elegooofficial/Mars3/README.md

# Mars3
ELEGOO Mars3 Ultra 4k Mono LCD 3D Printer
