elegooofficial/Mars3/MARS 3 BOM.xlsx

研发专用附表 |  |  |  |  |  |  |  | （ MARS 3） BOM
成品料号 |  | 14.0009.100 | 14.0009.101 | 14.0009.104 | 14.0009.102 | 14.0009.103 | 14.0009.106 | S/N | Name | Specification | Qty
取用列 | 不共用物料明细 |  |  |  |  |  |  | 1 | MARS 3 Z-axis connection block | Material; aluminum alloy, die-casting, oil-sprayed black Size; 105*46*55mm | 1
#REF! | 料号 | 04.0010.19 | 04.0010.06C | 04.0010.07B | 04.0010.08B | 04.0010.10B | 04.0010.18 | 2 | MARS 3 medium plate | Material; aluminum alloy, sandblasted and oxidized purplish red Size: 225*225*6mm | 1
#REF! | 名称 | A1 | 电源线 | 电源线 | 电源线 | 电源线 | 电源线 | 3 | MARS 3 - Heat sink | Copper tube + heat sink aluminum sheet Refer to the drawings for the details. | 1
#REF! | 规格 | 品子尾 三孔 3*0.75平方 长度1m/国标 | 品子尾 三孔 3*0.824平方 长度1.0m/美规 | 品子尾 三孔 3*0.75平方 长度1.0m/欧规 | 品子尾 三孔 3*0.75平方 长度1.0m/英规 | 品子尾 三孔 3*0.75平方 长度1.0m/澳规 | 品子尾 三孔 3*0.75平方 长度1.0m/巴西规 | 4 | MARS 3 - Build platform board | Material: Aluminum alloy, sandblasted construction surface, sandblasted and oxidized black for non-construction surface. Size: 150*95.6*10mm | 1
#REF! | 数量 | 1 | 1 | 1 | 1 | 1 | 1 | 5 | MARS 3 - Line rail fixing plate | Aluminum profile+oxidized black | 1
#REF! | 料号 | 11.0001.129 | 11.0001.118 | 11.0001.118 | 11.0001.118 | 11.0001.118 | 11.0001.118 | 6 | MARS 3 - Plate | Die-cast, oil-sprayed black | 1
#REF! | 名称 | MARS 3 国标铭牌标贴 | MARS 3 铭牌标贴 | MARS 3 铭牌标贴 | MARS 3 铭牌标贴 | MARS 3 铭牌标贴 | MARS 3 铭牌标贴 | 7 | 304 stainless steel stud | M8*30 double thread The length is 12mm | 1
#REF! | 规格 | 尺寸：79.8*54.8mm | 尺寸：79.8*54.8mm | 尺寸：79.8*54.8mm | 尺寸：79.8*54.8mm | 尺寸：79.8*54.8mm | 尺寸：79.8*54.8mm | 8 | LCD1260-A1 card | Refer to the drawings for the details. | 1
#REF! | 数量 | 1 | 1 | 1 | 1 | 1 | 1 | 9 | Spring 0.8*12*35 | Stainless steel wire diameter: 0.8 Outer diameter: 12 height: 35 | 1
#REF! | 料号 | 11.0001.128 | 11.0001.113 | 11.0001.114 | 11.0001.115 | 11.0001.116 | 11.0001.130 | 10 | MARS - Five-star handle | Handle injection screw M10*17 screw extension length 17mm screw nickel plating treatment | 1
#REF! | 名称 | MARS 3 国标标签 | MARS 3 美规标签 | MARS 3 欧规标签 | MARS 3 英规标签 | MARS 3 澳规标签 | MARS 3 巴西标签 | 11 | PTZ ball | 15*M8*15 | 1
#REF! | 规格 | 直径18mm 80g不干胶哑膜 | 直径18mm 80g不干胶哑膜 | 直径18mm 80g不干胶哑膜 | 直径18mm 80g不干胶哑膜 | 直径18mm 80g不干胶哑膜 | 直径18mm 80g不干胶哑膜 | 12 | MARS 3 - Lower pressure plate of resin tank | Material: SPCC, electrophoretic black Size: 186.5*135*2.5mm | 1
#REF! | 数量 | 1 | 1 | C3 | C4 | C5 | C6 | 13 | MARS 3 - Upper pressure plate of resin tank | Material: SPCC, electrophoretic black Size: 186.5*135*2.5mm | 1
#REF! | 料号 | D1 | D2 | D3 | D4 | D5 | D6 | 14 | MARS 3 - C2 mainboard bracket | Material: ABS, black Size: 135*16*11mm | 1
#REF! | 名称 | D1 | D2 | D3 | D4 | D5 | D6 | 15 | MARS 3 - Lens pressure plate | Material: SPCC, electrophoretic black Size: 89.2*79.2*1mm | 1
#REF! | 规格 | D1 | D2 | D3 | D4 | D5 | D6 | 16 | MARS 2 series - Limit Switch Baffle | spcc T=1.5mm | 1
#REF! | 数量 | D1 | D2 | D3 | D4 | D5 | D6 | 17 | MARS 3 - Base | Material: ABS, black Size; 227*227*19mm | 1
#REF! | 料号 | E1 | E2 | E3 | E4 | E5 | E6 | 18 | MARS 3 - Shell | Material: ABS, black Size: 227*227*135.5mm | 1
#REF! | 名称 | E1 | E2 | E3 | E4 | E5 | E6 | 19 | MARS 3 - Back cover | Material: ABS, black Size: 164.8*118*10mm | 1
#REF! | 规格 | E1 | E2 | E3 | E4 | E5 | E6 | 20 | MARS 3 - 3.5 inch screen bracket | Material: ABS, black Size: 93.6*76.5*3.9mm | 1
#REF! | 数量 | E1 | E2 | E3 | E4 | E5 | E6 | 21 | MARS 3 - Button cap | Material: ABS, black Size: φ15.8*6.5mm | 1
#REF! | 料号 | F1 | F2 | F3 | F4 | F5 | F6 | 22 | MARS 3 - Lens Hood | Material: ABS, black Size: 136*101*90mm | 1
#REF! | 名称 | F1 | F2 | F3 | F4 | F5 | F6 | 23 | MARS 3 - Resin tank | Material; aluminum alloy, die-casting, oil-sprayed black Size; 209*140*32.8mm | 1
#REF! | 规格 | F1 | F2 | F3 | F4 | F5 | F6 | 24 | MARS 3 - Lens holder | Material: ABS, black Size: 90*80*22mm | 1
#REF! | 数量 | F1 | F2 | F3 | F4 | F5 | F6 | 25 | MARS 2 series - Z-axis baffle | Plastic, black, surface sunburning treatment | 1
#REF! | 料号 | G1 | G2 | G3 | G4 | G5 | G6 | 26 | MARS 3 - Cover | Material: PC, red, unmodified Size: 227*227*284mm | 1
#REF! | 名称 | G1 | G2 | G3 | G4 | G5 | G6 | 27 | MARS 3 - Silicone Gasket | Black silicone 89.2*79.2*1mm | 1
#REF! | 规格 | G1 | G2 | G3 | G4 | G5 | G6 | 28 | MARS 3 - PVC surface sticker | Material: PVC, black highlight Size: 110.4*106.9*0.5mm | 1
#REF! | 数量 | G1 | G2 | G3 | G4 | G5 | G6 | 29 | MARS 3 - Linear rail + slider | BGW15CA full length 242mm | 1
 |  |  |  |  |  |  |  | 30 | MARS 3 - Screw motor | 42HD6039-02 Motor, length 265 | 1
 |  |  |  |  |  |  |  | 31 | MARS 3 - Motor cable | 4pin cable ph2.0 6p+ph2.54 4p cable 100mm | 1
 |  |  |  |  |  |  |  | 32 | MARS pro - Plastic clearance nut | POM material total length 25mm with spring | 1
 |  |  |  |  |  |  |  | 33 | Damping pad | 42 stepper motor damping pad | 1
 |  |  |  |  |  |  |  | 34 | MARS 2 series - Upper shell of photoelectric limit switch | Texture treatment of PC surface | 1
 |  |  |  |  |  |  |  | 35 | MARS 2 series - Lower shell of photoelectric limit switch | Texture treatment of PC surface | 1
 |  |  |  |  |  |  |  | 36 | MARS 3 series- Limit switch cable | 3pin line ph2.54+ph2.54 3pin line Length 120mm 1007 26 OD1.3 | 1
 |  |  |  |  |  |  |  | 37 | MARS 2 series - Photoelectric limit switch PCB | PCB module | 1
 |  |  |  |  |  |  |  | 38 | MARS 3 - Mainboard | C2 6.6 inch 4K driver board | 1
 |  |  |  |  |  |  |  | 39 | KF terminal: green | 2P pitch 5.08 | 2
 |  |  |  |  |  |  |  | 40 | MARS 3 - PCB-power |  | 1
 |  |  |  |  |  |  |  | 41 | MARS 3 - Touch screen | 3.5 inch screen | 1
 |  |  |  |  |  |  |  | 42 | MARS 3 - Parallel cable of touch screen | Same direction length 350mm 40pin | 1
 |  |  |  |  |  |  |  | 43 | MARS 3 -Constant-current module | Step-down constant current decompression from 24V to 18.5V | 1
 |  |  |  |  |  |  |  | 44 | MARS 3 - Light board | 6*6 36 core + copper plate | 1
 |  |  |  |  |  |  |  | 45 | DC socket | 5.5*2.5 | 1
 |  |  |  |  |  |  |  | 46 | MARS 3 -The connection wire from DC to front control board | Full length 300mm 0.75RV VH3.96 rubber shell | 1
 |  |  |  |  |  |  |  | 47 | MARS 3 - The connection wire from the front PCB to the mainboard control board | Full length 250mm 0.75RV VH3.96 rubber shell | 1
 |  |  |  |  |  |  |  | 48 | MARS 3 - The connecting wire from LED light board to constant-current module | Full length 250mm 0.75RV VH3.96 rubber shell (white and black wire; white is positive poles , black is negative poles) | 1
 |  |  |  |  |  |  |  | 49 | MARS 3 - The connecting wire from the constant-current module to the mainboard control board | Full length: 150mm 0.75RV VH3.96 rubber shell | 1
 |  |  |  |  |  |  |  | 50 | MARS 3 - Cooling fan | 4515 cable length 80mm, speed 6000r with 2pin XH2.54 terminal | 1
 |  |  |  |  |  |  |  | 51 | Left Angle - USB adapter cable | Full length 250mm | 1
 |  |  |  |  |  |  |  | 52 | MARS 3 - Adapter | Pinzi tail 24v 3A | 1
 |  |  |  |  |  |  |  | 53 | Power cable |  | 1
 |  |  |  |  |  |  |  | 58 | MARS 3 - Mono LCD screen | 6.6 inch | 1
 |  |  |  |  |  |  |  | 59 | MARS 3 - LCD screen cable | Full length: 80mm, impedance: 100 ohm | 1
 |  |  |  |  |  |  |  | 60 | MARS 3 - Lens | Size: 85.5*74.5*33mm | 1
 |  |  |  |  |  |  |  | 61 | MARS 3 - Glass | Ultra-white glass Size: 154.36*99.1*2mm (actual thickness: 1.9mm) | 1
 |  |  |  |  |  |  |  | 62 | MARS 3 - Screen protector | Size: 176*120*0.06mm with peelable sticker | 2
 |  |  |  |  |  |  |  | 63 | MARS 3 - Protective film of resin tank | Size: 164.7*108.6*0.06mm with peelable sticker | 1
 |  |  |  |  |  |  |  | 64 | MARS 3 - Screen fixing tape | Size: 164.4*110.1*0.08mm | 1
 |  |  |  |  |  |  |  | 65 | MARS 3 - Double-sided tape | Double-sided adhesive black 153*1.8*0.1mm | 4
 |  |  |  |  |  |  |  | 66 | MARS 3 - Double-sided tape | Double-sided adhesive black 93*1.8*0.1mm | 4
 |  |  |  |  |  |  |  | 67 | 6.6 inch FEP release film V2.0 outsourcing semi-finished products |  | 1
 |  |  |  |  |  |  |  | 68 | Thermal mud | 0.3ML | 1
 |  |  |  |  |  |  |  | 69 | PE bag | Size: (24+25)*48cm (inner sleeve) | 1
 |  |  |  |  |  |  |  | 70 | PE bag | (23+20)*75cm/material PE+ cable tie | 1
 |  |  |  |  |  |  |  | 71 | MARS 3 - packaging box | External dimension: 193*193*55mm Material K3K 140" | 1
 |  |  |  |  |  |  |  | 72 | Gloves | Large Latex gloves | 2双
 |  |  |  |  |  |  |  | 73 | Black plastic shovel |  | 1
 |  |  |  |  |  |  |  | 74 | Flying Leopard Angled Putty Knife 1.5 width | Please be sure to buy the oblique mouth, otherwise it cannot be used | 1
 |  |  |  |  |  |  |  | 75 | Hexagonal Ball End Wrench | M5 length 90 S2 alloy excluding shank diameter | 1
 |  |  |  |  |  |  |  | 76 | Allen wrench | M3 full length 91mm, length error ±5mm S2 alloy | 1
 |  |  |  |  |  |  |  | 77 | Allen wrench | M2.5 total length 101.5mm, length error ±5mm s2 alloy steel | 1
 |  |  |  |  |  |  |  | 78 | Allen wrench | M2 full length 83 S2 alloy steel nickel plated | 1
 |  |  |  |  |  |  |  | 79 | Paper funnel |  | 10
 |  |  |  |  |  |  |  | 80 | Facial Mask |  | 2
 |  |  |  |  |  |  |  | 81 | Cutting pliers | Length 130 width 76 | 1
 |  |  |  |  |  |  |  | 82 | U Disk | 4G | 1
 |  |  |  |  |  |  |  | 83 | ST straight grain handle | M4*40 | 2
 |  |  |  |  |  |  |  | 84 | Self-sealing pocket | 100*150mm | 2
 |  |  |  |  |  |  |  | 85 | MARS3 Slicing Software | chitubox | 1
 |  |  |  |  |  |  |  | 86 | Acetate tape | Width 10mm, use length 0.038m, black (adhesive tape length 30m/roll) | 0.038m
 |  |  |  |  |  |  |  | 87 | Hexagon socket head tapping screw | M3*8 carbon steel hardened, black zinc-plated salt spray 24H | 10
 |  |  |  |  |  |  |  | 88 | Cup Head Hexagon Screw | M3*6 carbon steel hardened, black zinc plated, salt spray test 24h | 22
 |  |  |  |  |  |  |  | 89 | Double pass copper pillar | M3*10 salt spray 24H | 2
 |  |  |  |  |  |  |  | 90 | Flat head hexagon socket screw | M3*5 stainless steel 304 silver salt spray 24H | 19
 |  |  |  |  |  |  |  | 91 | Round head hexagon socket self-tapping screws | M3*12 carbon steel hardened, black zinc-plated salt spray 24H | 6
 |  |  |  |  |  |  |  | 92 | MARS-pro Phillips round head self-tapping screws | M3*12 carbon steel hardened black zinc-plated salt spray 24H | 18
 |  |  |  |  |  |  |  | 93 | Socket head cap screw | M4*14 carbon steel hardened, black zinc-plated salt spray 24H | 12
 |  |  |  |  |  |  |  | 94 | Socket head cap screw | M3*12 carbon steel hardened, black zinc-plated salt spray 24H | 2
 |  |  |  |  |  |  |  | 95 | Socket head cap screw | M6*10 stainless steel 304 silver salt spray 24H | 4
 |  |  |  |  |  |  |  | 96 | Set screw | M3*8 stainless steel 304 silver Kana glue, salt spray 24H | 1
 |  |  |  |  |  |  |  | 97 | Flat head hexagon socket screw | M4*12 stainless steel 304 silver salt spray 24H | 10
 |  |  |  |  |  |  |  | 98 | Socket head cap screw | M4*10 carbon steel hardened, black zinc-plated salt spray 24H | 6
 |  |  |  |  |  |  |  | 99 | Phillips round head self-tapping screws | M3*22 carbon steel hardened, black zinc-plated salt spray 24H | 2
 |  |  |  |  |  |  |  | 100 | Flat head Hexagon socket screw | M3*8 carbon steel hardened, black zinc-plated salt spray 24H | 6
 |  |  |  |  |  |  |  | 101 | M3 lock nut | M3 carbon steel hardened, black zinc-plated salt spray test 24h | 4
 |  |  |  |  |  |  |  | 102 | Socket head cap screw | M3*5 carbon steel hardened, black zinc-plated salt spray test 24h | 2
 |  |  |  |  |  |  |  | 103 | Socket head cap screw | M3*8 carbon steel hardened, black zinc-plated salt spray 24H | 2
 |  |  |  |  |  |  |  | 104 | 3D Printer Fragile Warning Label |  | 1
 |  |  |  |  |  |  |  | 105 | MARS 3 - Carton | External size: 56.5*27*28.5cm Material S=S EB pit | 1
 |  |  |  |  |  |  |  | 106 | MARS 3 -Transit cases | Outer size: 58*55.5*31cm material A=A 100 reinforced | 0.5
 |  |  |  |  |  |  |  | 107 | MARS 3 - Pearl cotton | Size: 55.5*26.5*2.3cm | 2
 |  |  |  |  |  |  |  | 108 | MARS 3 - Pearl cotton side panels | Size: 55.5*23*2.3cm | 2
 |  |  |  |  |  |  |  | 109 | MARS 3 - Pearl cotton front | Size: 22.7*22.7*2.3cm | 2
 |  |  |  |  |  |  |  | 110 | MARS 3 -Pearl cotton 1 | Size: 22.8*11*2.4cm | 1
 |  |  |  |  |  |  |  | 111 | MARS 3 - Pearl cotton 2 | Size: 22.7*5.8*2.4cm | 1
 |  |  |  |  |  |  |  | 112 | MARS 3 - Pearl Cotton Profile-up | Size: 16*15.8*17.3cm | 1
 |  |  |  |  |  |  |  | 113 | MARS 3 - Pearl Cotton Profile-down | Size: 21*20.5*11.2cm | 1
 |  |  |  |  |  |  |  | 114 | MARS 3 - Manual | Size: 150*150mm | 1
 |  |  |  |  |  |  |  | 117 | Heat-shrink tubing | Inner diameter φ4*20mm | 2
 |  |  |  |  |  |  |  | 118 | Chitubox pro - key card | Card size: 85.6*53.98mm+key comparison code | 1
 |  |  |  |  |  |  |  | 119 | Mars 3 NamePlate Sticker | size：79.8*54.8mm | 1
 |  |  |  |  |  |  |  | 120 | Mars 3 American Standard Sticker | Diameter：18mm 80g Sticker labels with Matte lamination | 1
