elegooofficial/Mars3/MARS 3  PCB/MARS 3 series- Limit switch cable/BOM/Limit switch-BOM20201212.xls

UV driver board(Output Adjustable)-BOM
No. | Type | Package | Specification | Designator | Qty
1 | IC | SOT-89 | AP331AWRG---SOT23-5 | U1 | 1
2 | IC |  | LA218; groove width 5mm | U2 | 1
3 | Resistance | R-0805 | 820R ±1% | R1.R2,R3,R4,R5,R6 | 6
4 | Resistance | R-0603 | 10K ±1% | R7,R9,R10 | 3
5 | Resistance | R-0603 | 4.7K ±1% | R8 | 1
6 | Capacitor | C-0603 | 0.1UF/50V±10% | C1 | 1
7 | LED | LED-0603 | Red 0603 | LED1 | 1
8 | Angled connection terminal | XH2.54A-3P | XH2.54A-3P white | J1 | 1
9 | PCB Board |  | Black oil |  | 1
