elegooofficial/Mars3/(list of files, cad)

Other CAD files:
MARS 3 Wiring/MARS 3 - The connecting wire from the constant-current module to the mainboard control board .dwg
MARS 3 Wiring/MARS 3 - The connection wire from the front PCB to the mainboard control board.dwg
MARS 3 Mechanical/CAD/MARS 3 - C2 mainboard bracket.dwg
MARS 3 Mechanical/CAD/MARS 3 - Protective film of resin tank.dwg
MARS 3 Wiring/MARS 3 - The connecting wire from LED light board to constant-current module .dwg
MARS 3 Mechanical/CAD/MARS 3 - Lens Hood.dwg
MARS 3 Wiring/MARS 3 - The connecting wire from LED light MARS 3 series- Limit switch cable.dwg
MARS 3 Mechanical/CAD/MARS 3 - Glass.dwg
MARS 3 Wiring/MARS 3 -The connection wire from DC to front control board.dwg
MARS 3 Mechanical/CAD/Spring 0.8x12x35.dwg
MARS 3 Wiring/MARS 3 - Motor cable.dwg
MARS 3 Mechanical/CAD/MARS 3 medium plate .dwg
MARS 3 Mechanical/CAD/MARS 3 -Button cap.dwg
MARS 3 Wiring/MARS 3 series- Limit switch cable.dwg
MARS 3 Mechanical/CAD/MARS 3 - Screen fixing tape.dwg
MARS 3 Wiring/MARS 3 - LCD screen cable.dwg
MARS 3 Mechanical/CAD/MARS 3 - Lower pressure plate of resin tank.dwg
MARS 3 Wiring/Left Angle - USB adapter cable.dwg
MARS 3 Mechanical/CAD/Damping pad.dwg
MARS 3 Mechanical/CAD/MARS 2 series - Upper shell of photoelectric limit switch.dwg
MARS 3 Mechanical/CAD/MARS 3 Z-axis connection block.dwg
MARS 3 Mechanical/CAD/MARS 2 series - Lower shell of photoelectric limit switch.dwg
MARS 3 Mechanical/CAD/MARS - Five-star handle.dwg
MARS 3 Mechanical/CAD/LCD1260-A1 card.dwg
MARS 3 Mechanical/CAD/MARS 3 - Lens holder.dwg
MARS 3 Mechanical/CAD/MARS 3 - Base.dwg
MARS 3 Mechanical/CAD/MARS 3 - Shell.dwg
MARS 3 Mechanical/CAD/MARS 3 - Heat sink.dwg
MARS 3 Mechanical/CAD/MARS 3 - 3.5 inch screen bracket.dwg
MARS 3 Mechanical/CAD/MARS 3 - Linear rail + slider.dwg
MARS 3 Mechanical/CAD/MARS 3 - Cover.dwg
MARS 3 Mechanical/CAD/MARS 3 - Build platform board.dwg
MARS 3 Mechanical/CAD/MARS 3 - Silicone Gasket.dwg
MARS 3 Mechanical/CAD/MARS 3 - Back cover.dwg
MARS 3 Mechanical/CAD/MARS 3 - Line rail fixing plate.dwg
MARS 3 Mechanical/CAD/PTZ ball.dwg
MARS 3 Mechanical/CAD/MARS 3 - Lens pressure plate.dwg
MARS 3 Mechanical/CAD/MARS 3 -Plate.dwg
MARS 3 Mechanical/CAD/MARS 3 - Motor cable.dwg
MARS 3 Mechanical/CAD/MARS 3 - Lens.dwg
MARS 3 Mechanical/CAD/MARS 3 - PVC surface sticker.dwg
MARS 3 Mechanical/CAD/MARS 3 - Upper pressure plate of resin tank.dwg
MARS 3 Mechanical/CAD/304 stainless steel stud.dwg
MARS 3 Mechanical/CAD/MARS 3 - Resin tank.dwg
MARS 3 Mechanical/CAD/MARS pro - Plastic clearance nut.dwg
