elegooofficial/Mars3/MARS 3  Wiring/Left Angle - USB adapter cable.pdf

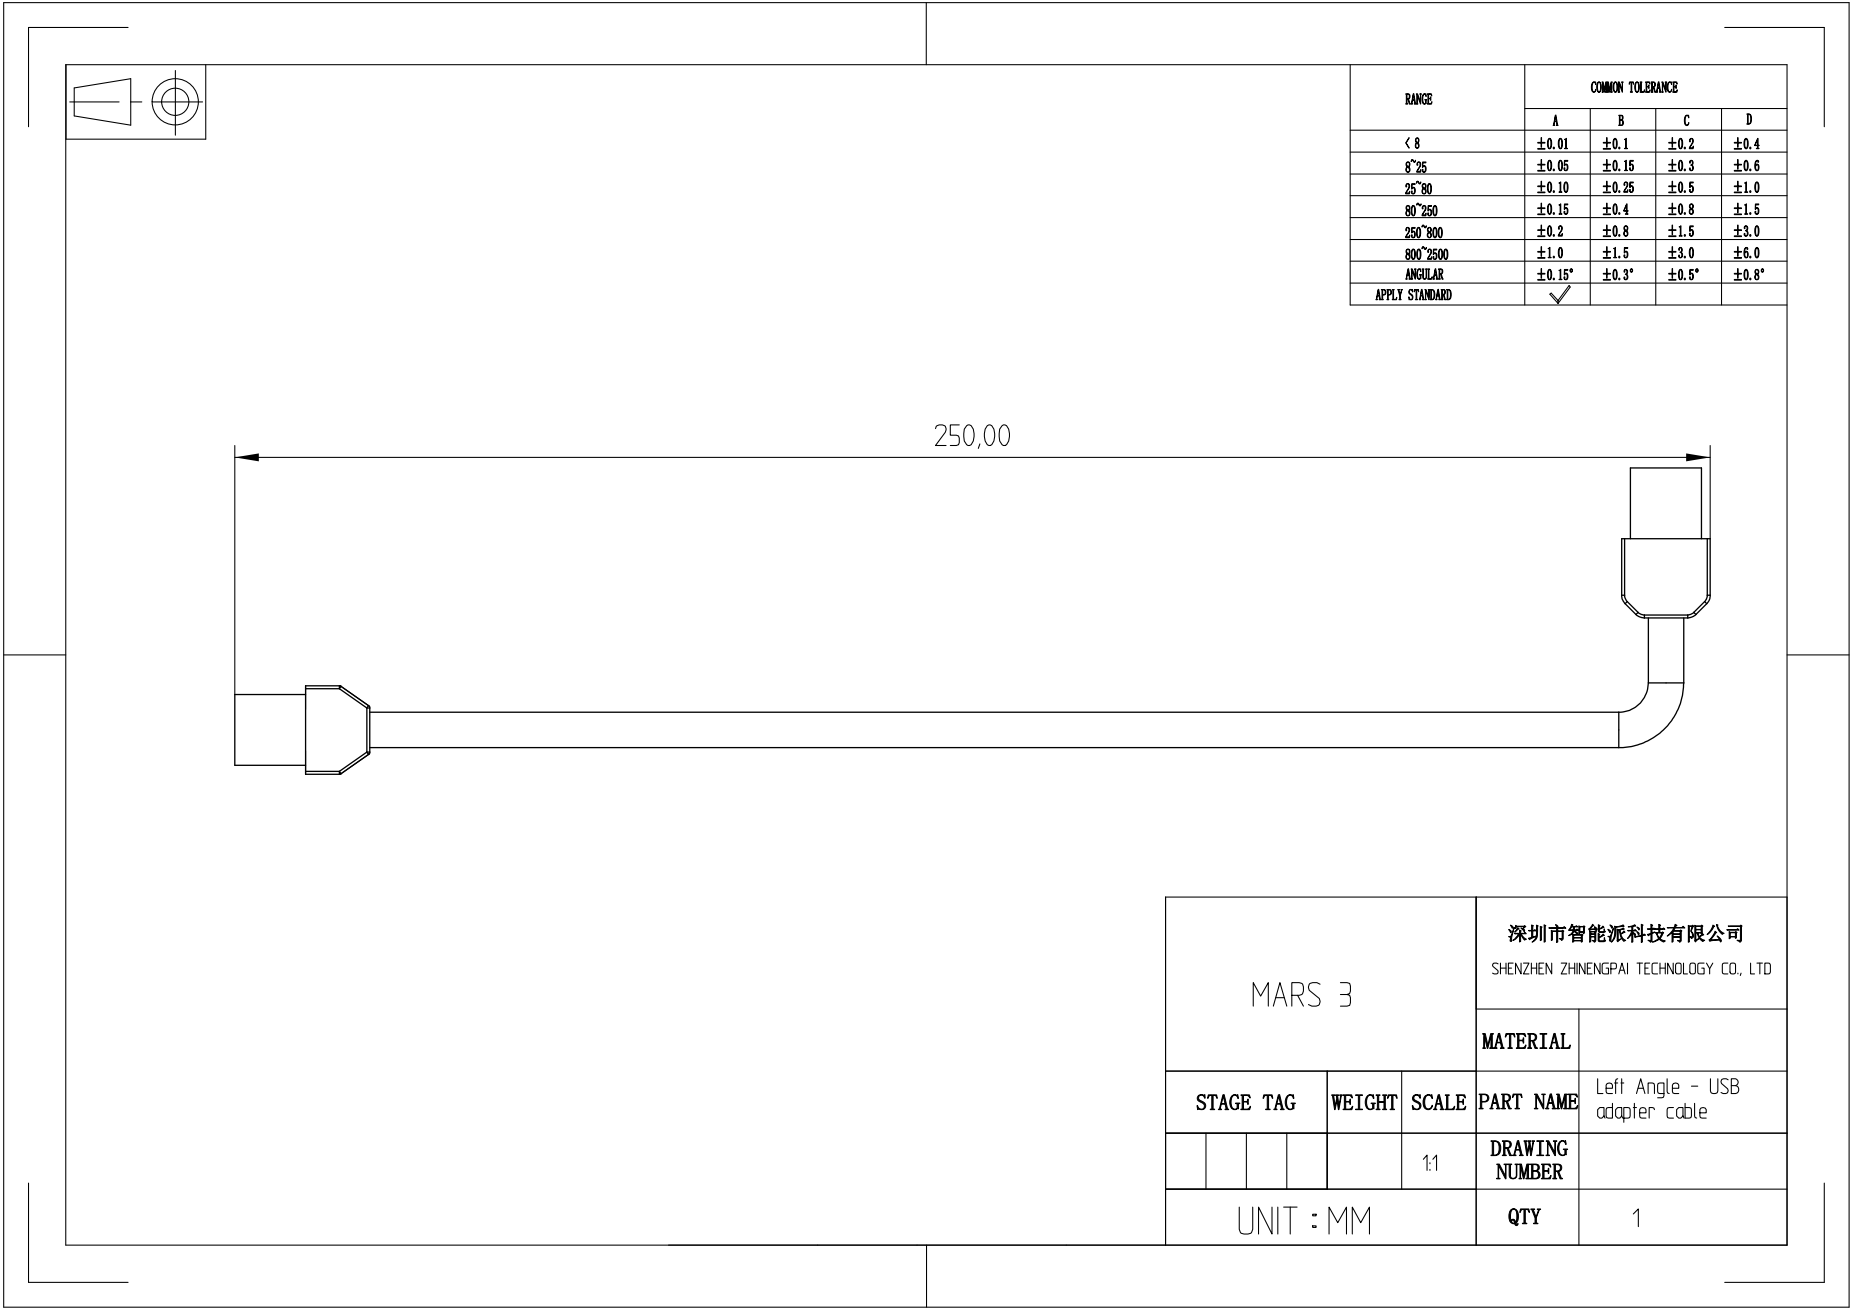
[picture p1: page 1]
