elegooofficial/Mars3/MARS 3  Wiring/MARS 3 -  The connecting wire from LED light board to constant-current module .pdf

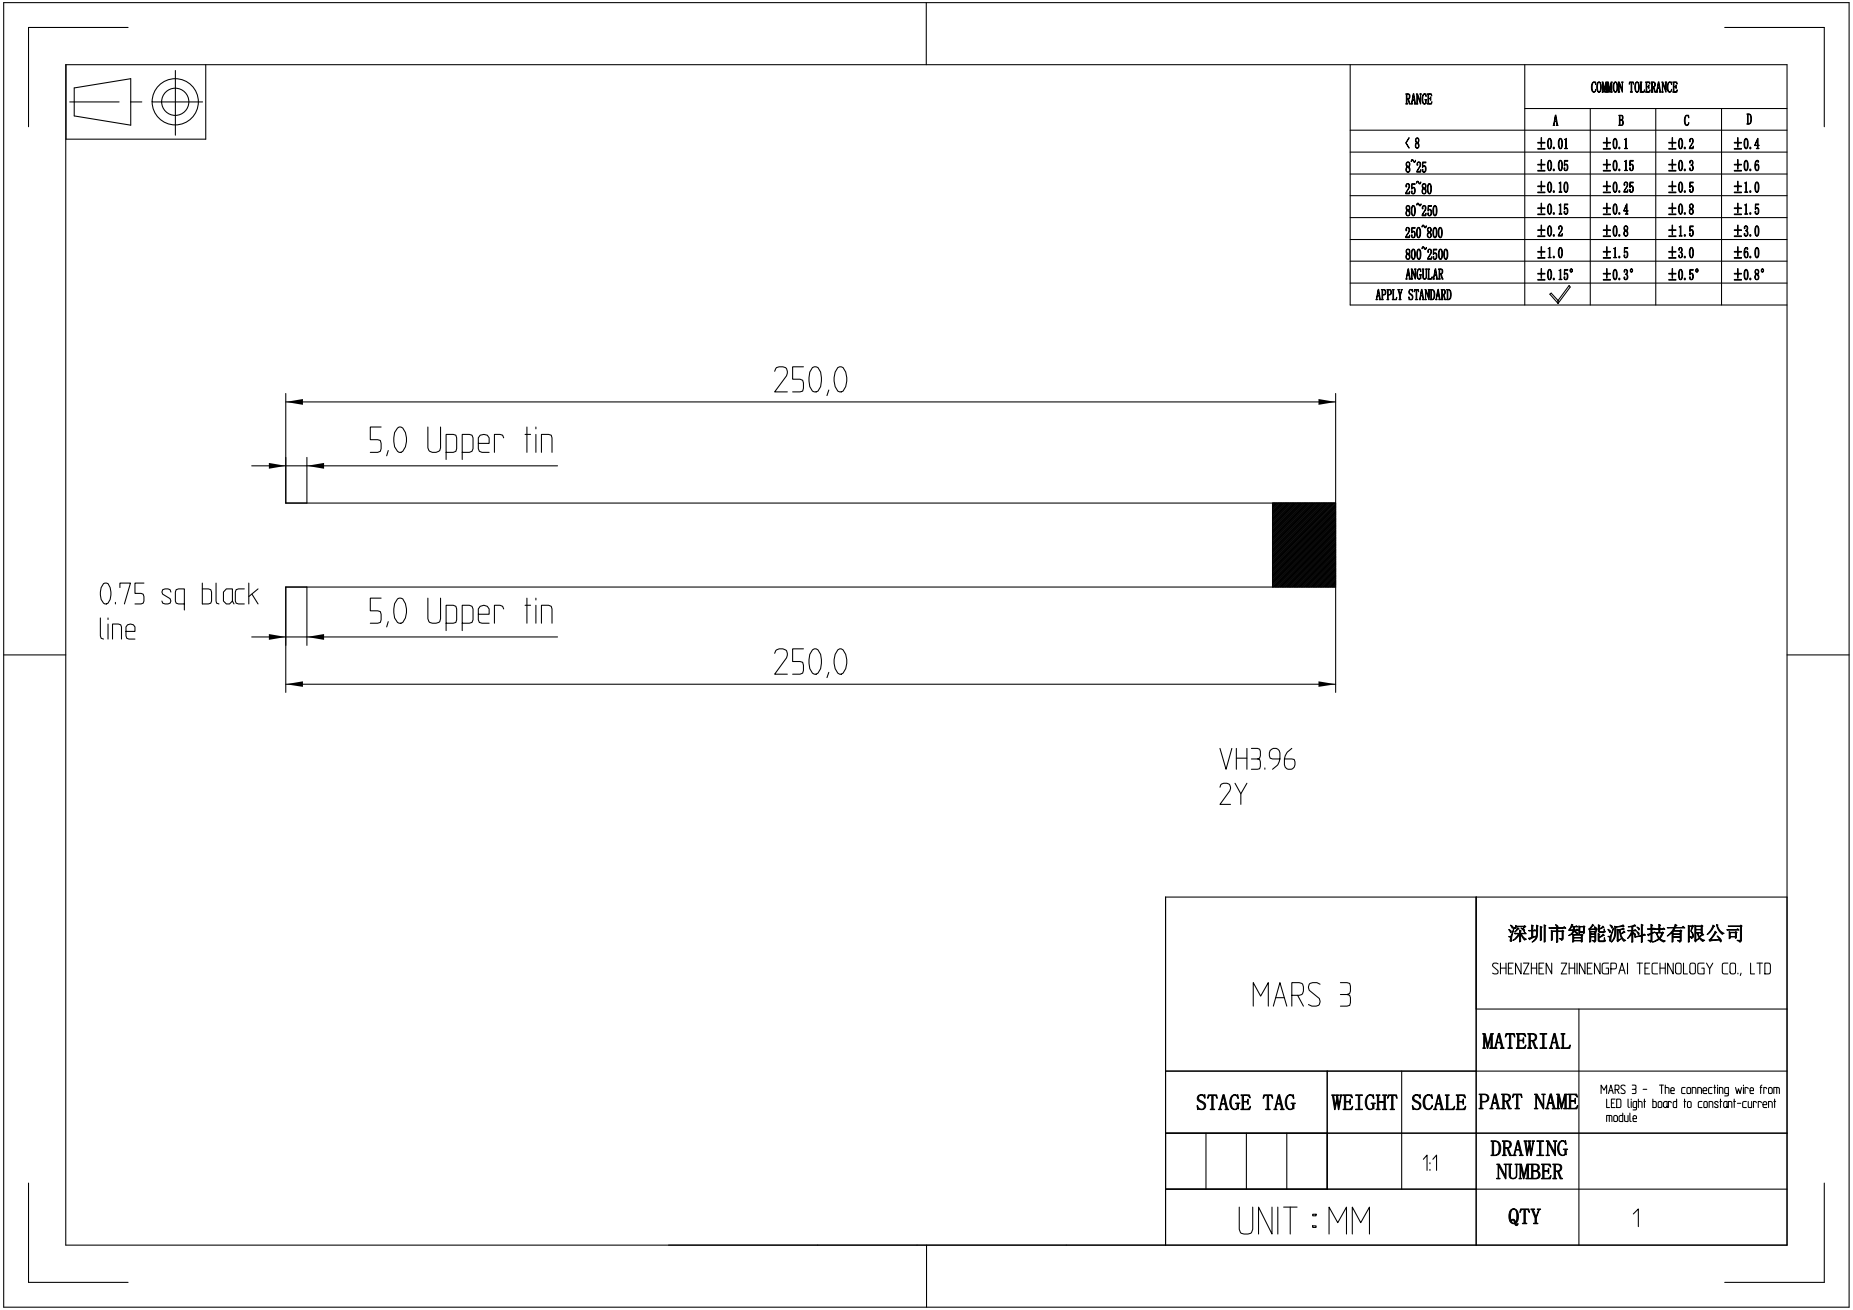
[picture p2: page 1]
