elegooofficial/Mars3/MARS 3  Wiring/MARS 3 - LCD screen cable.pdf

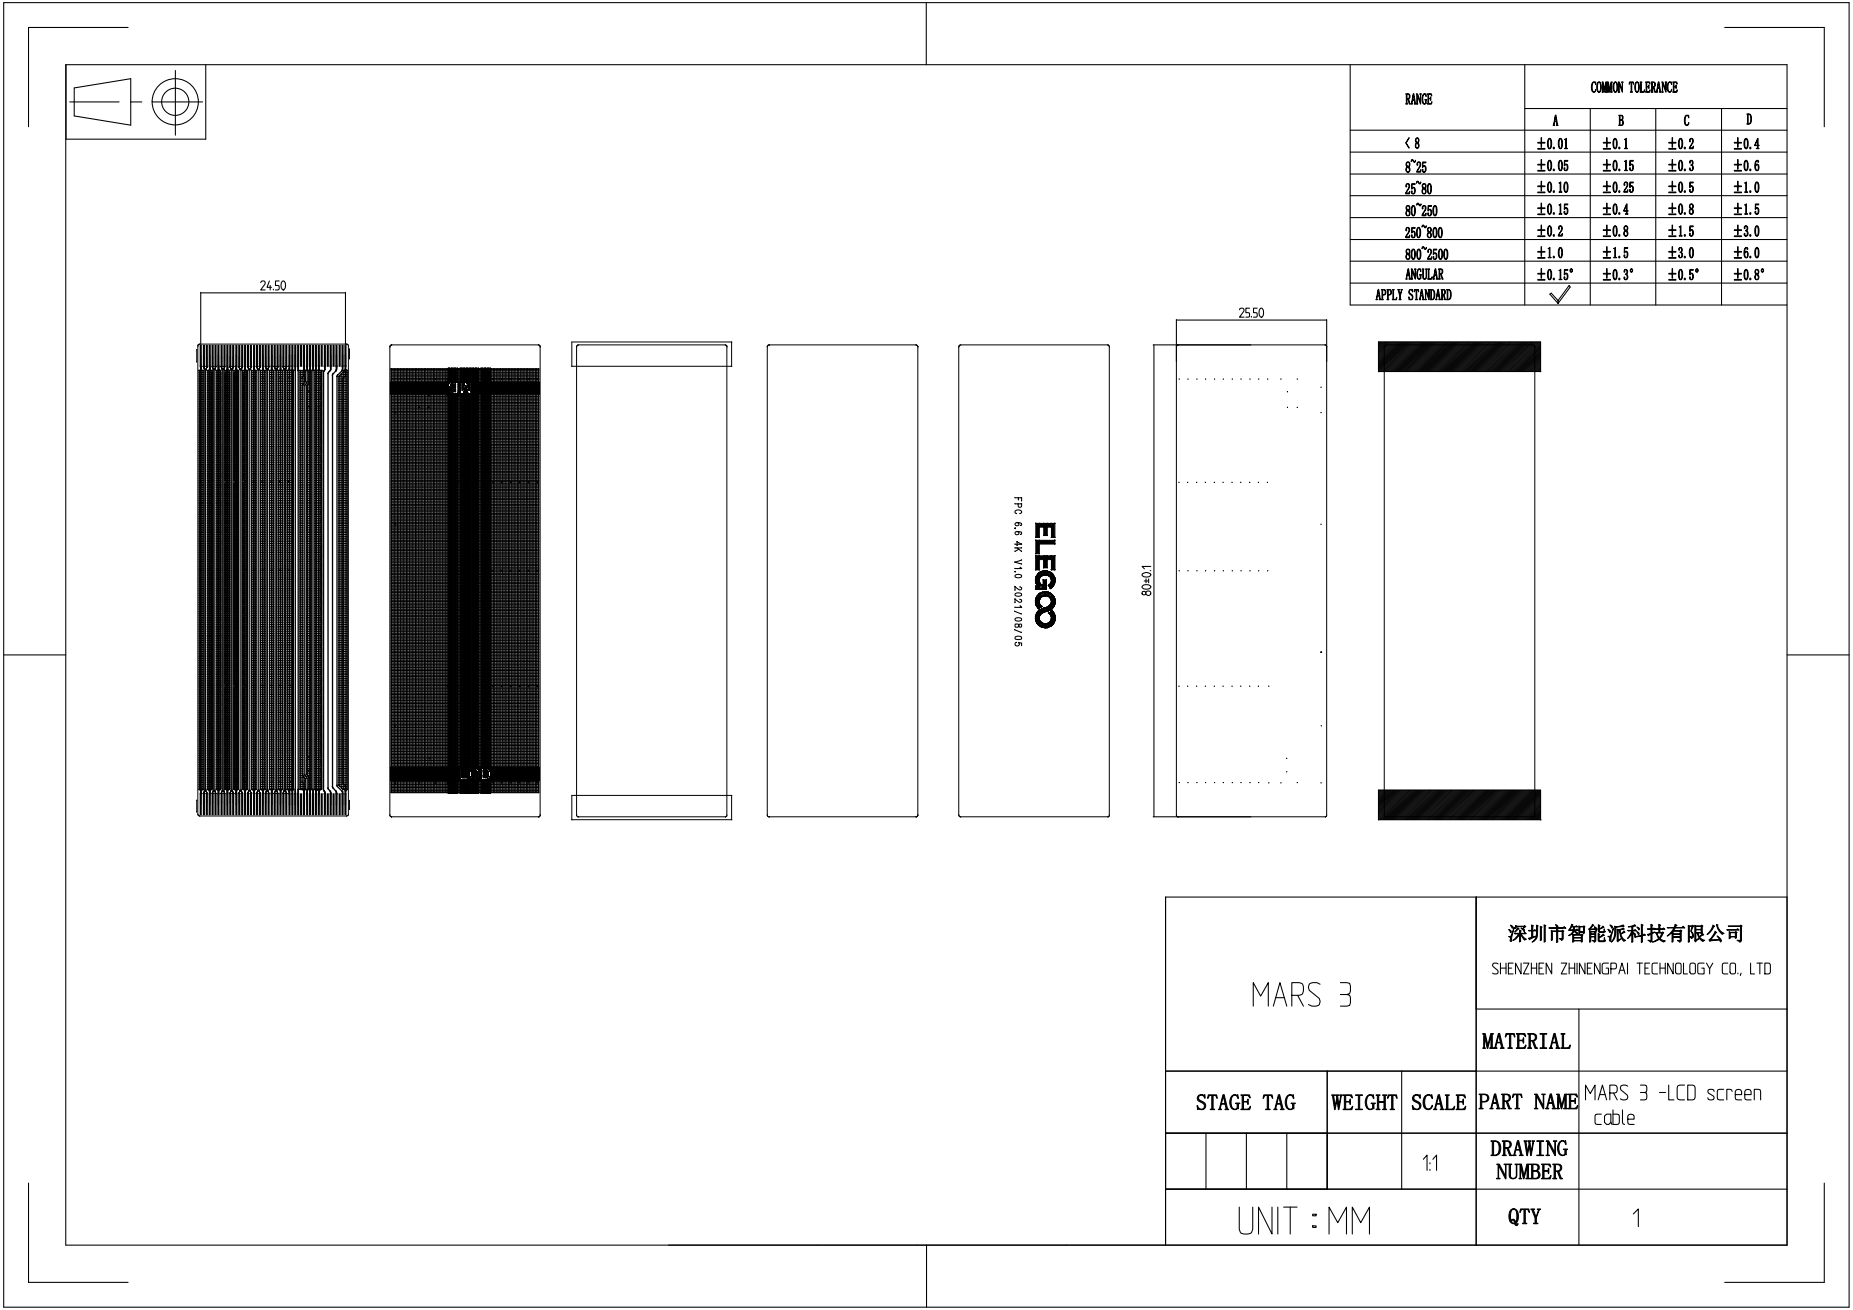
[picture p3: page 1]
