elegooofficial/Mars3/MARS 3  Wiring/MARS 3 - Motor cable.pdf

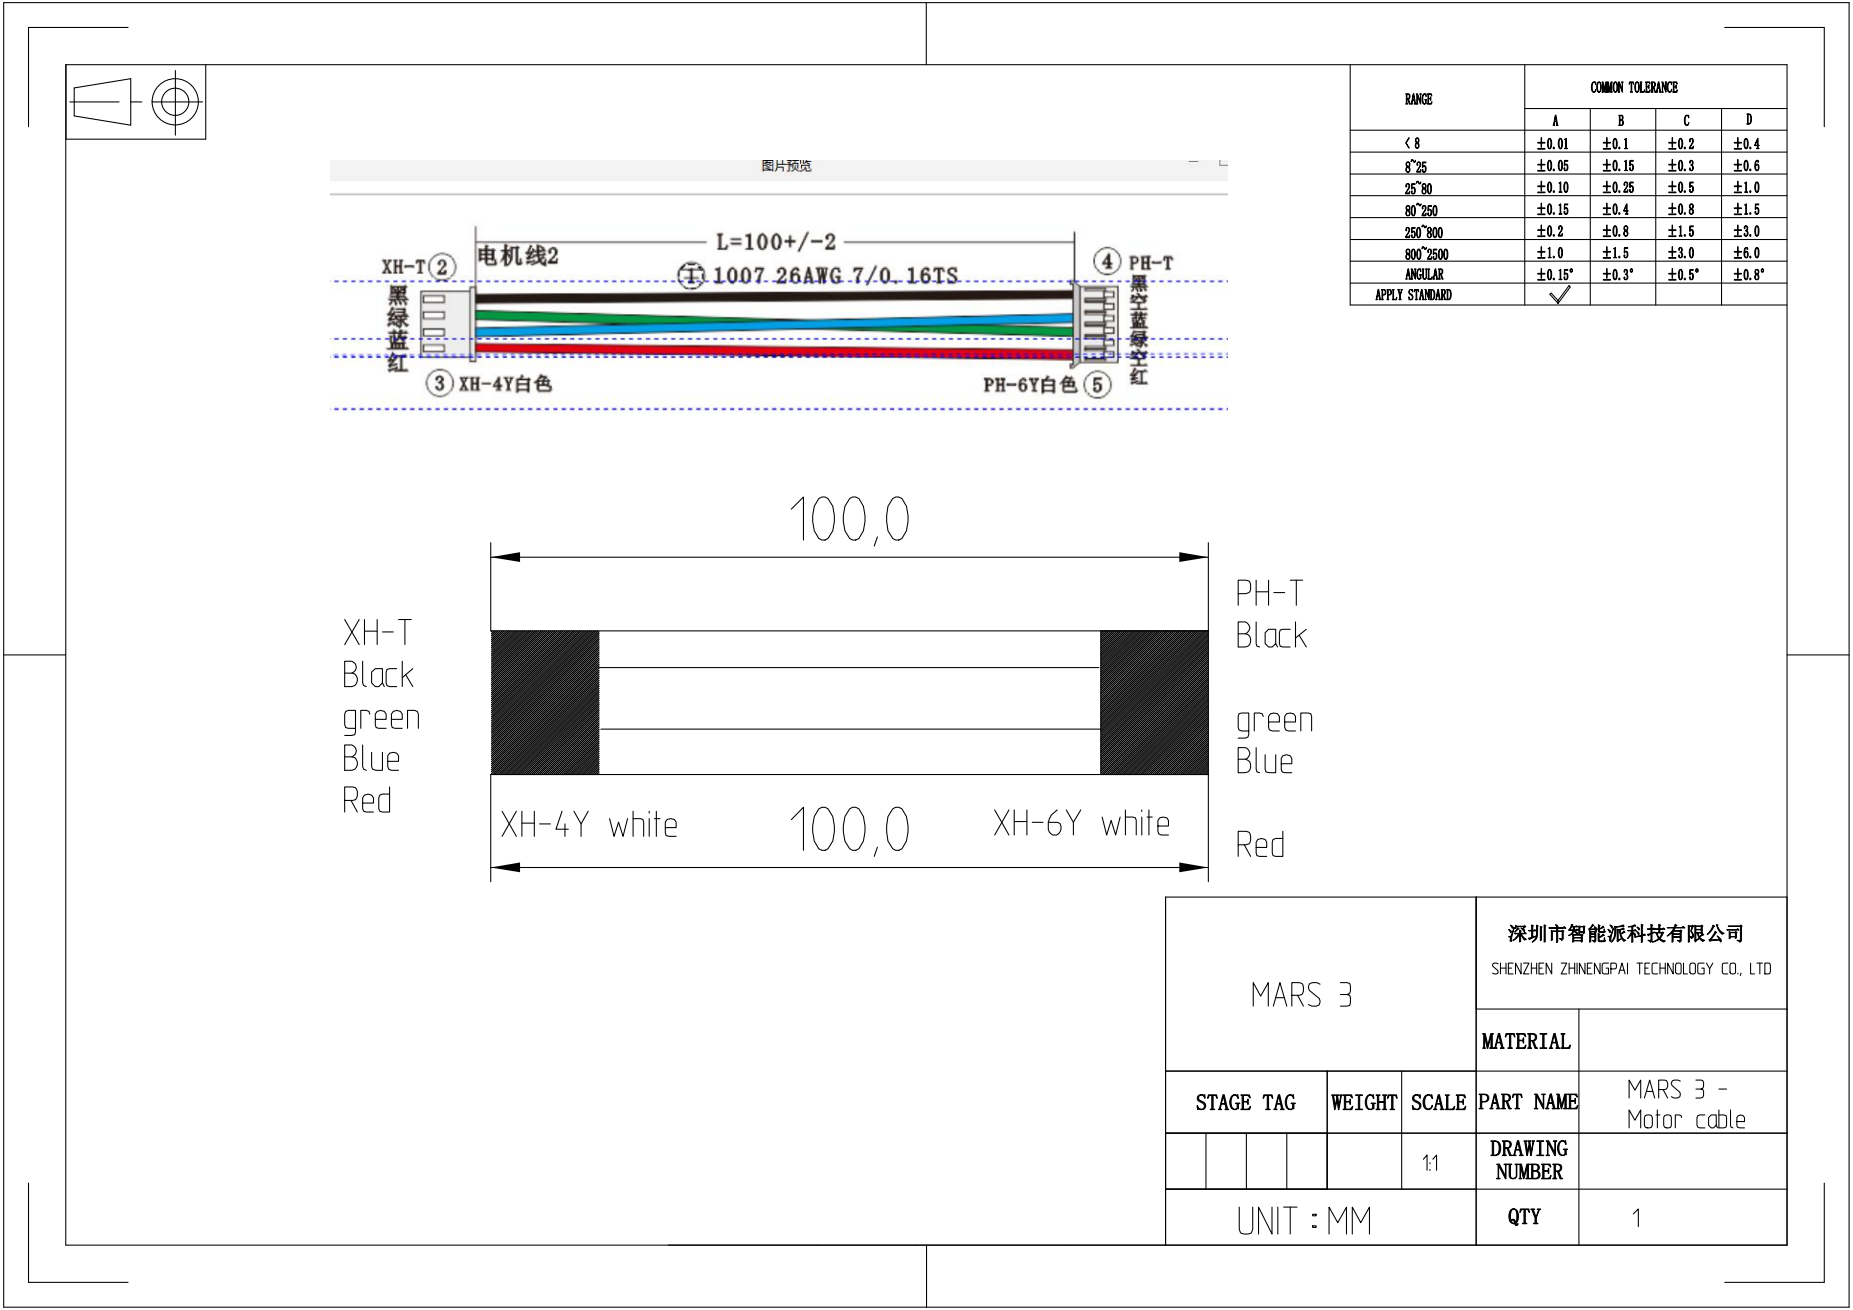
[picture p4: page 1]
