elegooofficial/Mars3/MARS 3  Wiring/MARS 3 - The connecting wire from the constant-current module to the mainboard control board.pdf

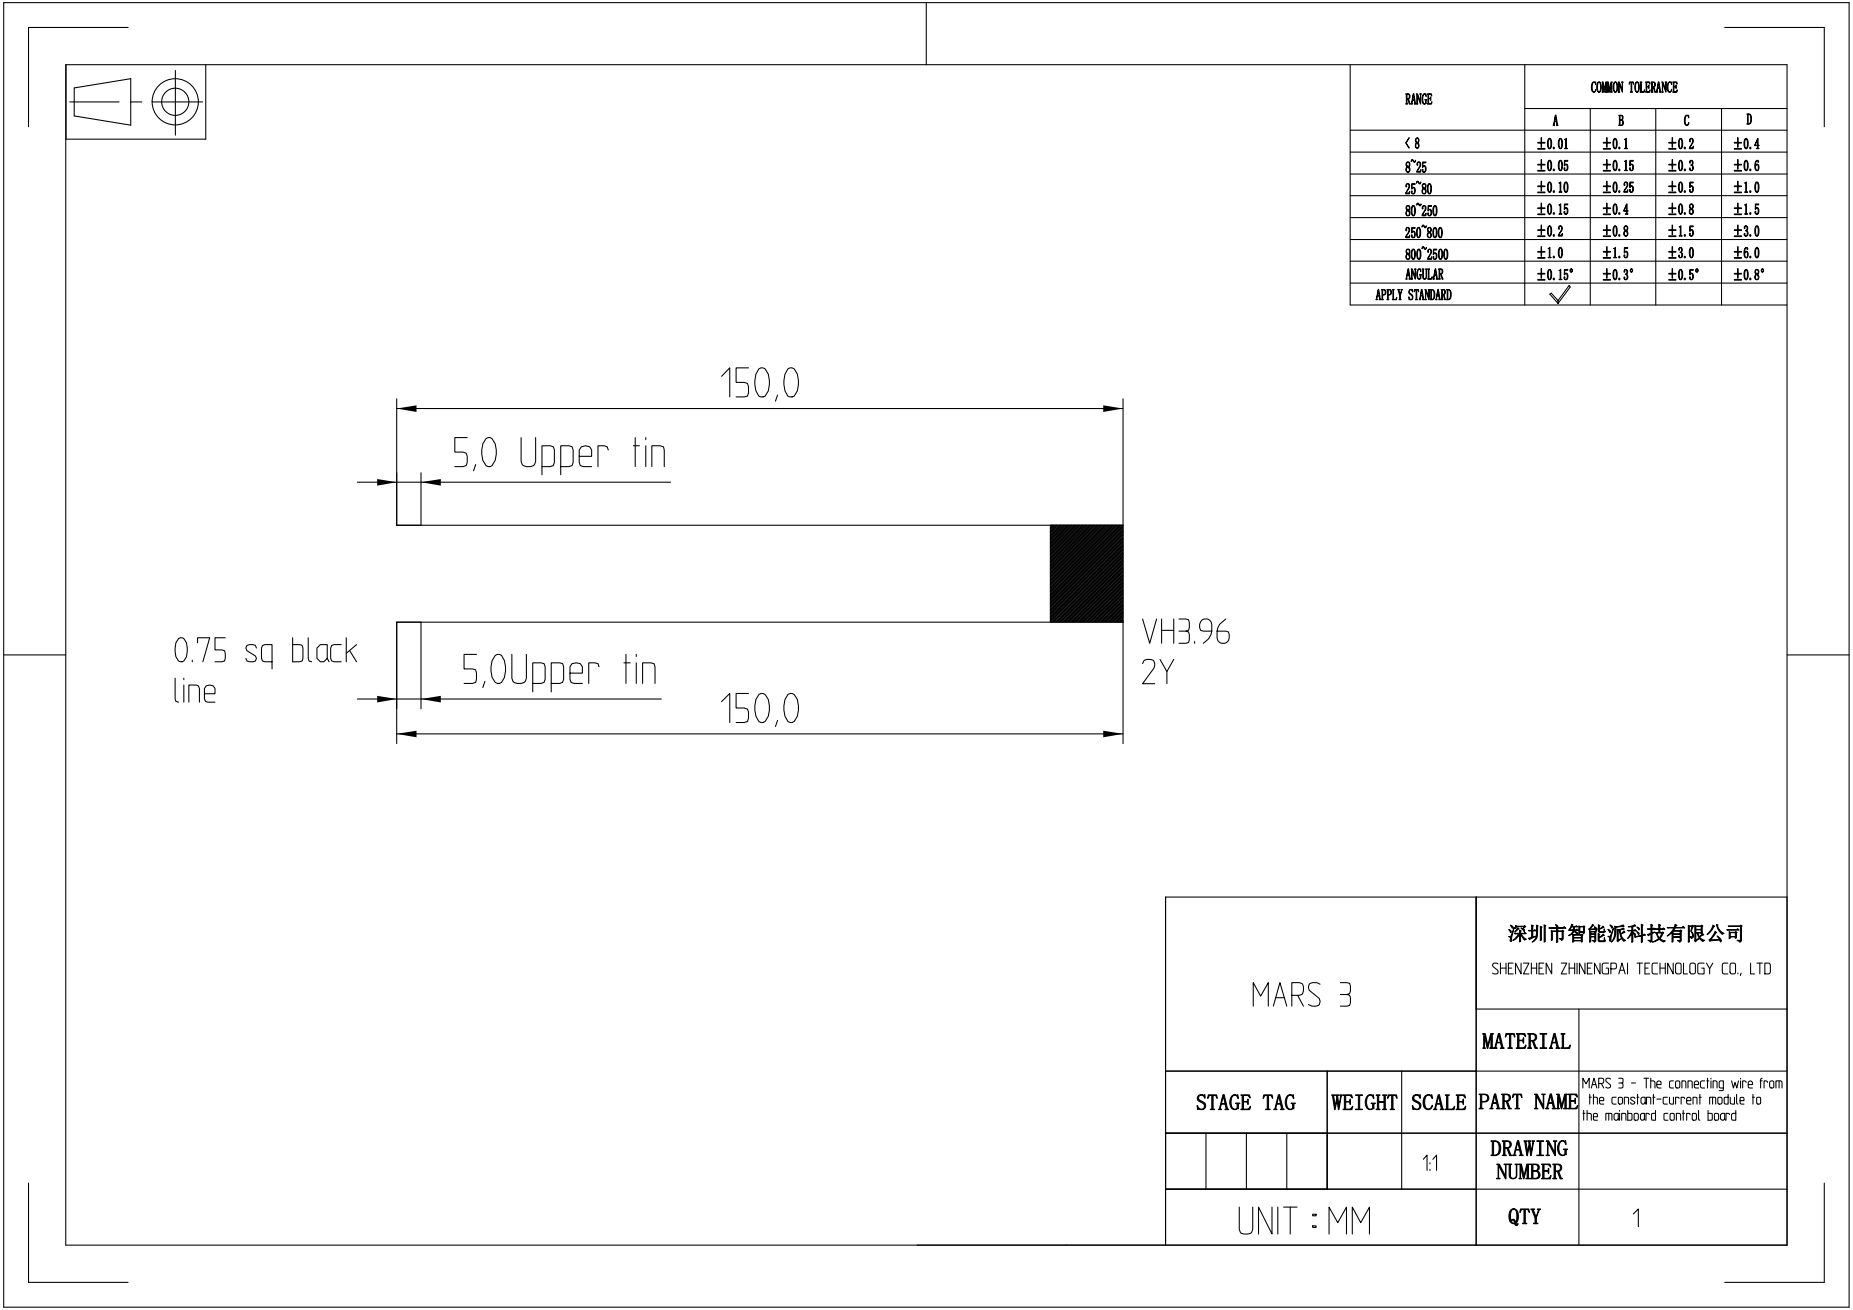
[picture p5: page 1]
