elegooofficial/Mars3/MARS 3  Wiring/MARS 3 - The connection  wire from the front PCB to the mainboard control board.pdf

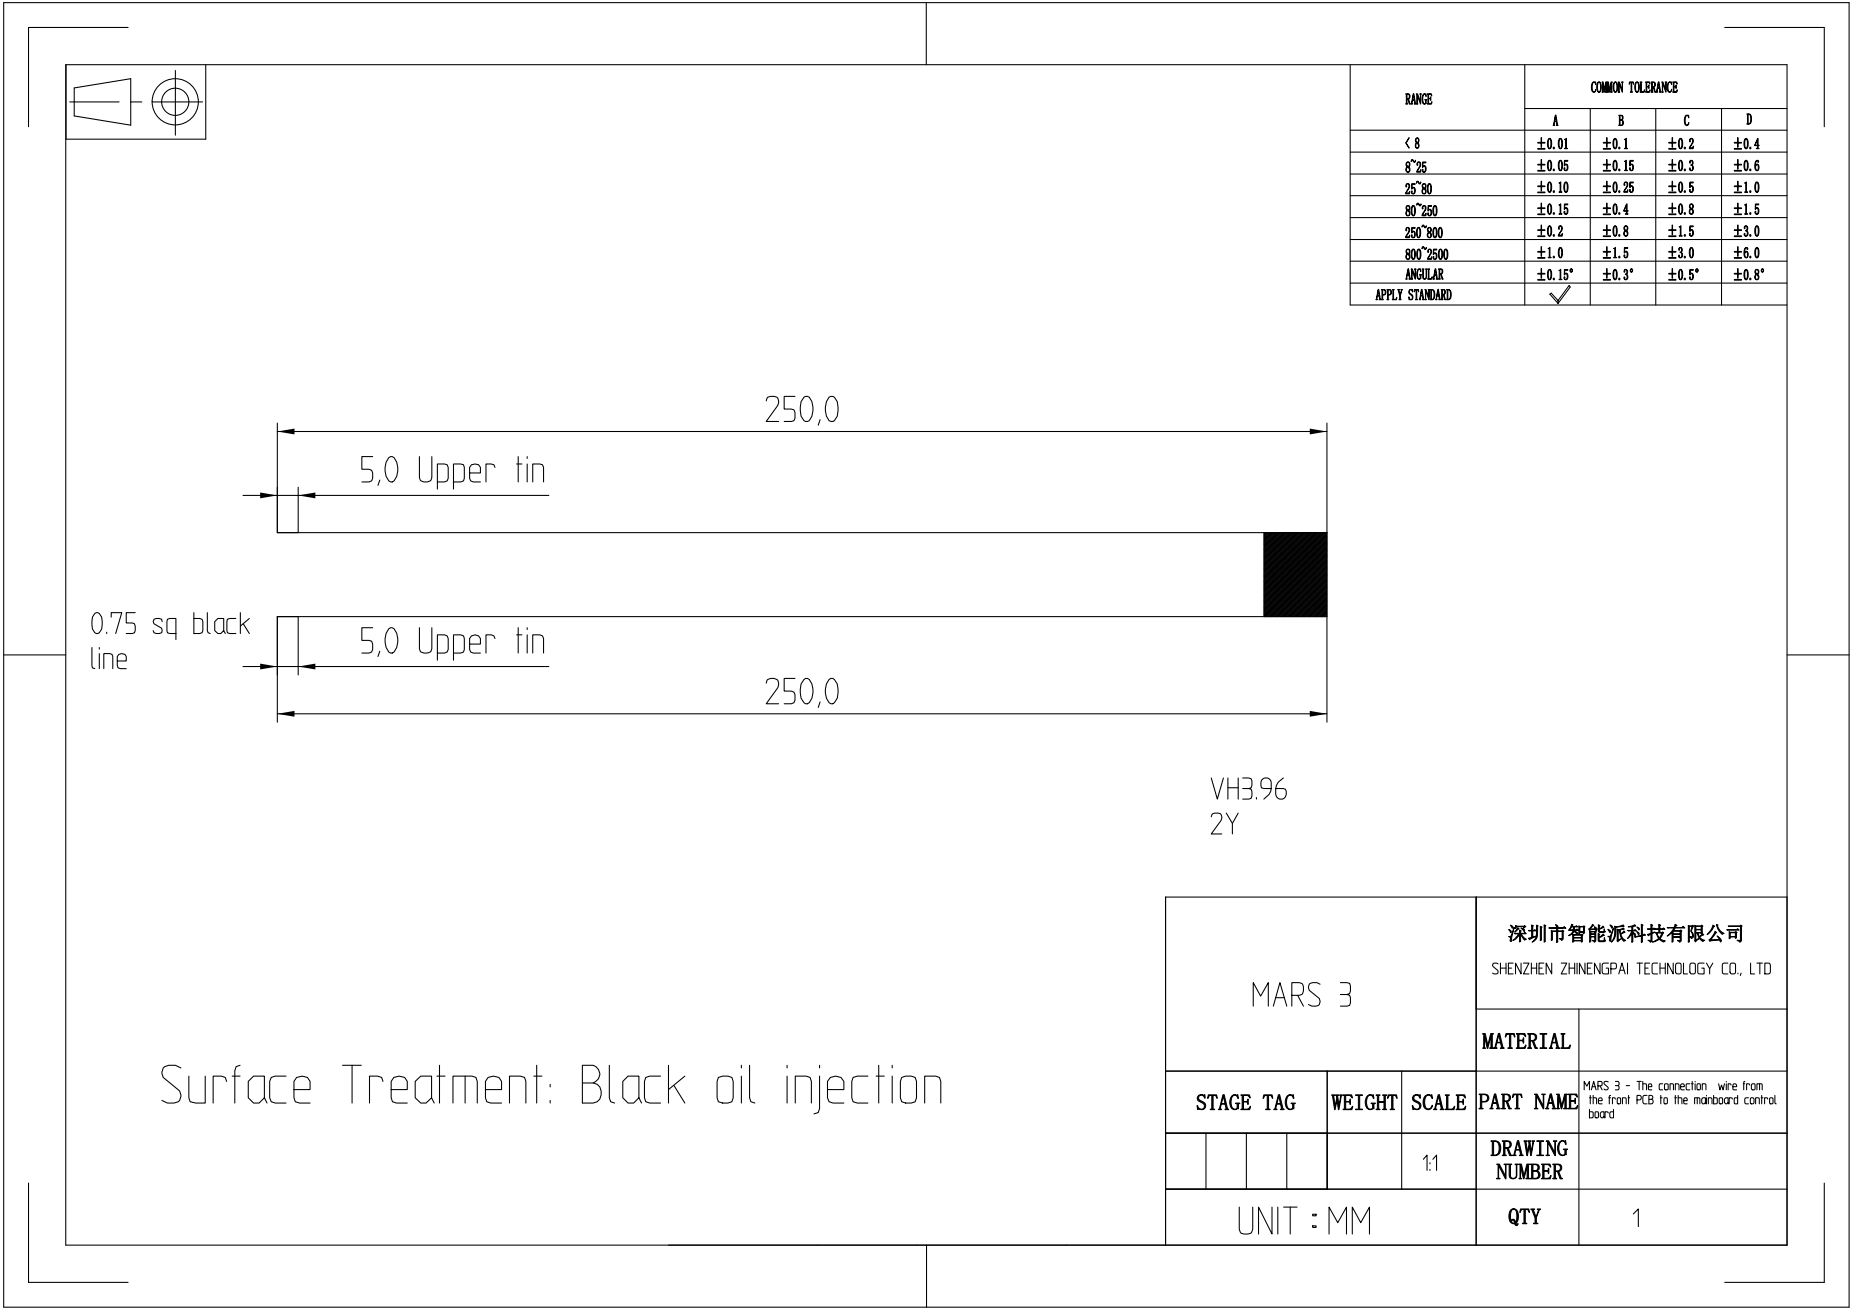
[picture p6: page 1]
