elegooofficial/Mars3/MARS 3  Wiring/MARS 3 -The connection wire from DC to front control board.pdf

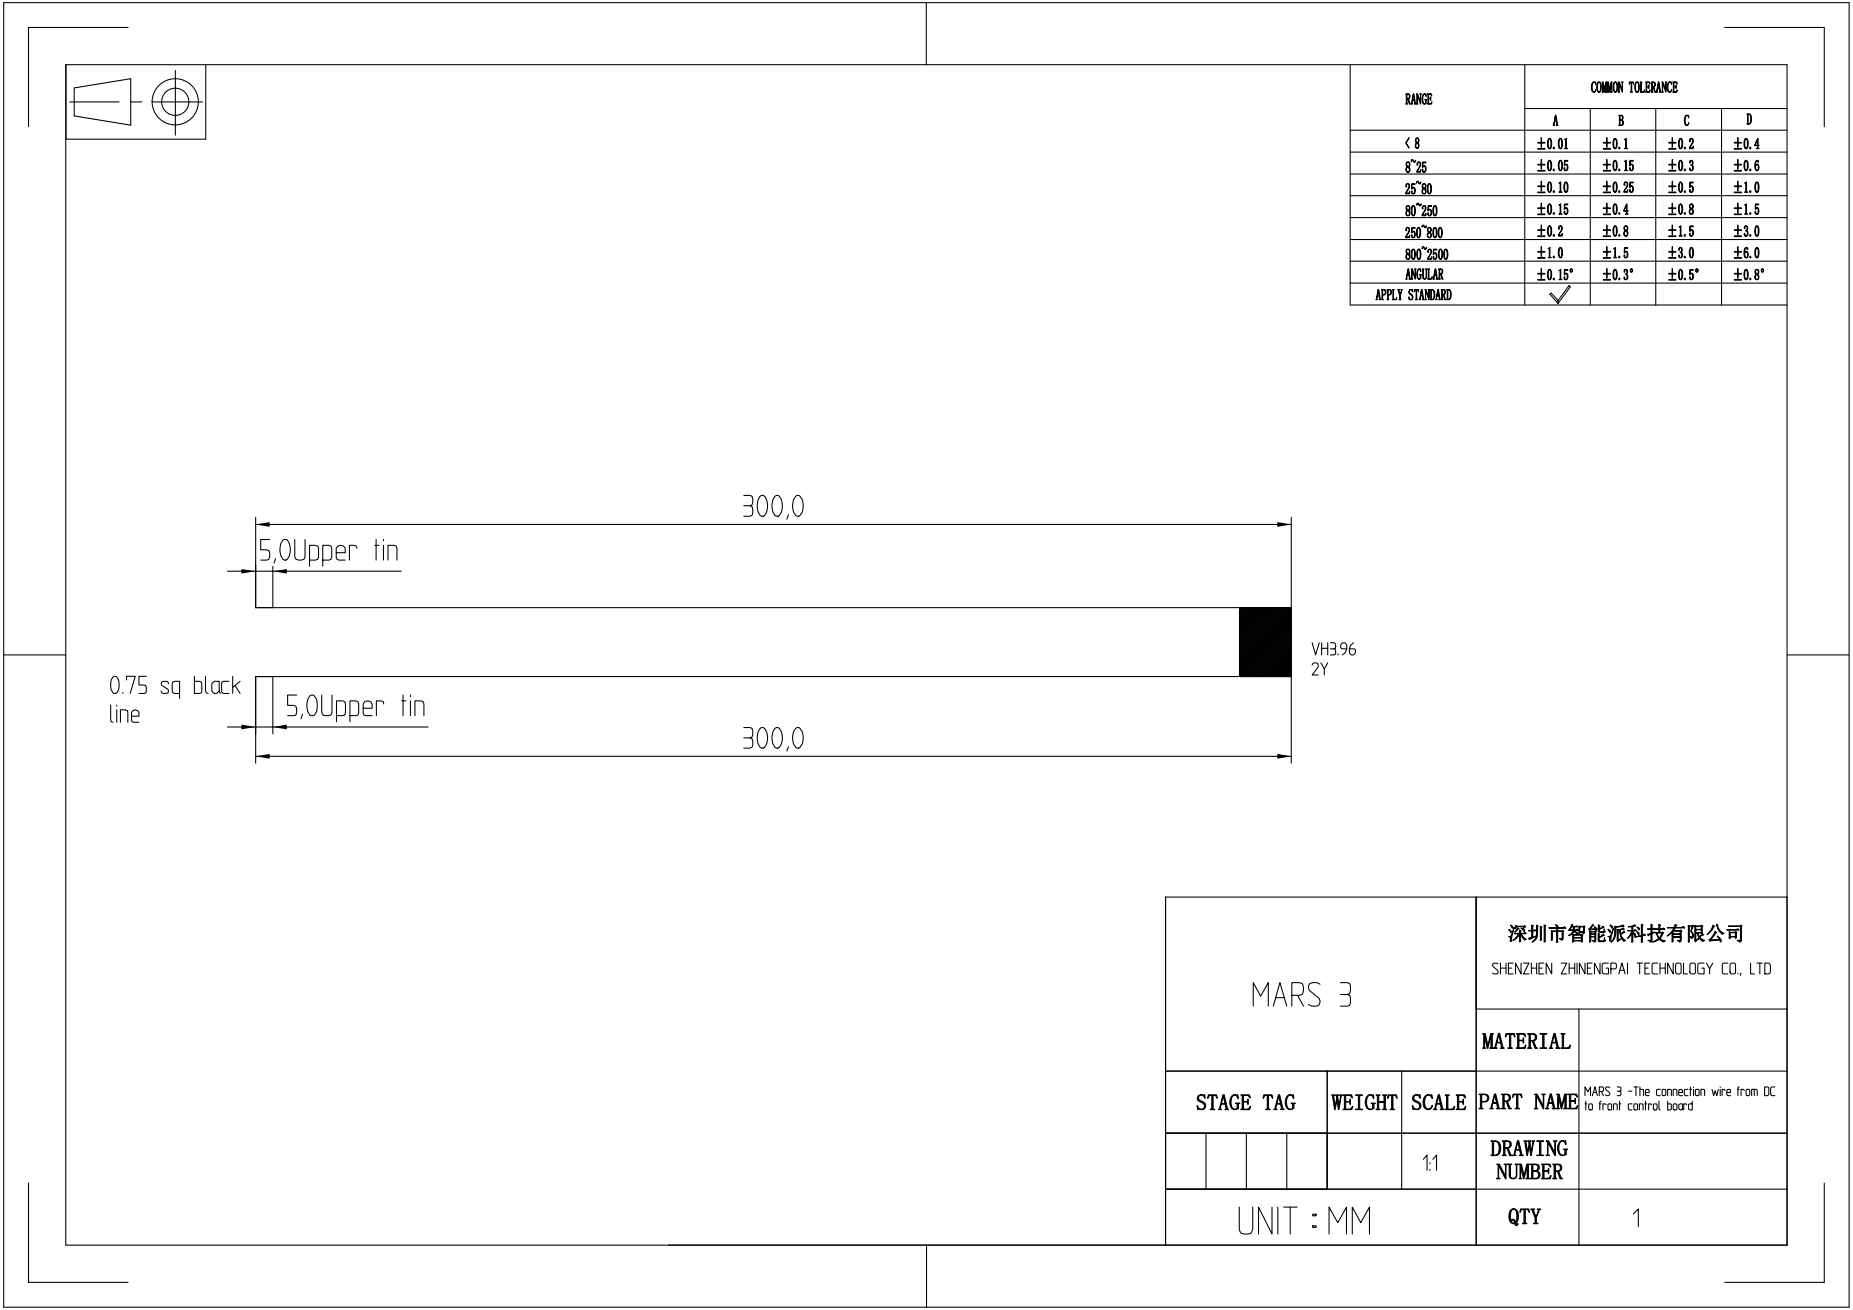
[picture p7: page 1]
