elegooofficial/Mars3/MARS 3  Wiring/MARS 3 series- Limit switch cable.pdf

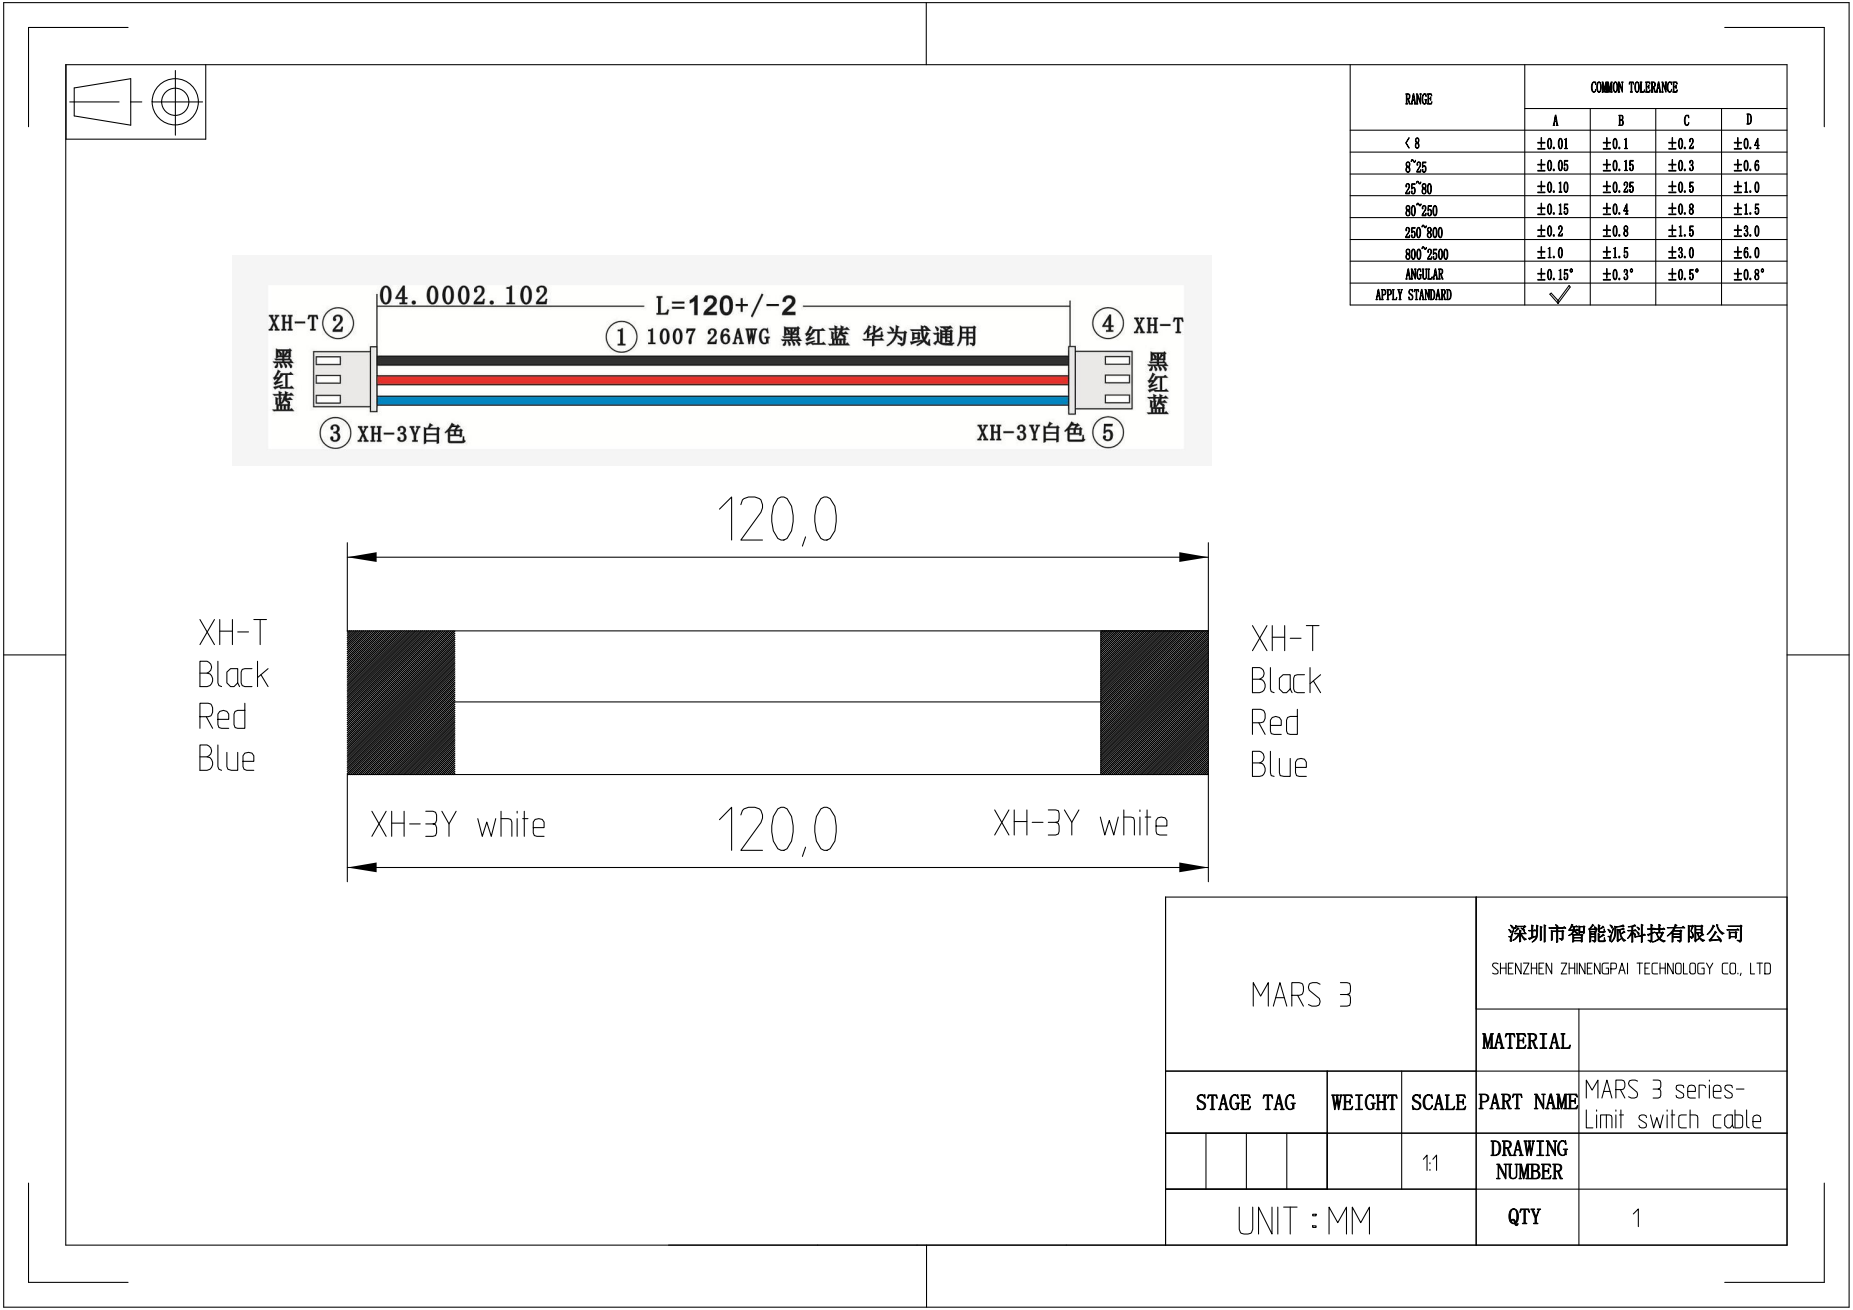
[picture p8: page 1]
