elegooofficial/Mars3/MARS 3  Mechanical/PDF/304 stainless steel stud-Model.pdf

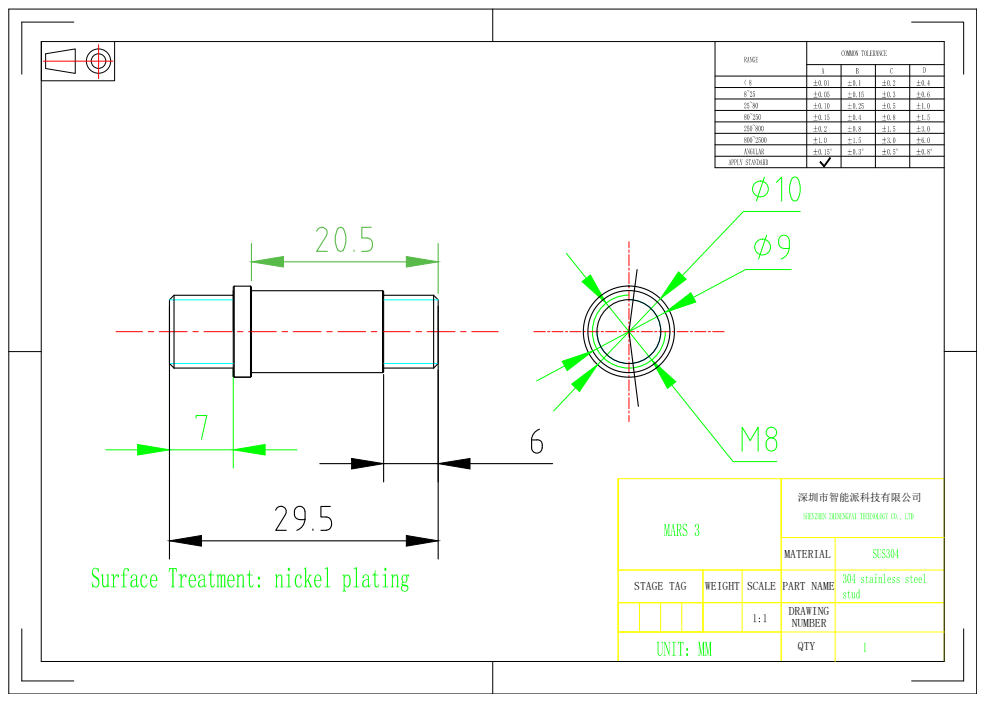
[picture p9: page 1]
