elegooofficial/Mars3/MARS 3  Mechanical/PDF/Damping pad-Model.pdf

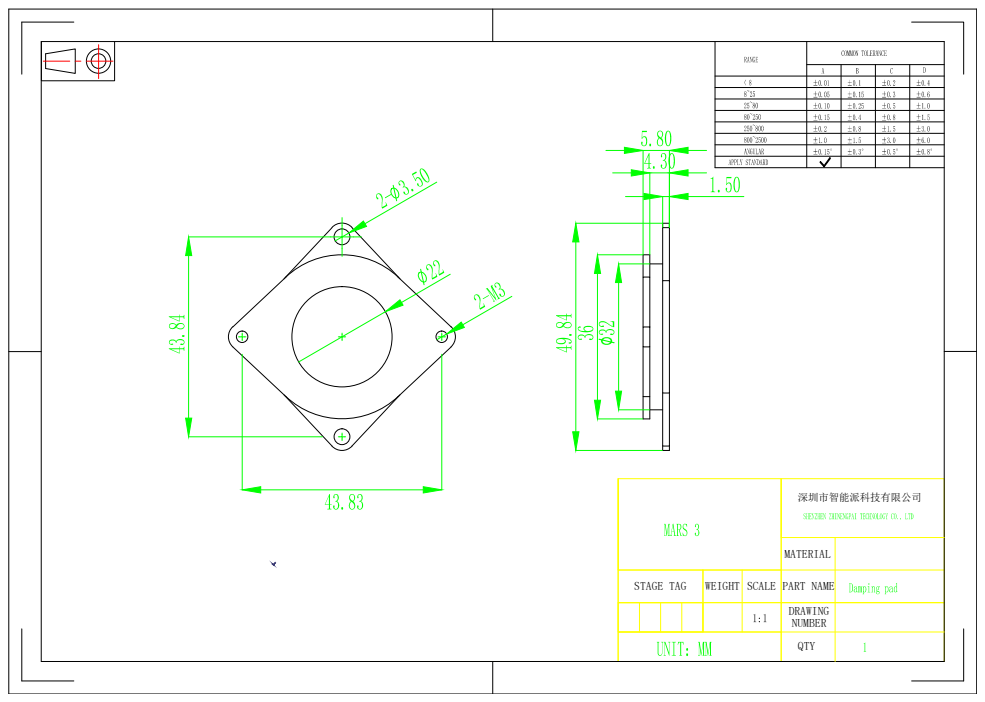
[picture p10: page 1]
