elegooofficial/Mars3/MARS 3  Mechanical/PDF/LCD1260-A1 card-Model.pdf

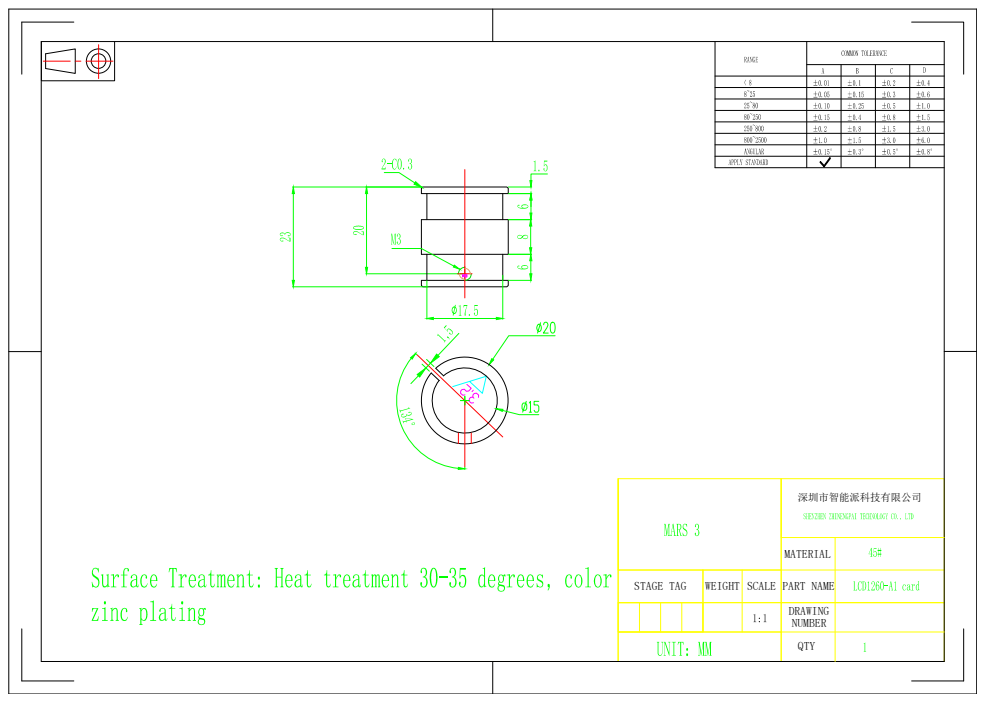
[picture p11: page 1]
