elegooofficial/Mars3/MARS 3  Mechanical/PDF/MARS - Five-star handle-Model.pdf

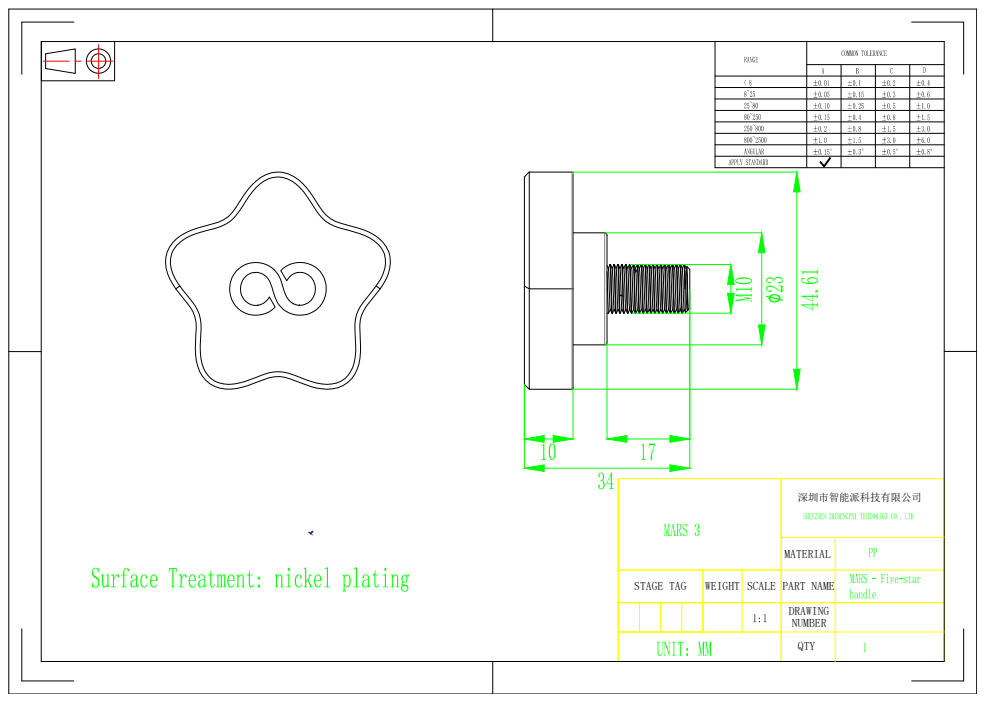
[picture p12: page 1]
