elegooofficial/Mars3/MARS 3  Mechanical/PDF/MARS 2 series - Lower shell of photoelectric limit switch-Model.pdf

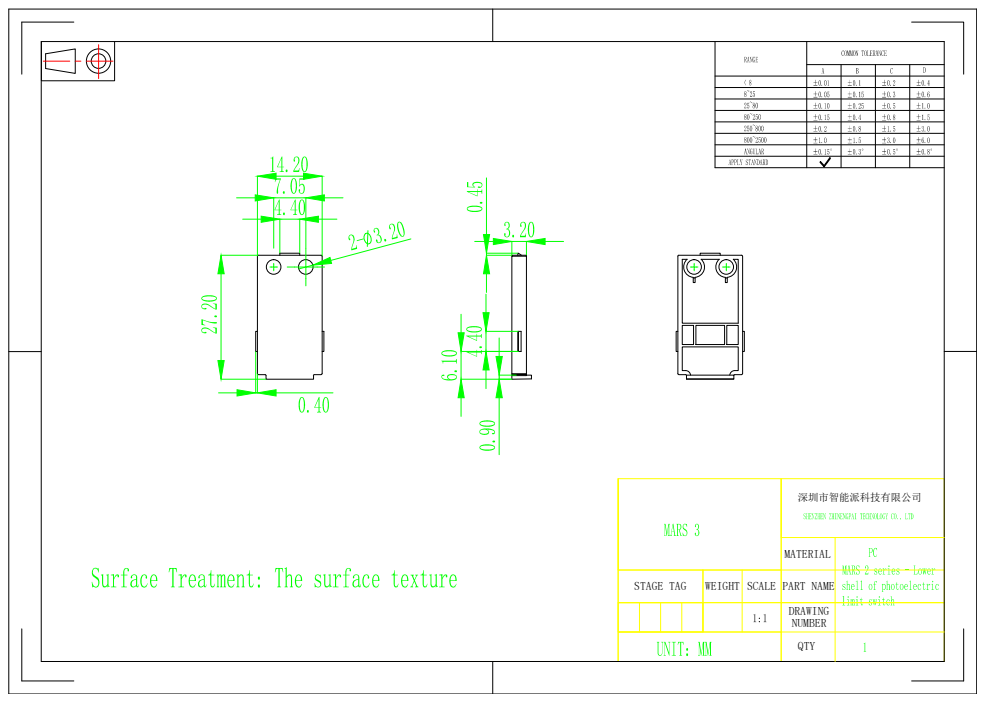
[picture p13: page 1]
