elegooofficial/Mars3/MARS 3  Mechanical/PDF/MARS 2 series - Upper shell of photoelectric limit switch-Model.pdf

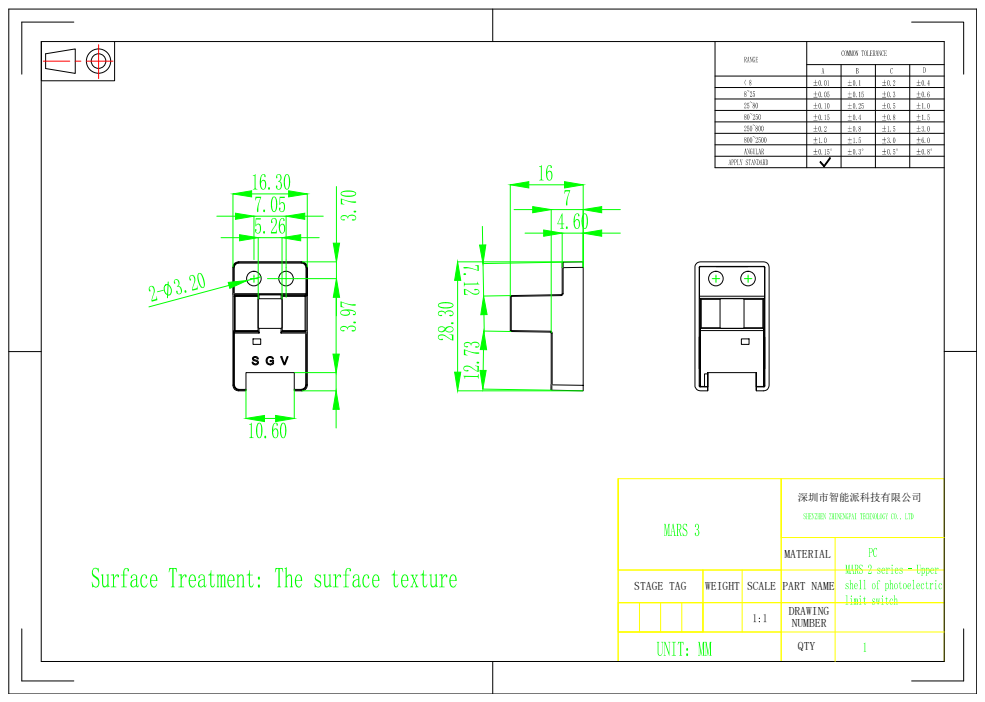
[picture p14: page 1]
