elegooofficial/Mars3/MARS 3  Mechanical/PDF/MARS 3 - 3.5 inch screen bracket.pdf

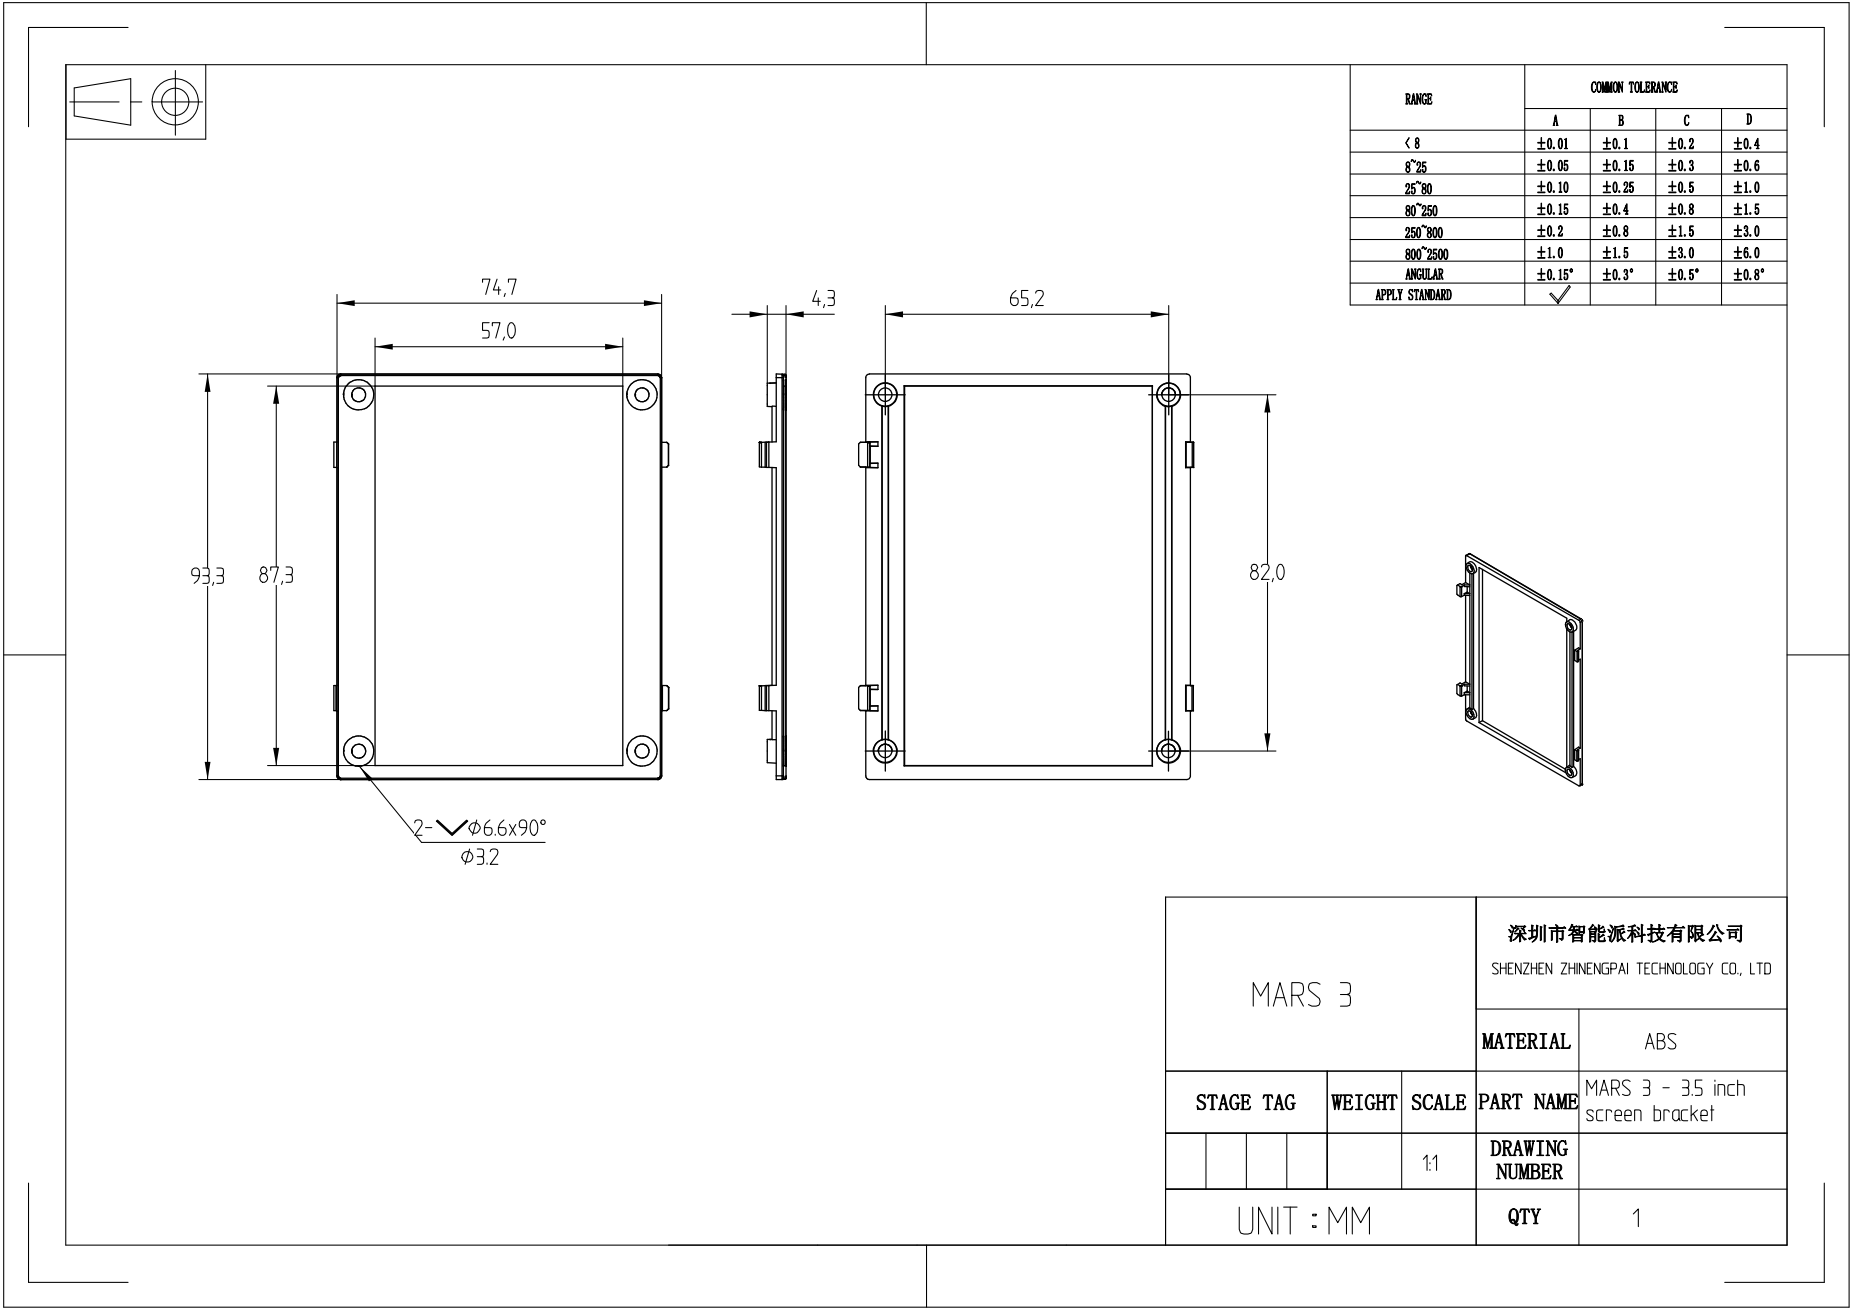
[picture p15: page 1]
