elegooofficial/Mars3/MARS 3  Mechanical/PDF/MARS 3 - Back cover.pdf

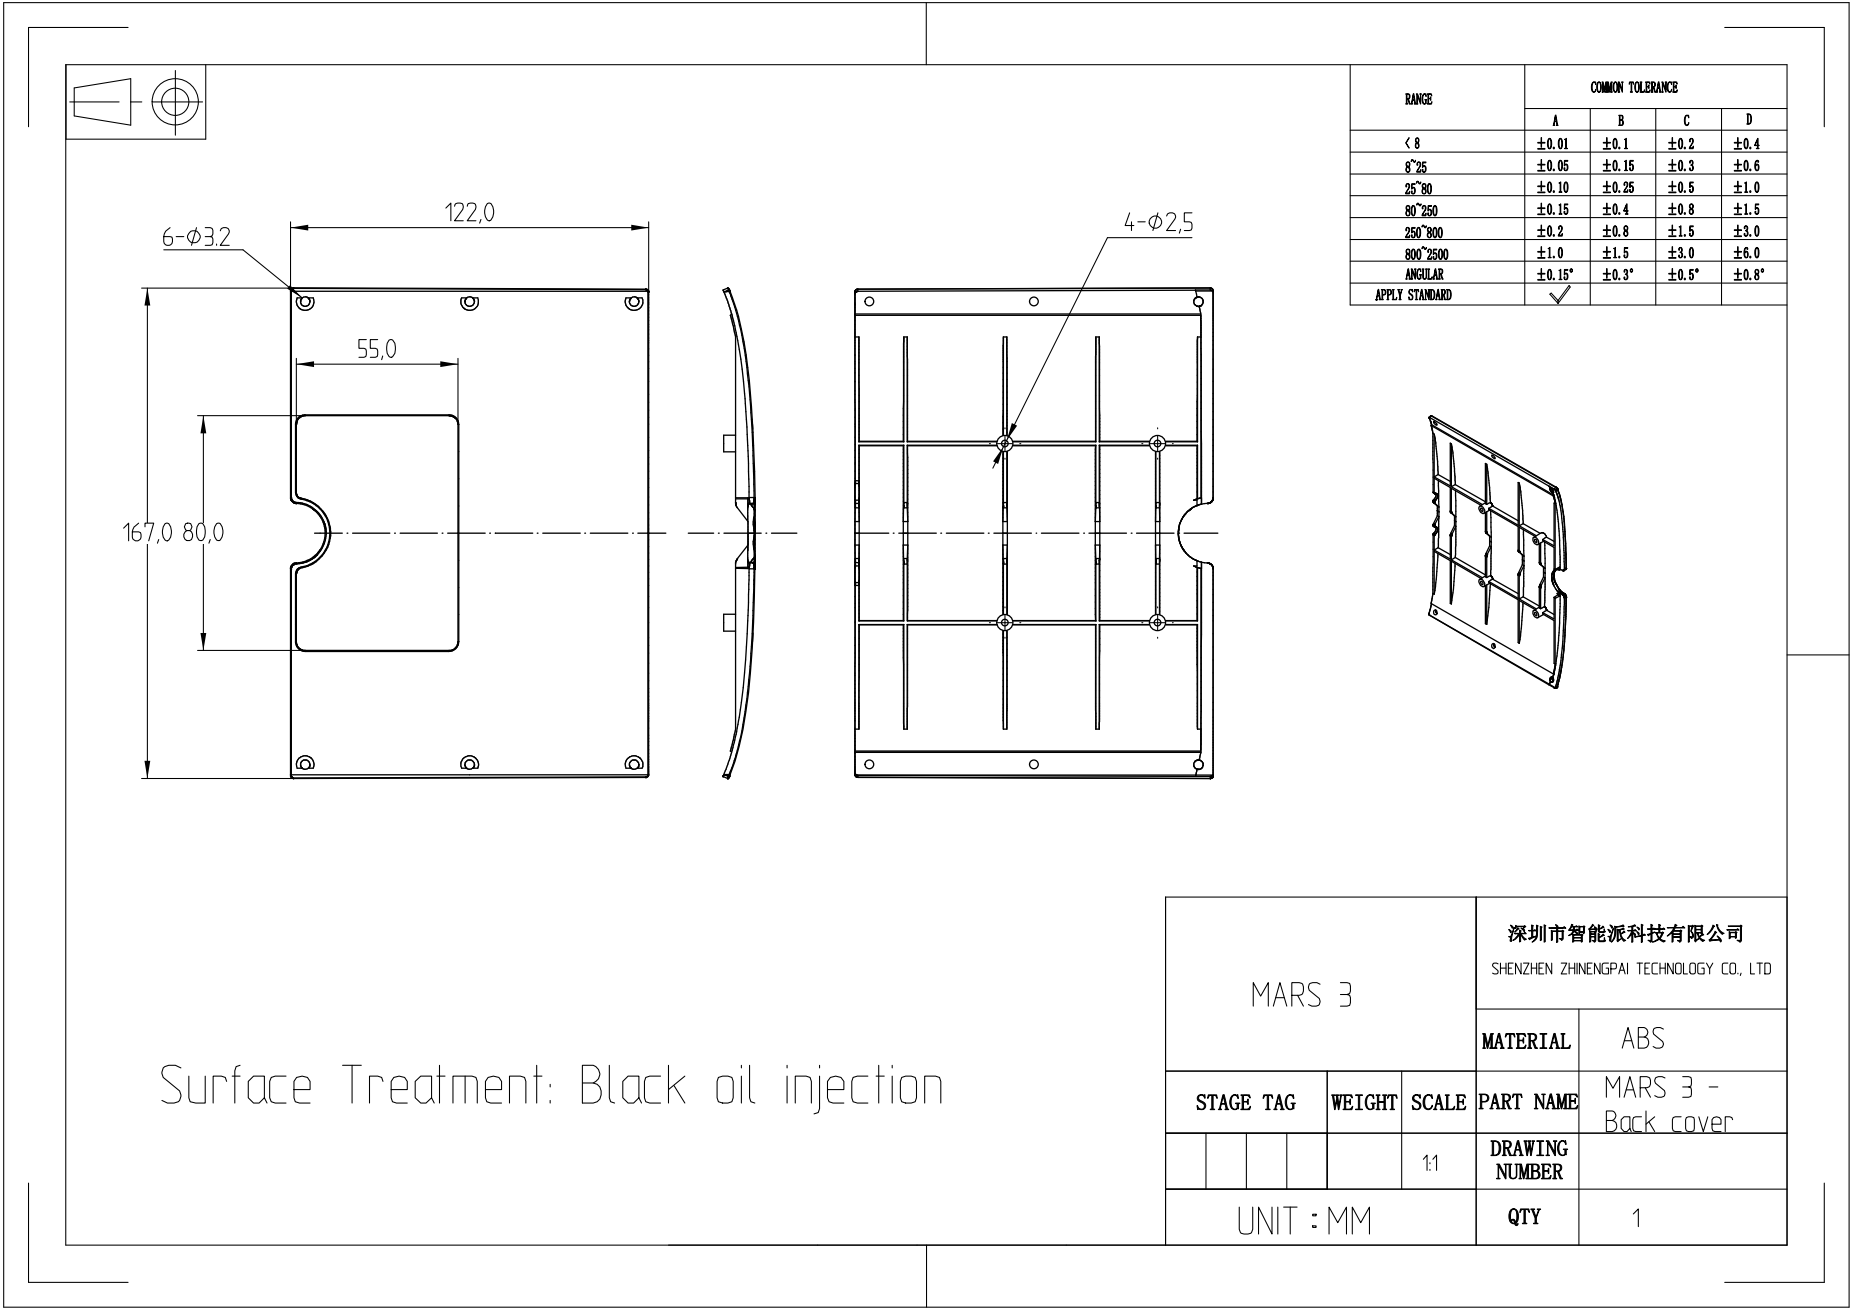
[picture p16: page 1]
