elegooofficial/Mars3/MARS 3  Mechanical/PDF/MARS 3 - Base.pdf

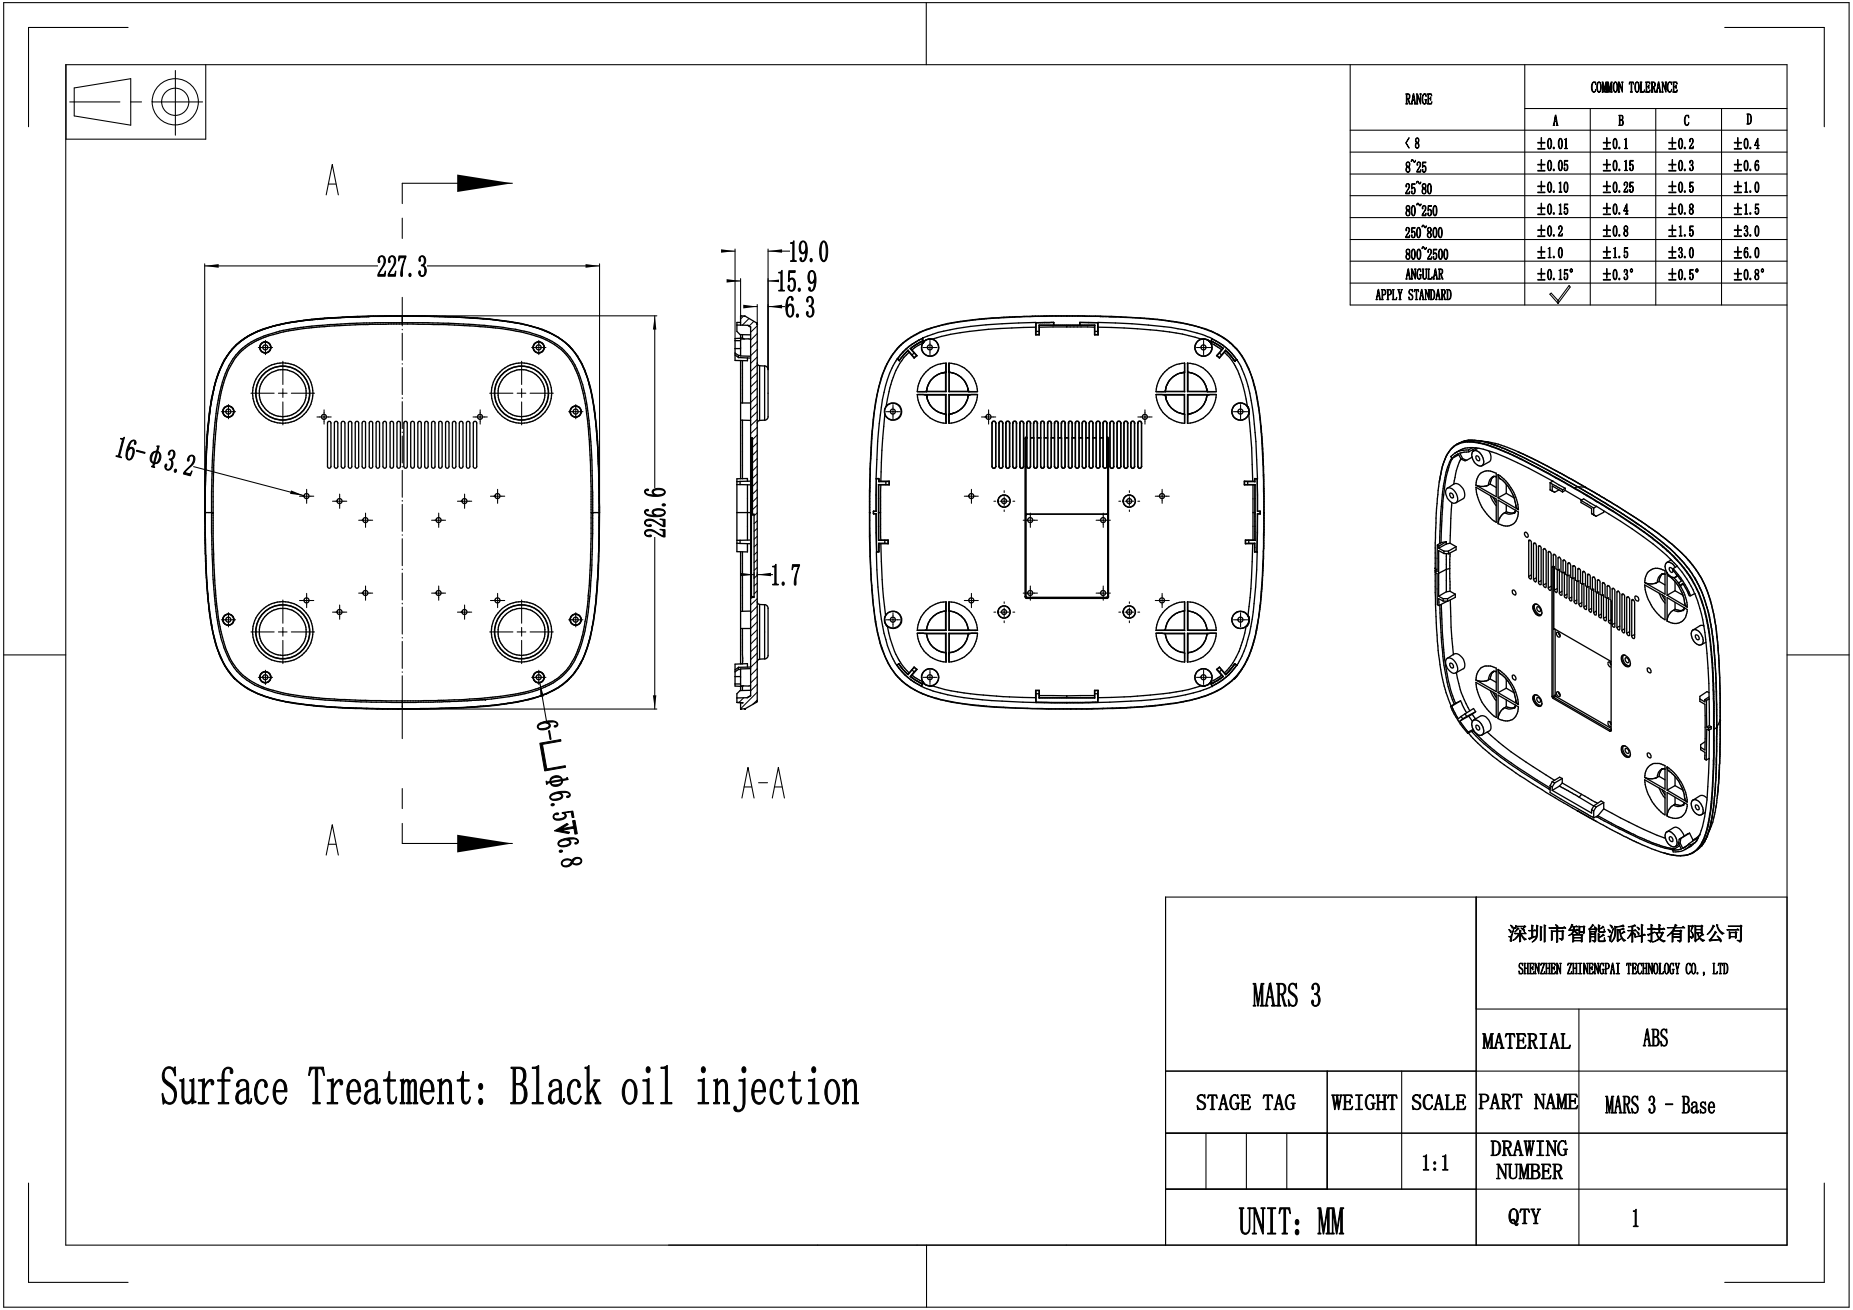
[picture p17: page 1]
