elegooofficial/Mars3/MARS 3  Mechanical/PDF/MARS 3 - Build platform board.pdf

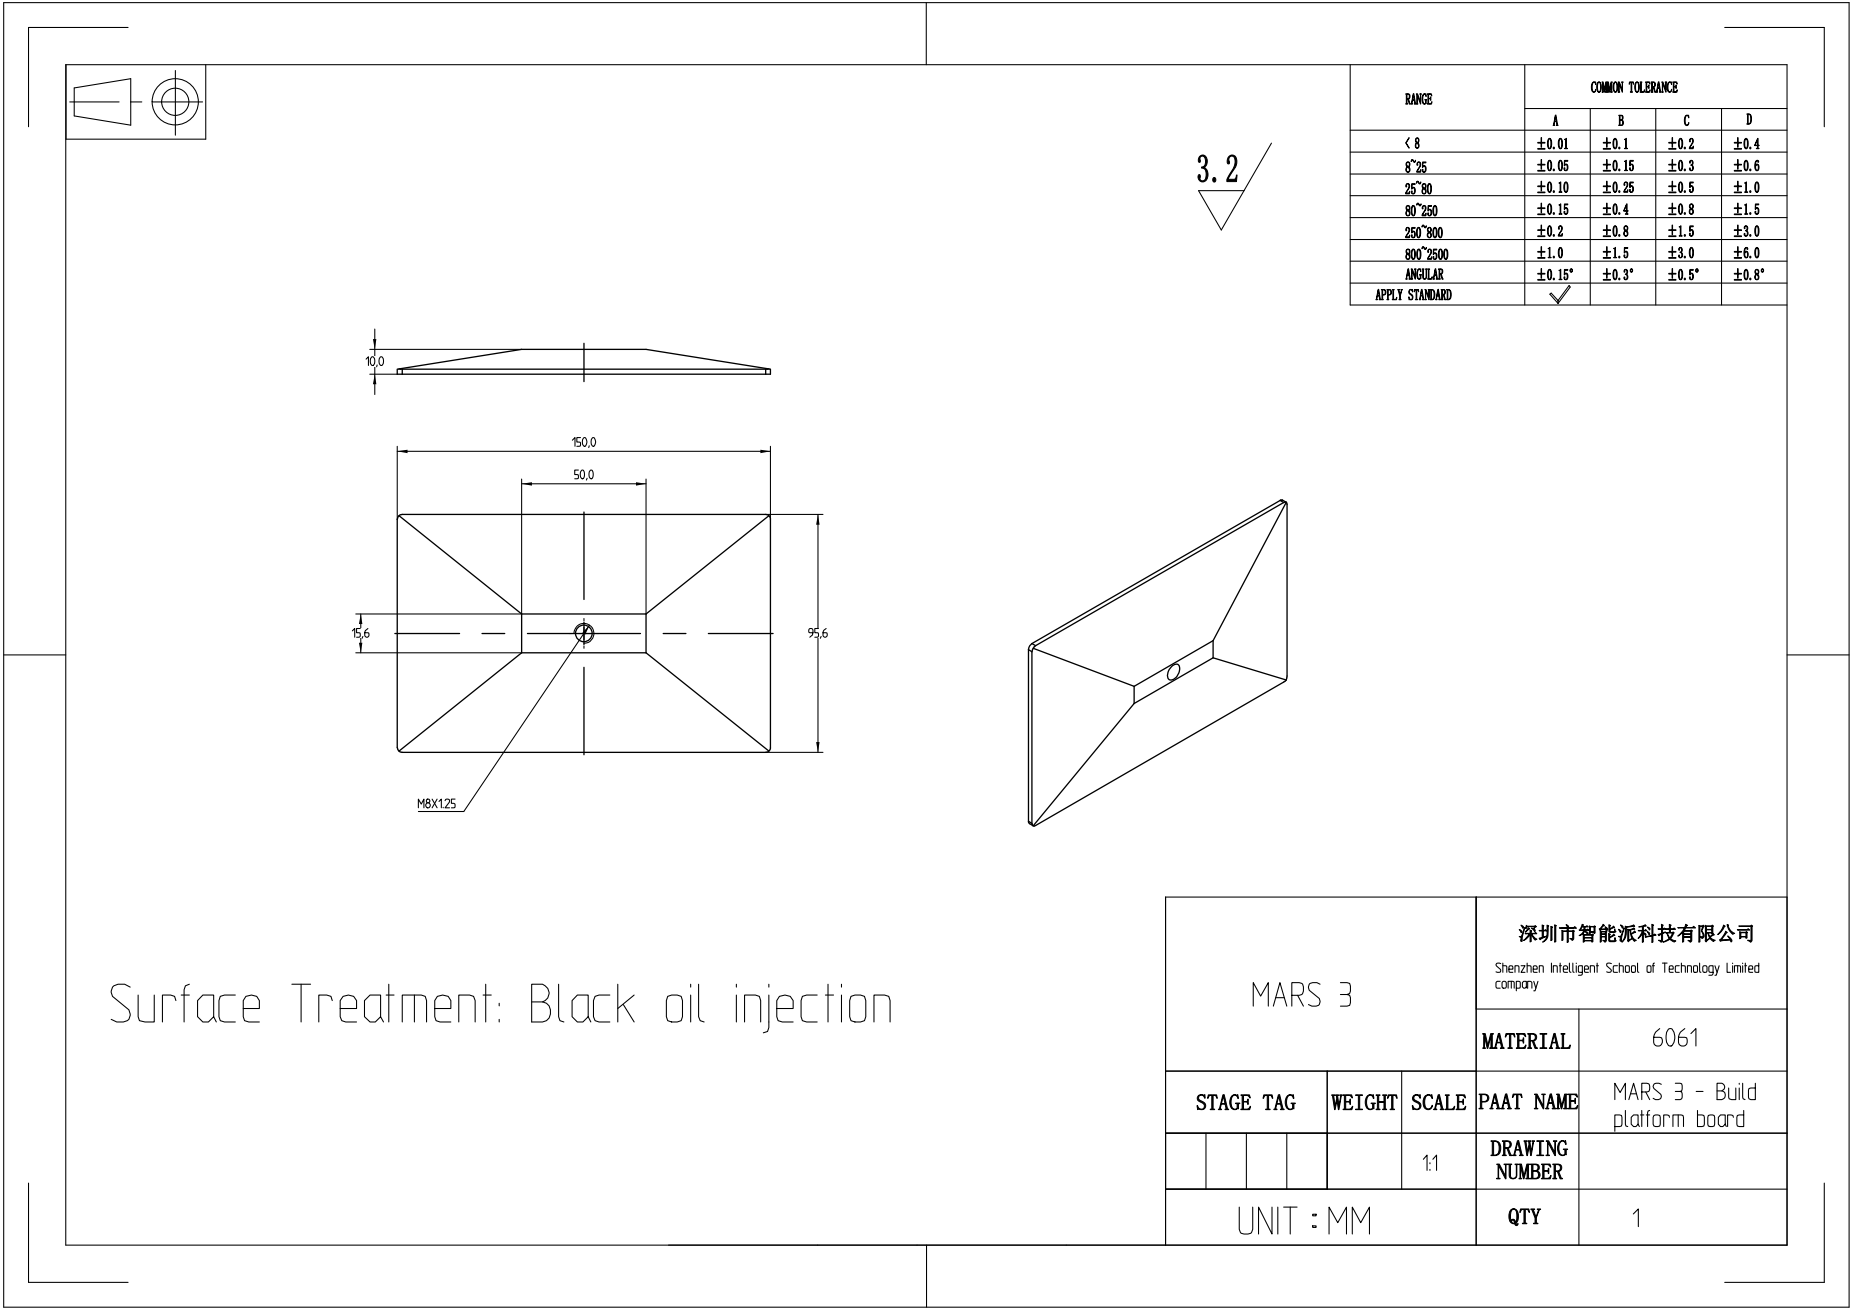
[picture p18: page 1]
