elegooofficial/Mars3/MARS 3  Mechanical/PDF/MARS 3 - C2 mainboard bracket.pdf

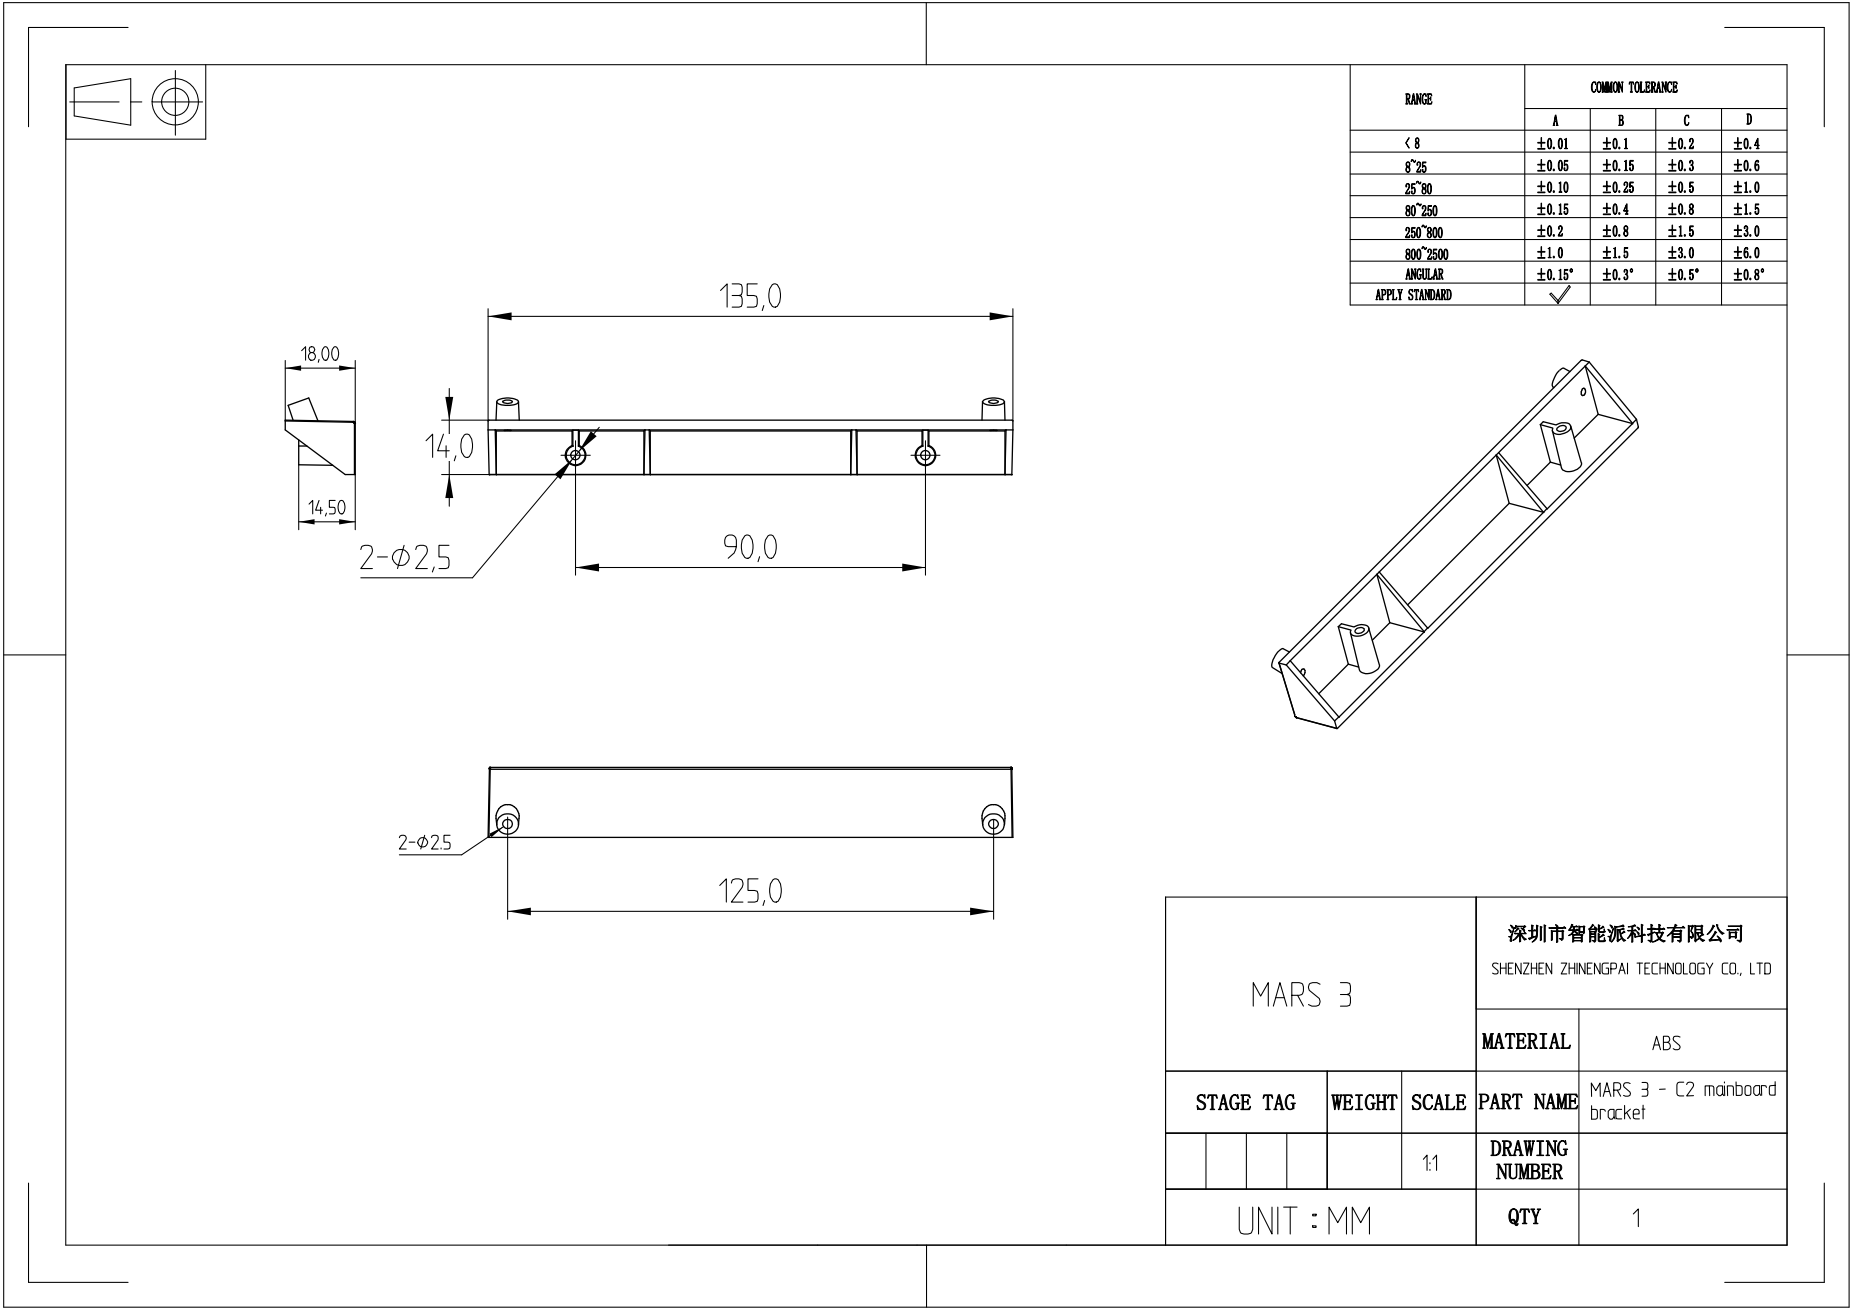
[picture p19: page 1]
