elegooofficial/Mars3/MARS 3  Mechanical/PDF/MARS 3 - Cover.pdf

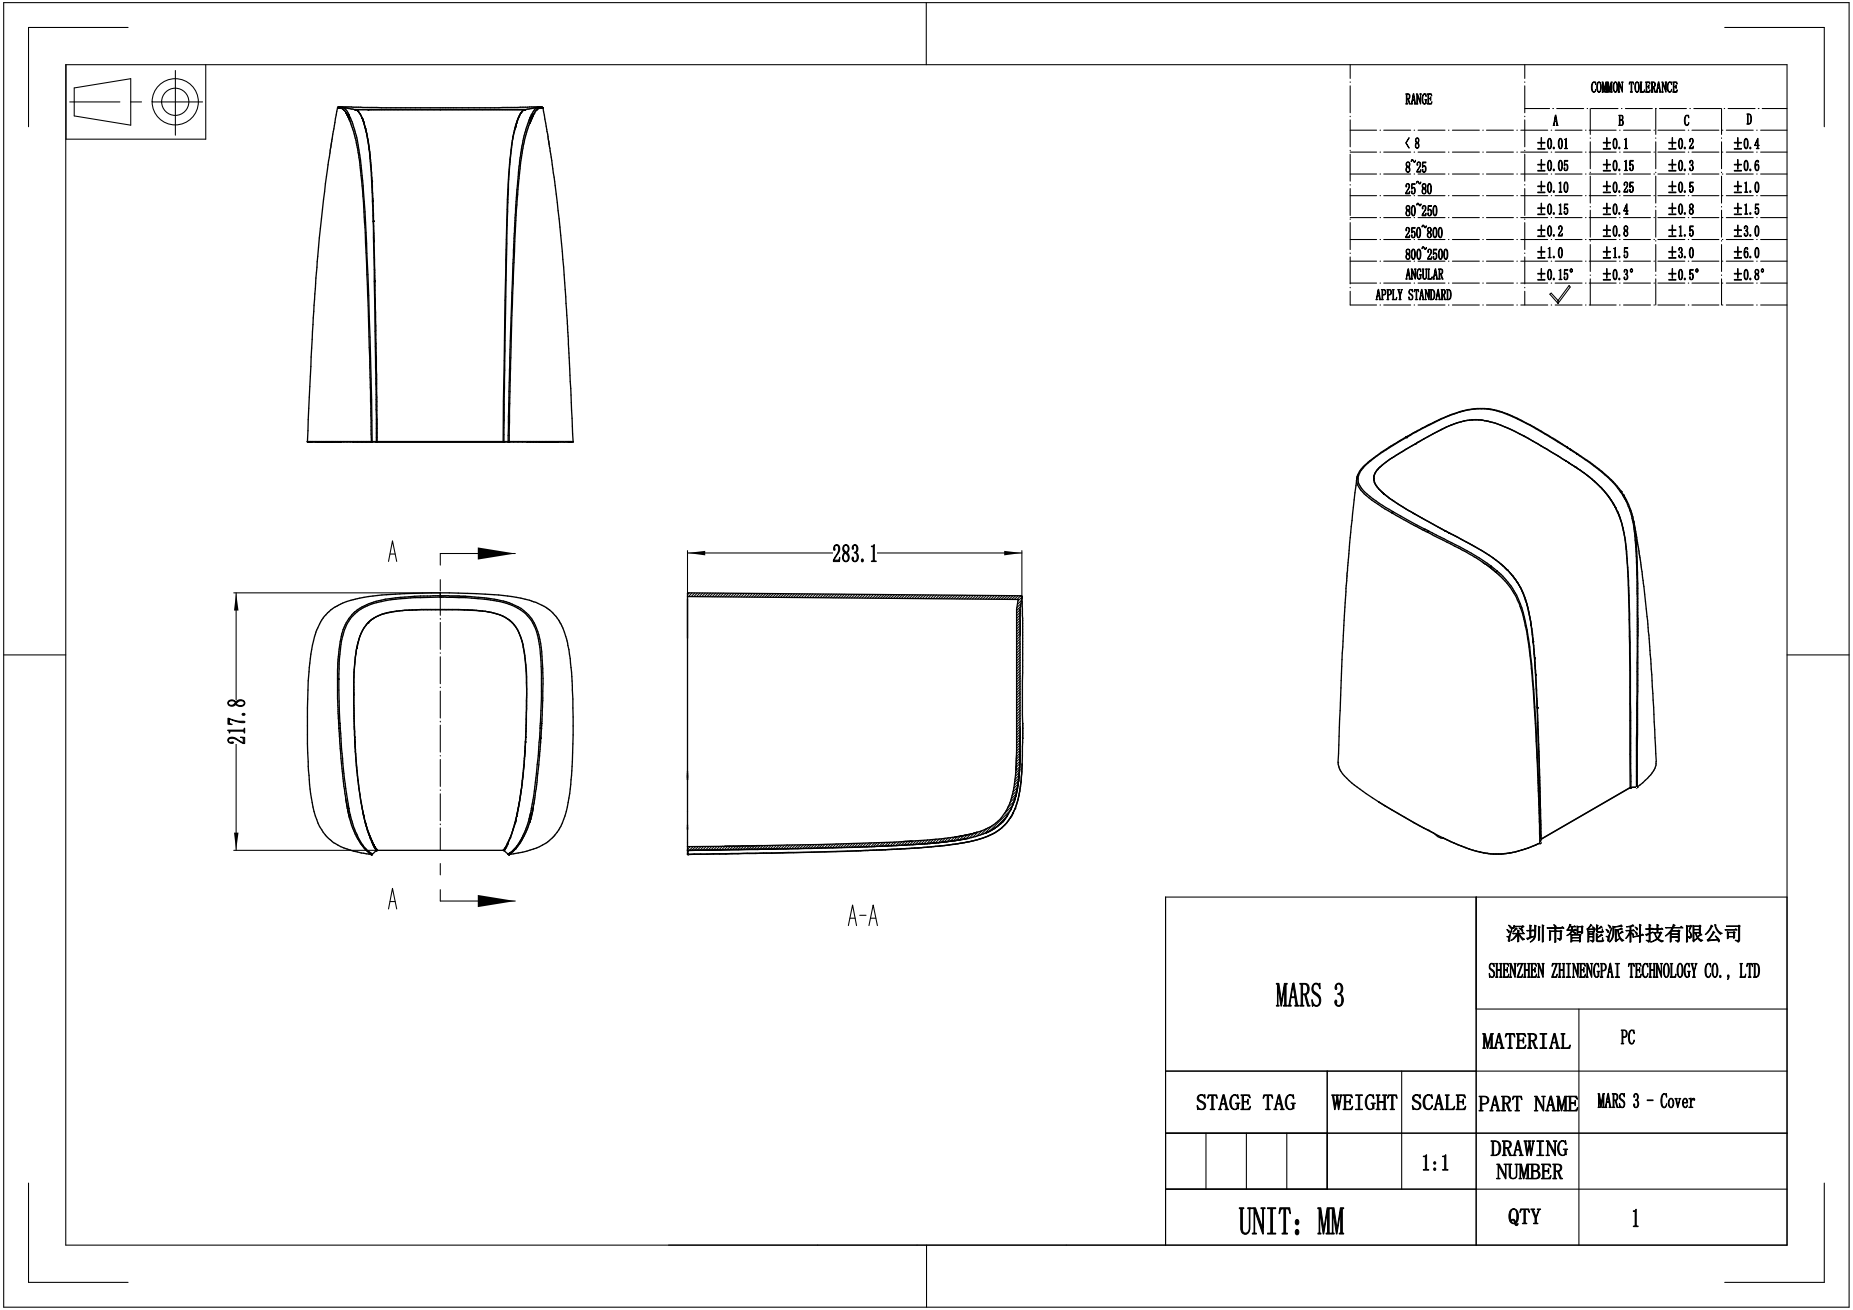
[picture p20: page 1]
