elegooofficial/Mars3/MARS 3  Mechanical/PDF/MARS 3 - Glass.pdf

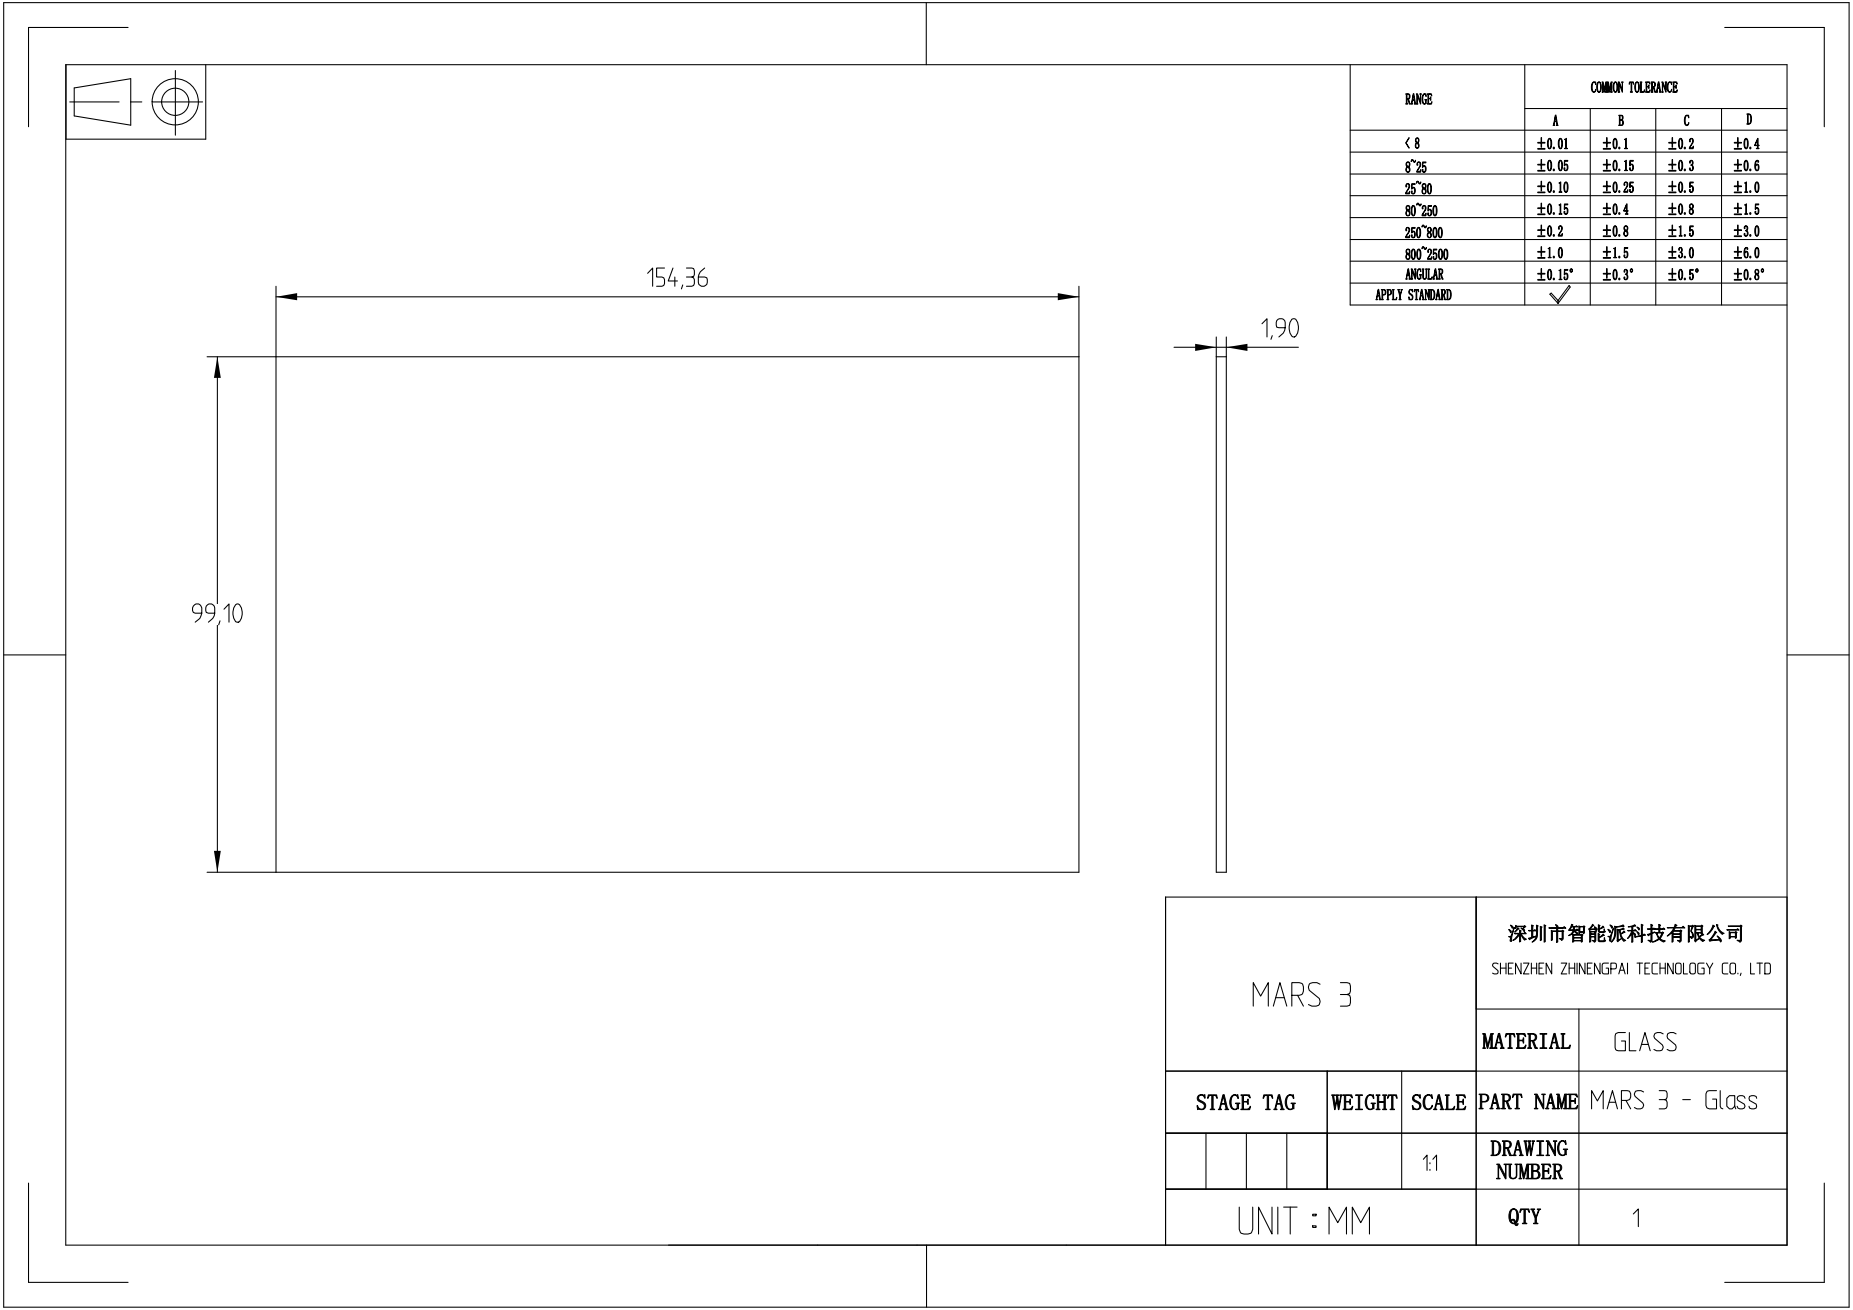
[picture p21: page 1]
