elegooofficial/Mars3/MARS 3  Mechanical/PDF/MARS 3 - Heat sink.pdf

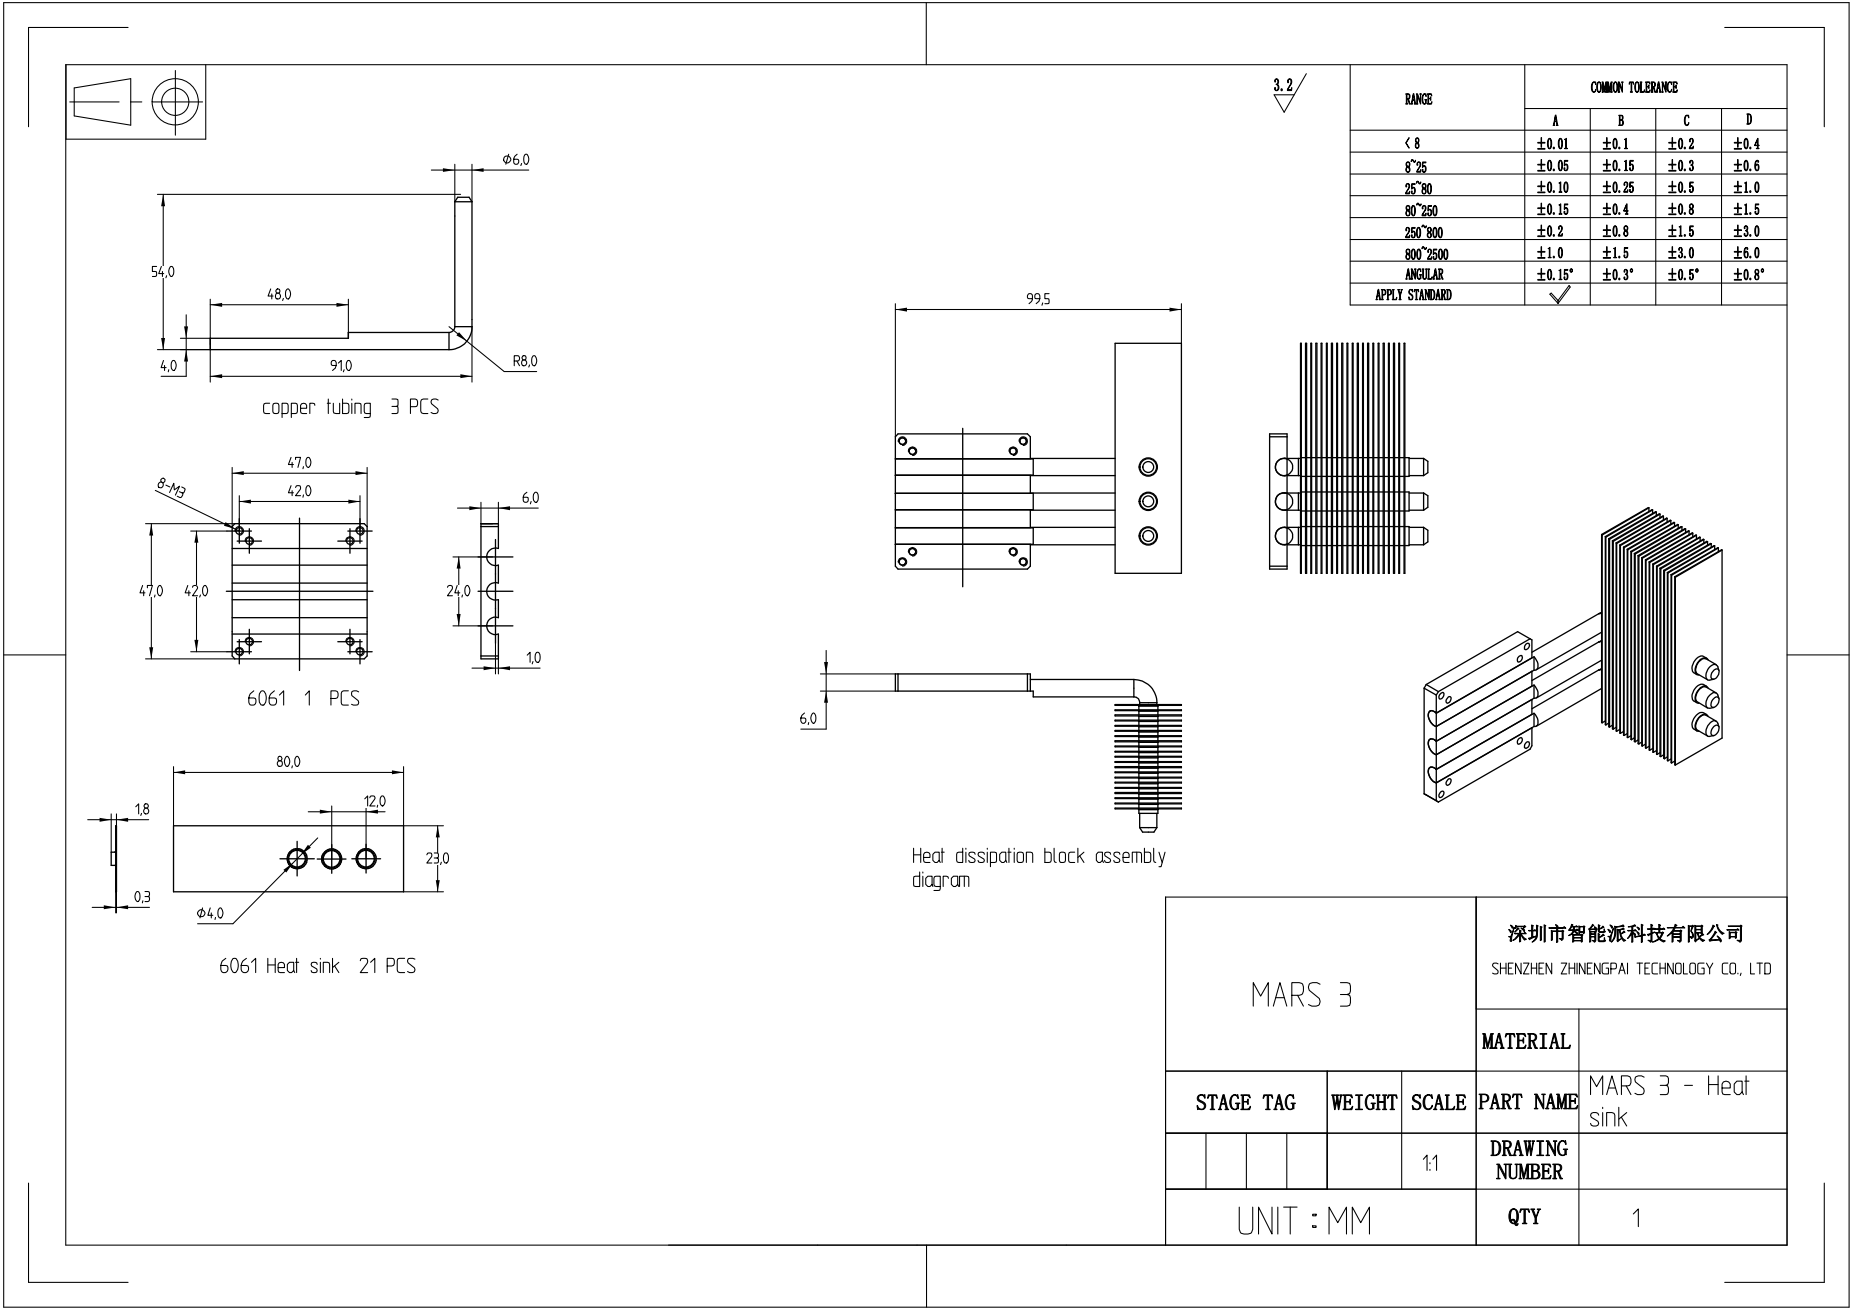
[picture p22: page 1]
