elegooofficial/Mars3/MARS 3  Mechanical/PDF/MARS 3 - Lens holder.pdf

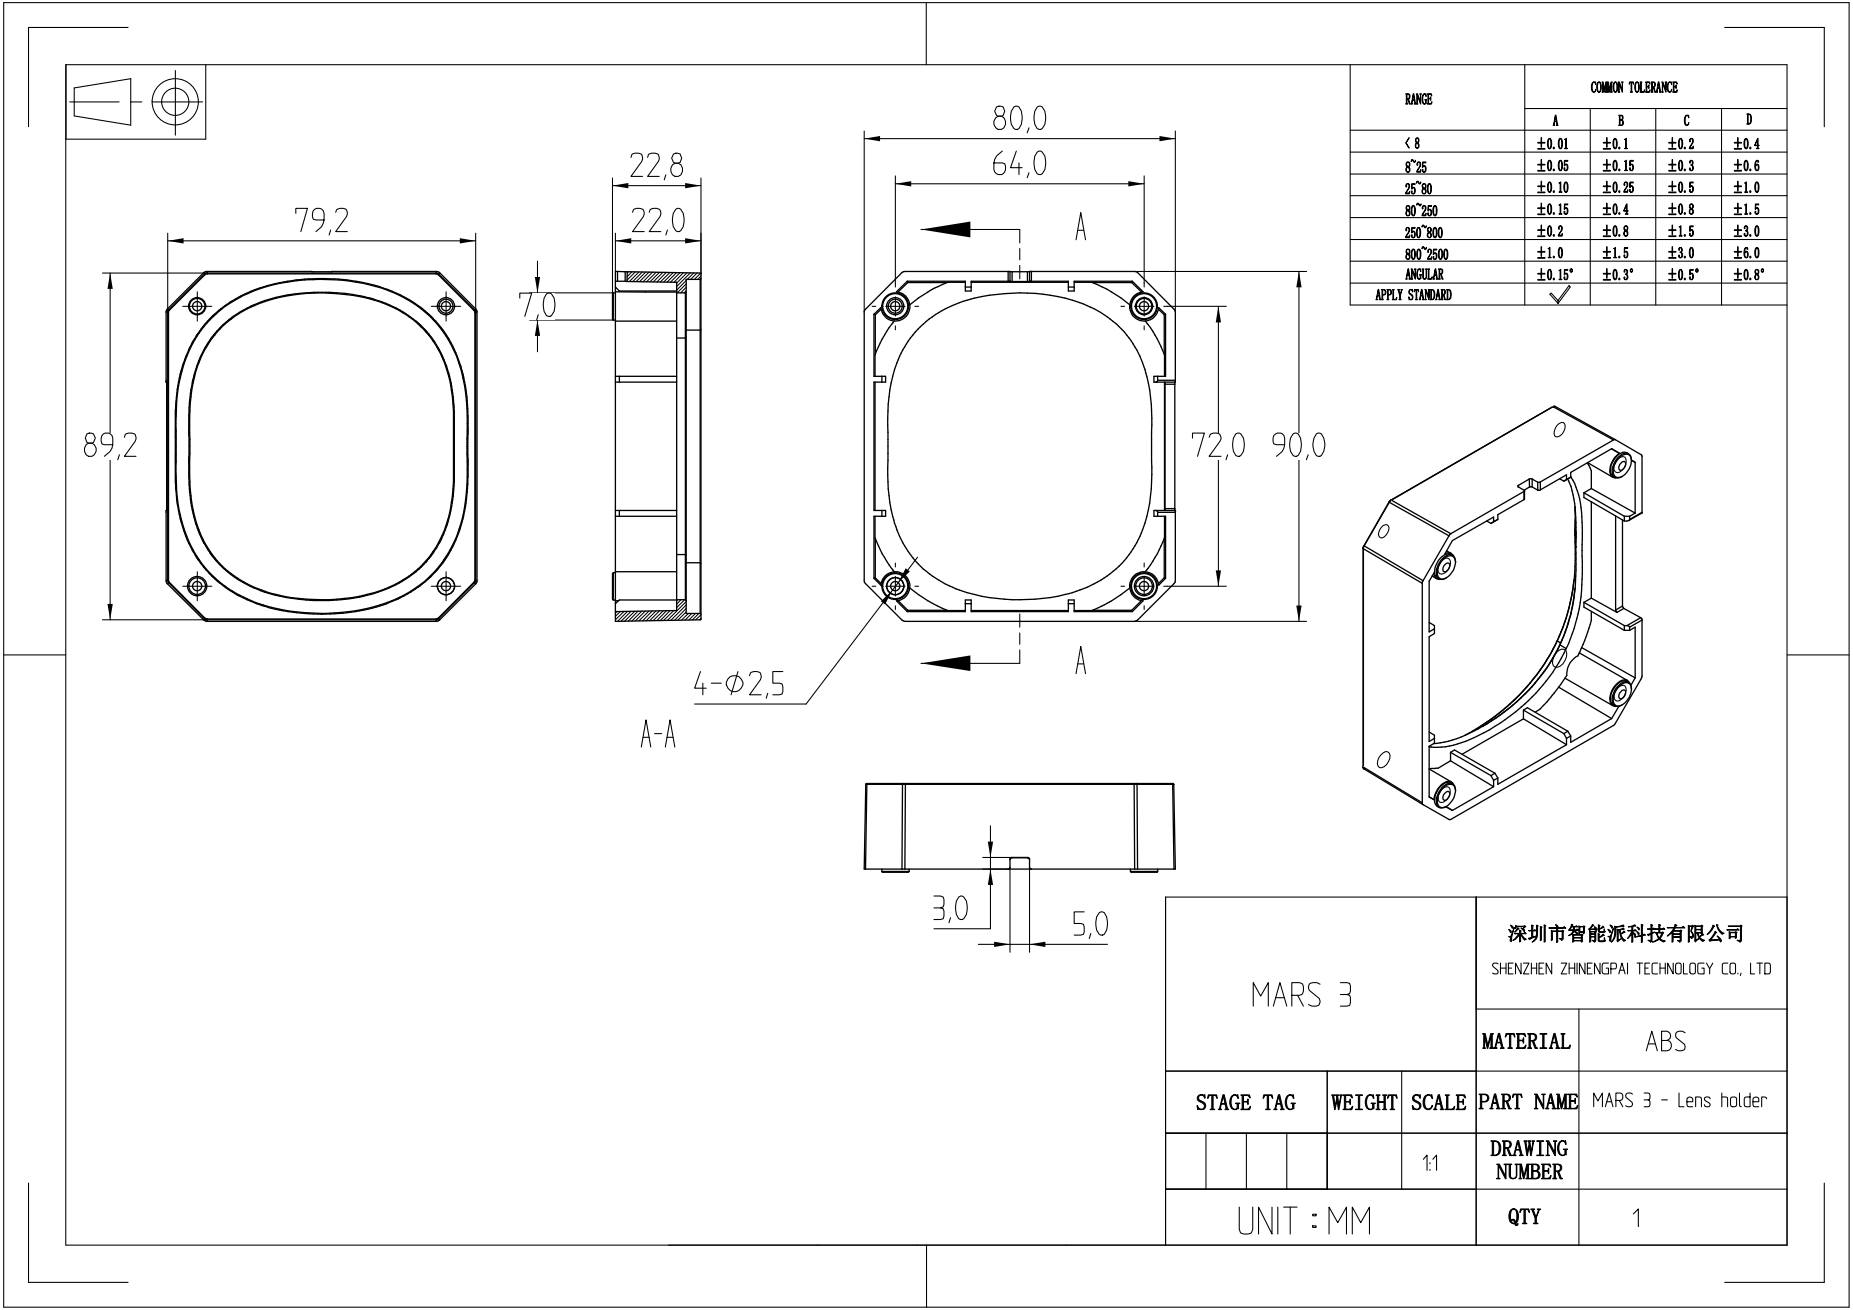
[picture p23: page 1]
