elegooofficial/Mars3/MARS 3  Mechanical/PDF/MARS 3 - Lens Hood.pdf

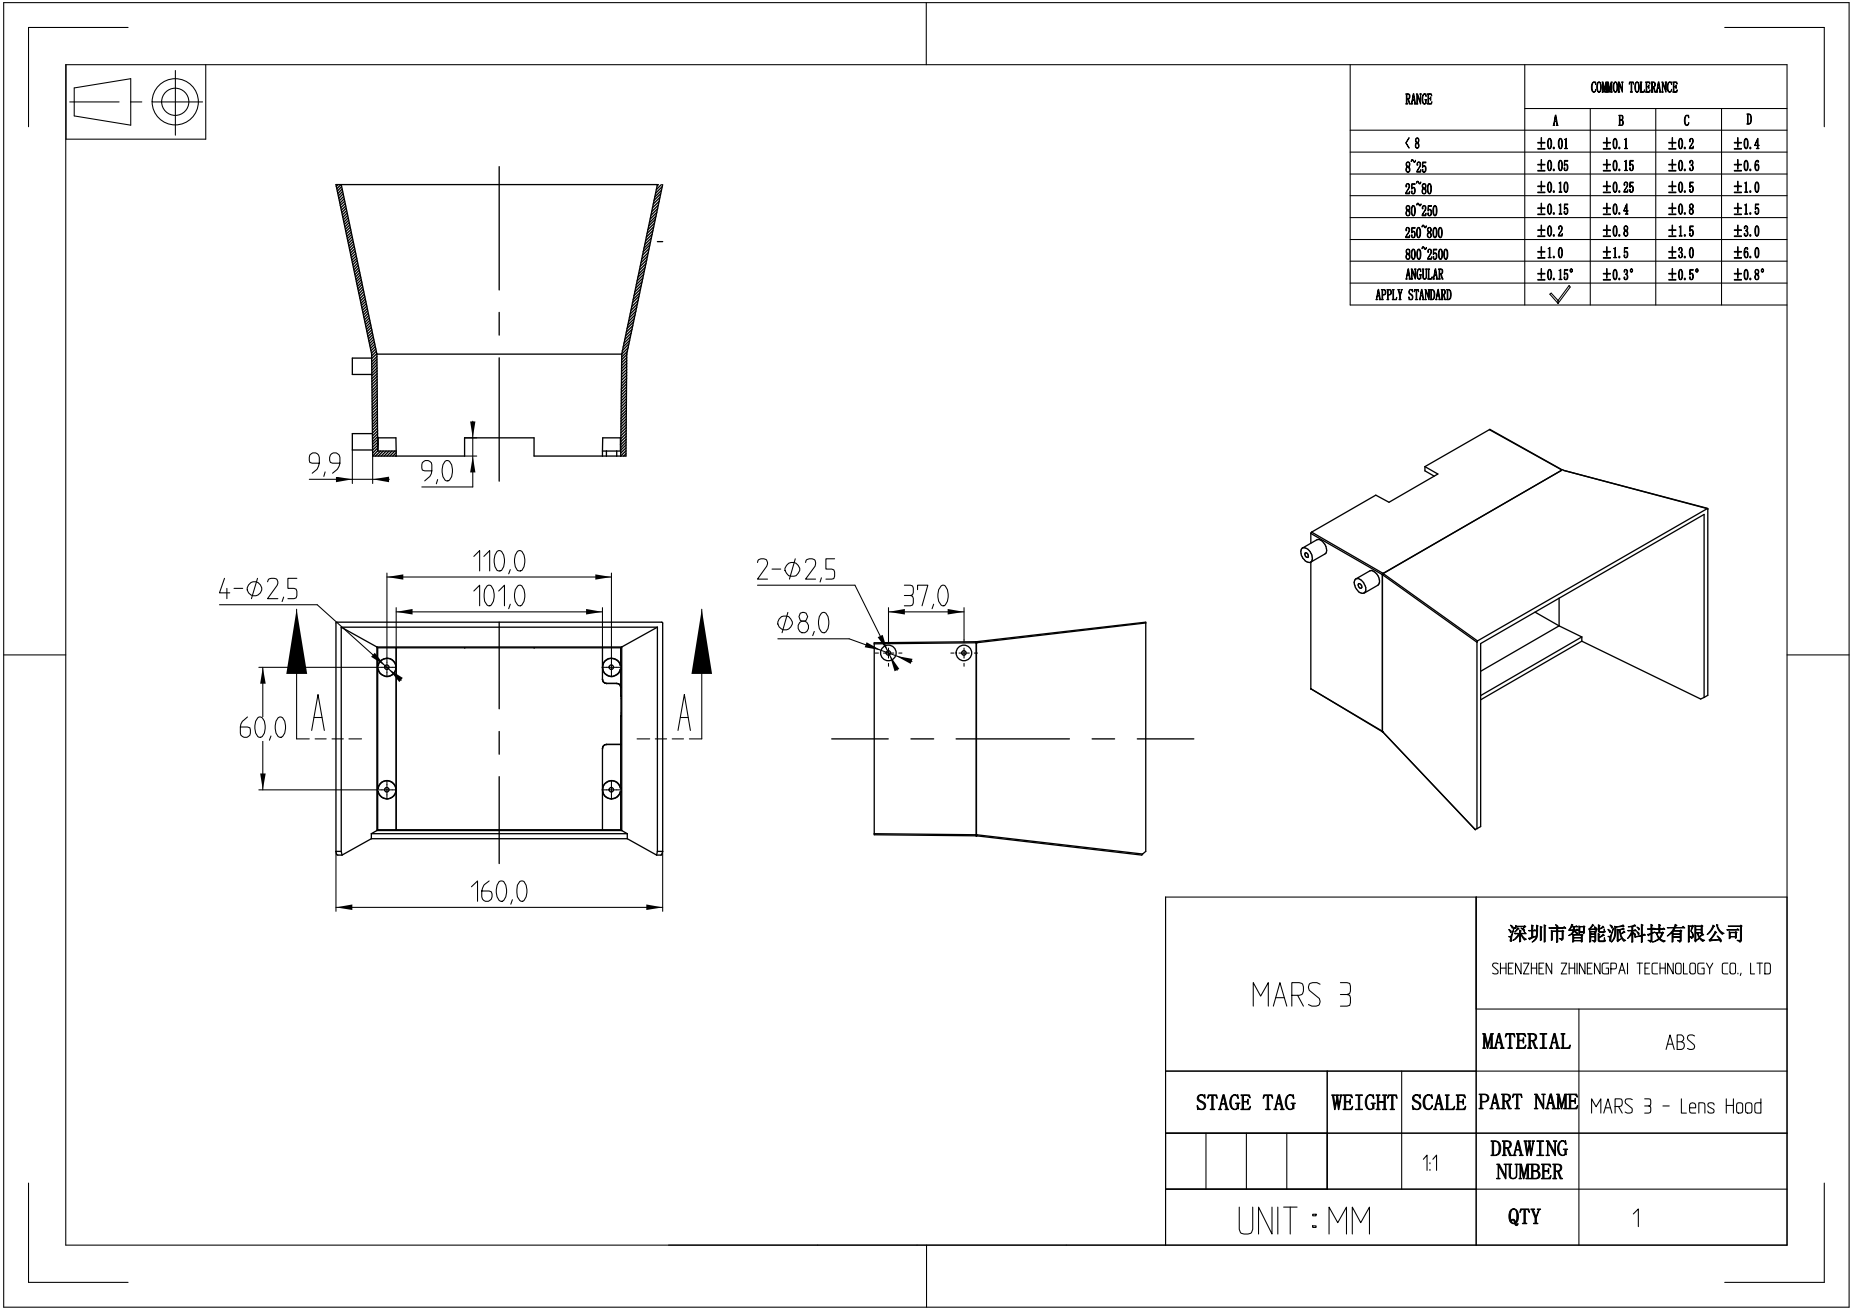
[picture p24: page 1]
