elegooofficial/Mars3/MARS 3  Mechanical/PDF/MARS 3 - Lens pressure plate.pdf

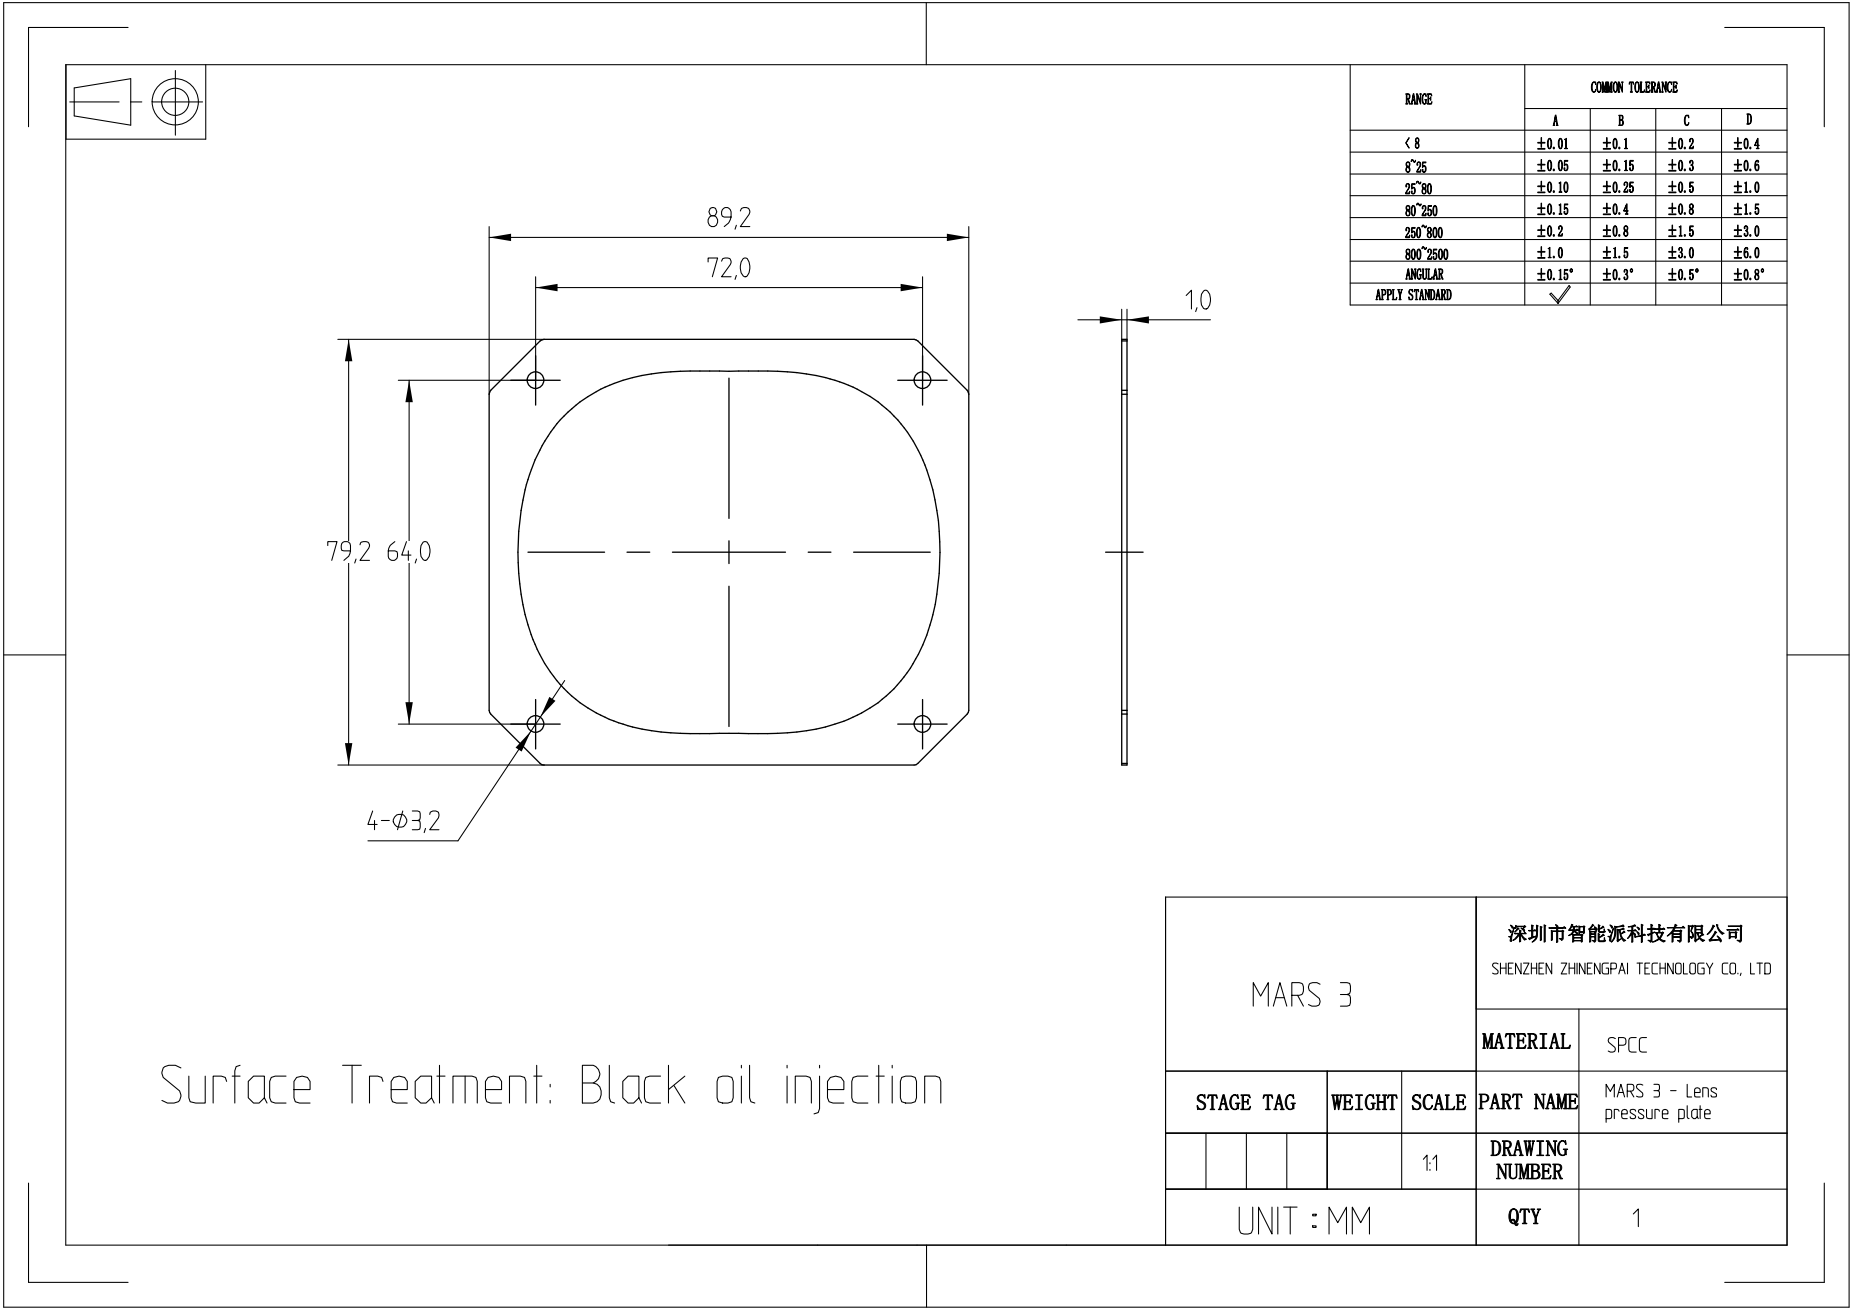
[picture p25: page 1]
