elegooofficial/Mars3/MARS 3  Mechanical/PDF/MARS 3 - Lens-Model.pdf

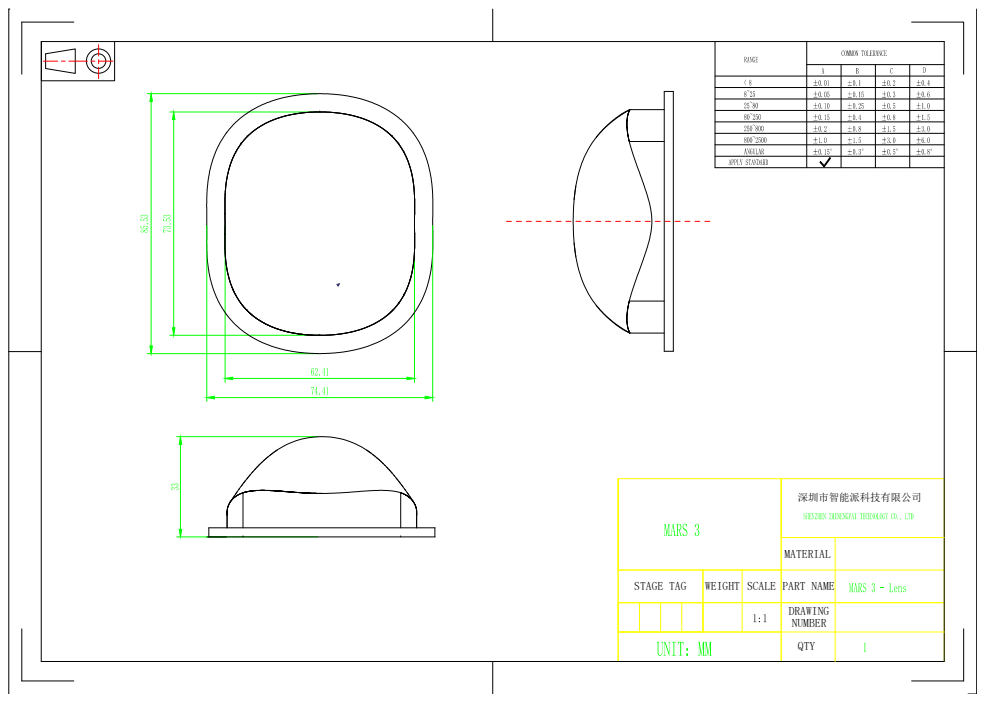
[picture p26: page 1]
