elegooofficial/Mars3/MARS 3  Mechanical/PDF/MARS 3 - Line rail fixing plate.pdf

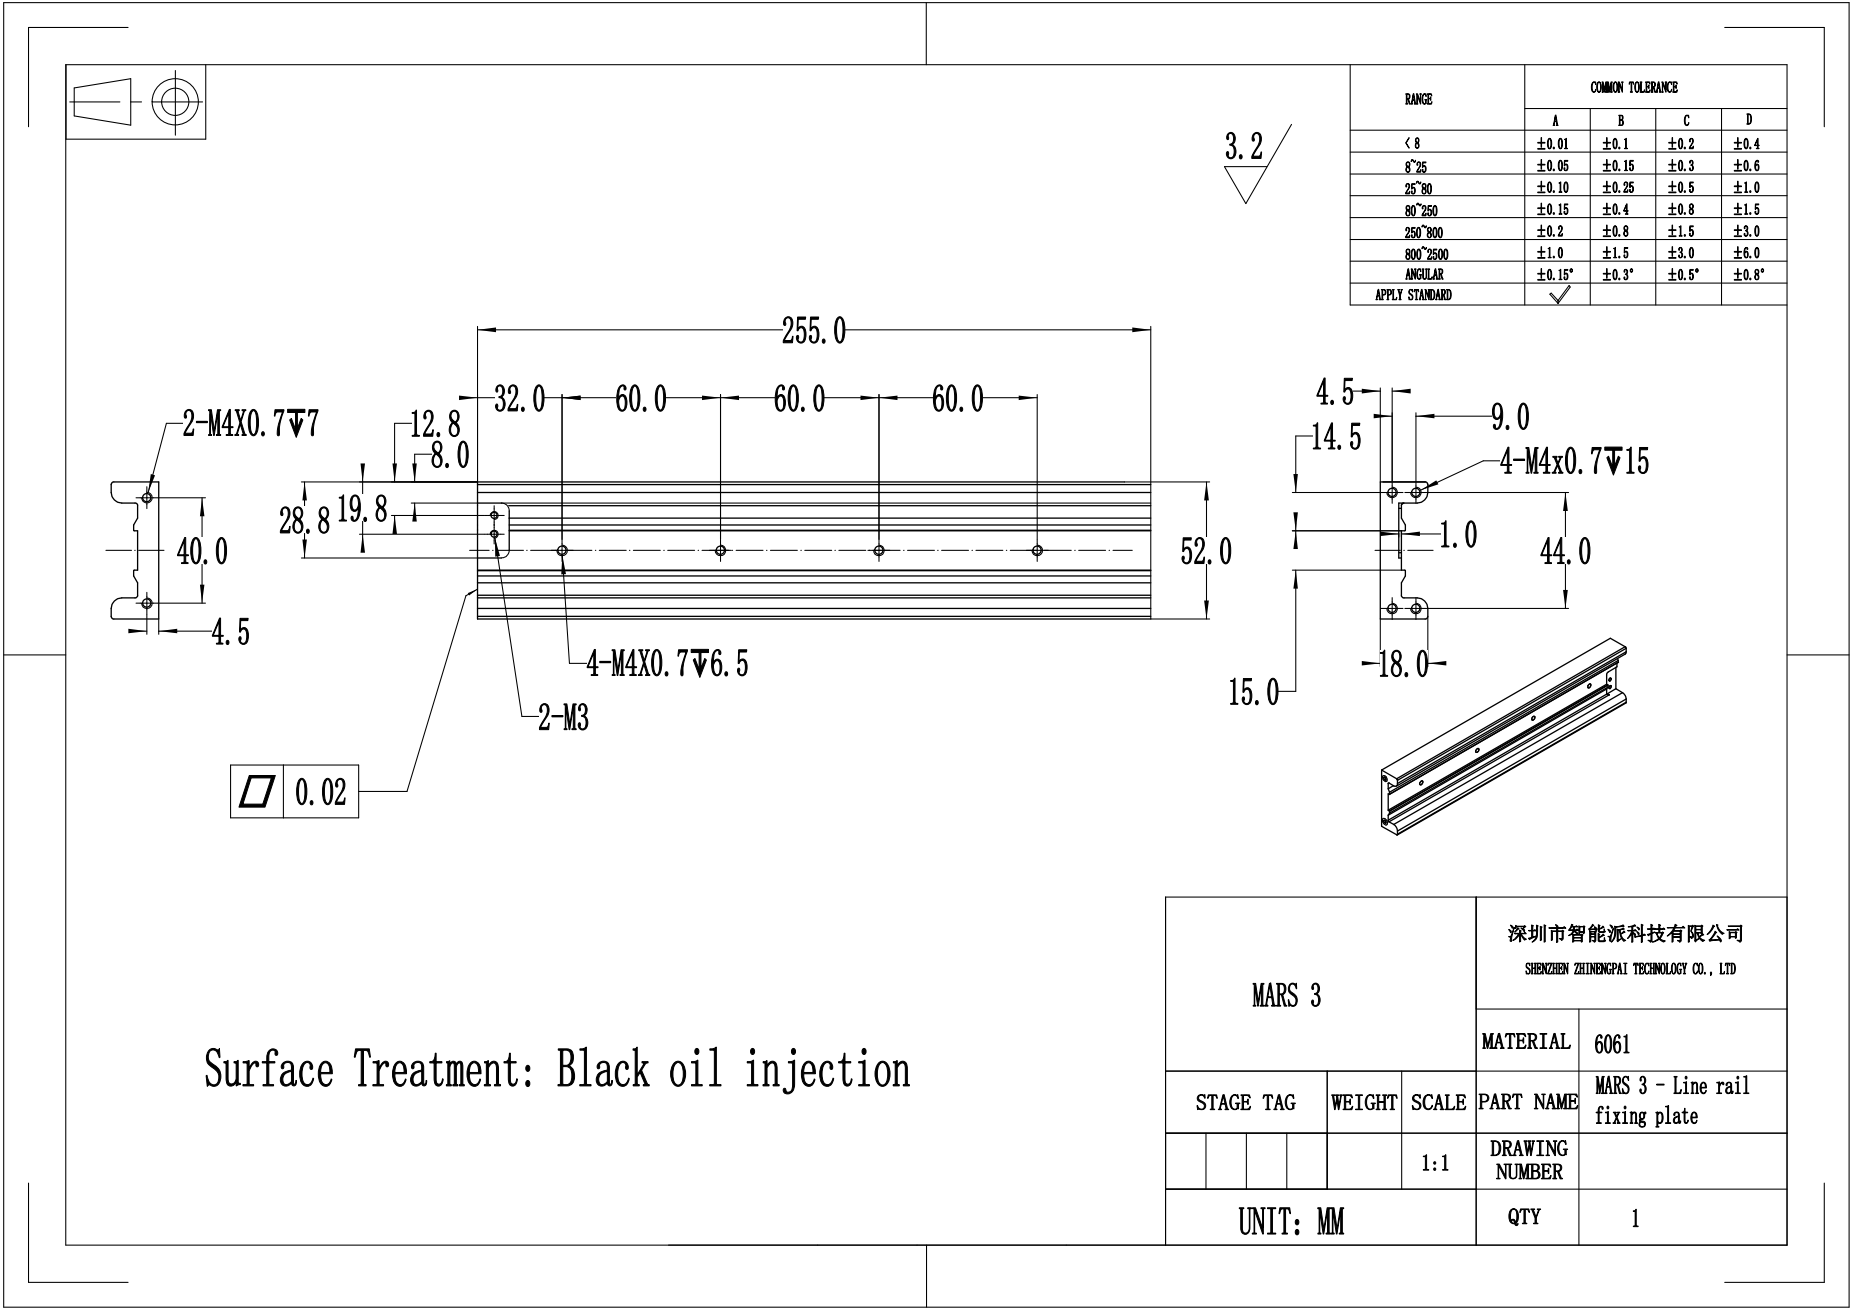
[picture p27: page 1]
