elegooofficial/Mars3/MARS 3  Mechanical/PDF/MARS 3 - Linear rail + slider.pdf

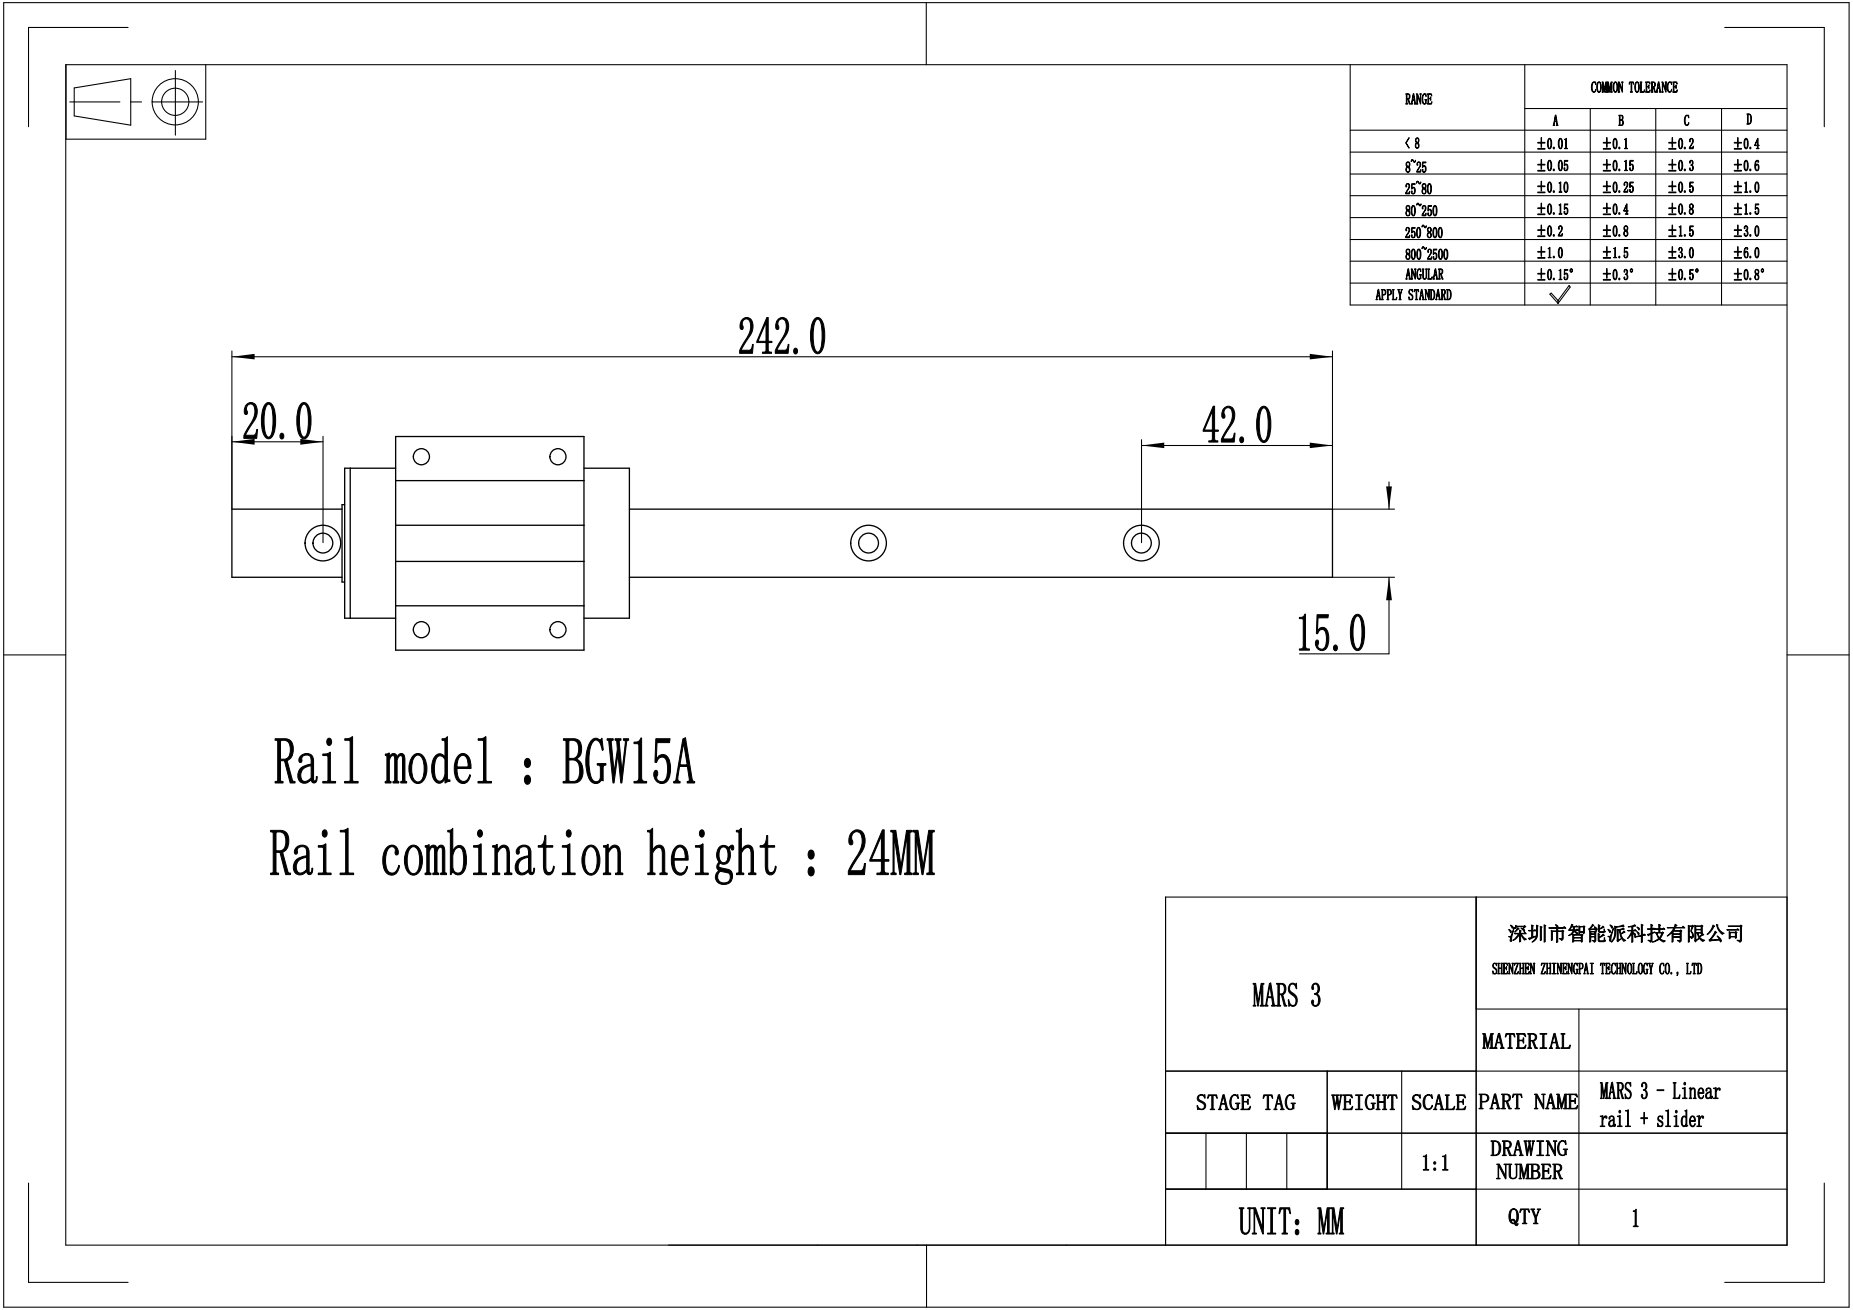
[picture p28: page 1]
