elegooofficial/Mars3/MARS 3  Mechanical/PDF/MARS 3 - Lower pressure plate of resin tank.pdf

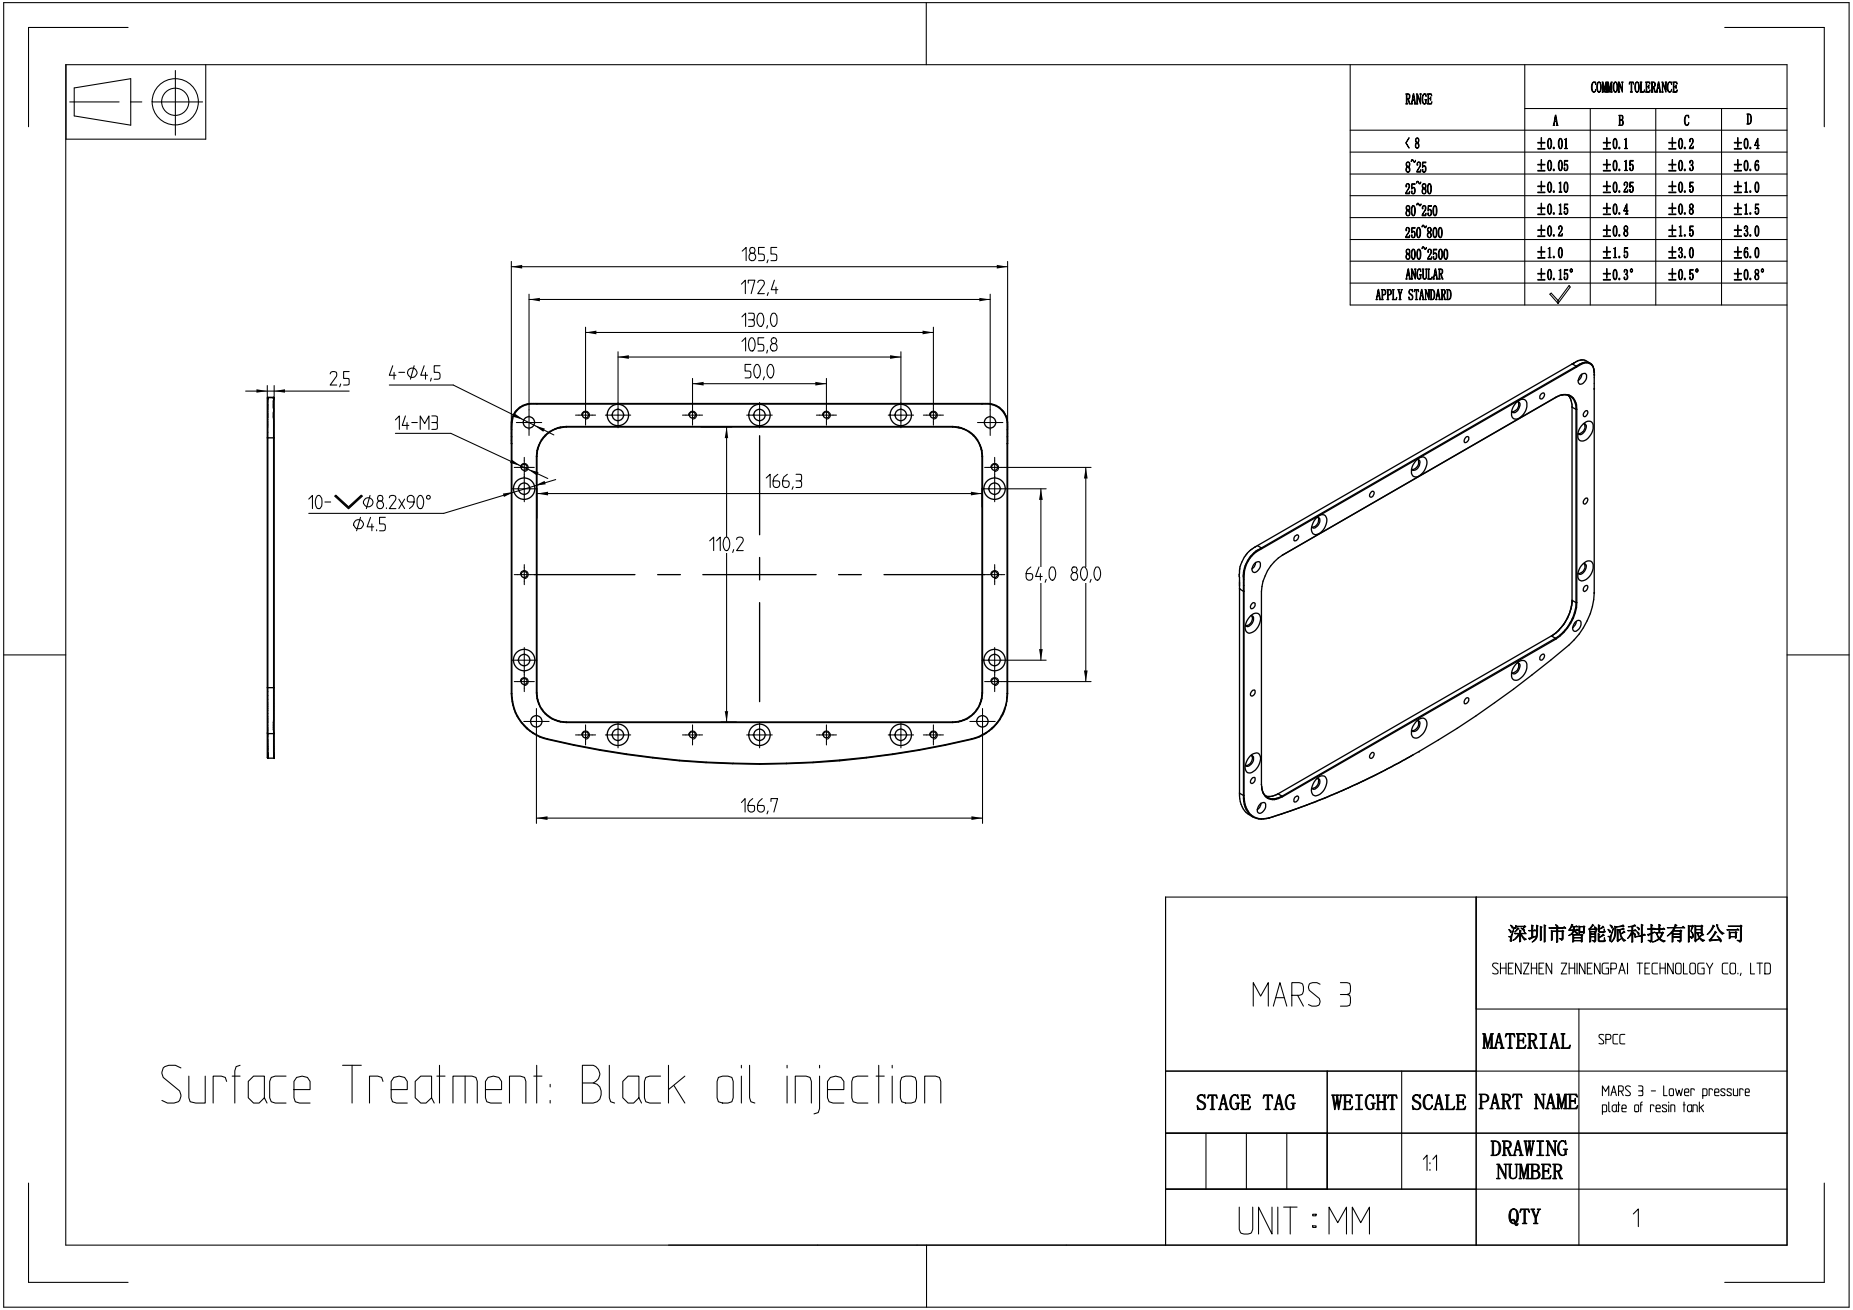
[picture p29: page 1]
