elegooofficial/Mars3/MARS 3  Mechanical/PDF/MARS 3 - Motor cable.pdf

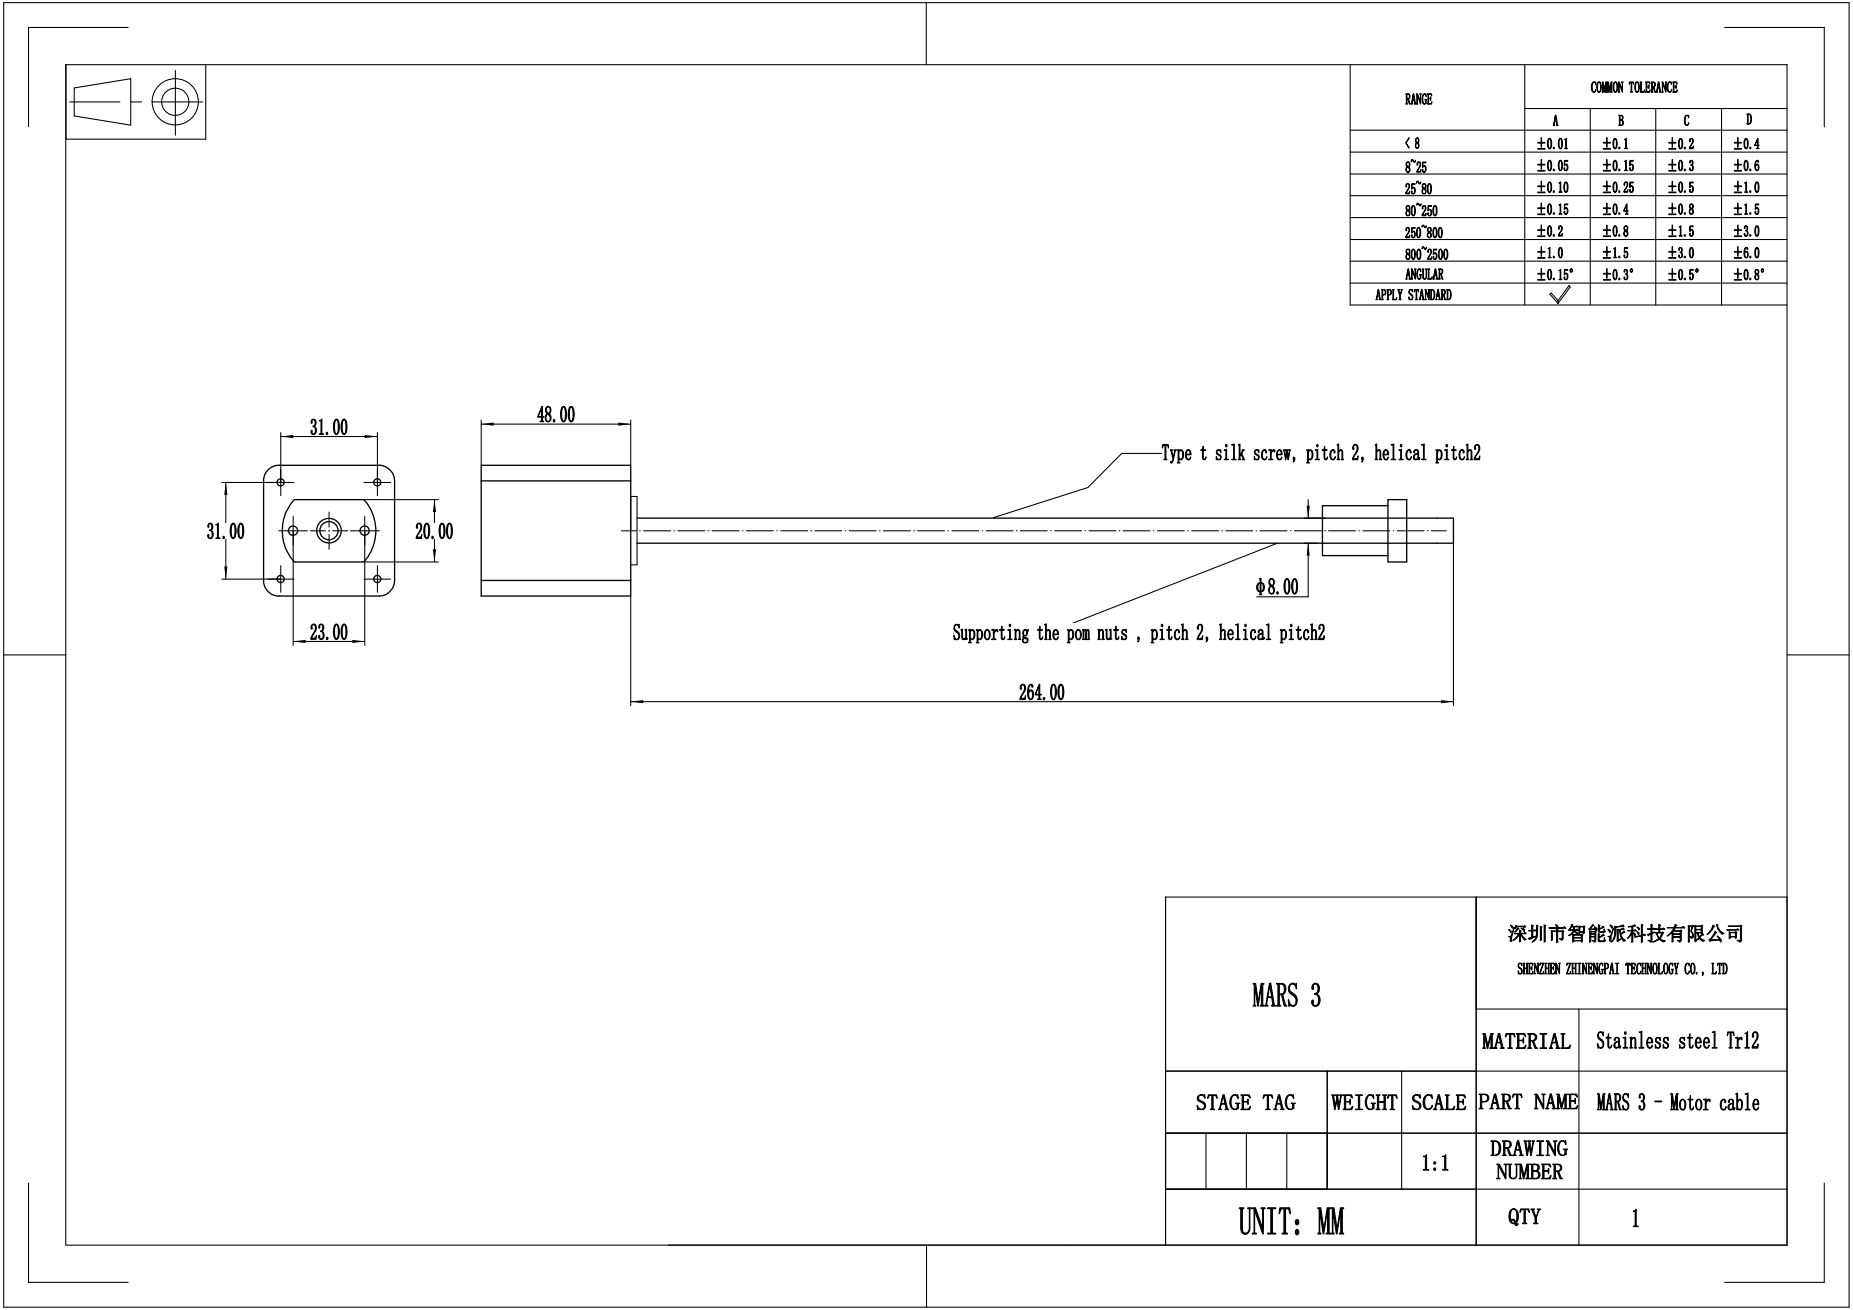
[picture p30: page 1]
