elegooofficial/Mars3/MARS 3  Mechanical/PDF/MARS 3 - Protective film of resin tank.pdf

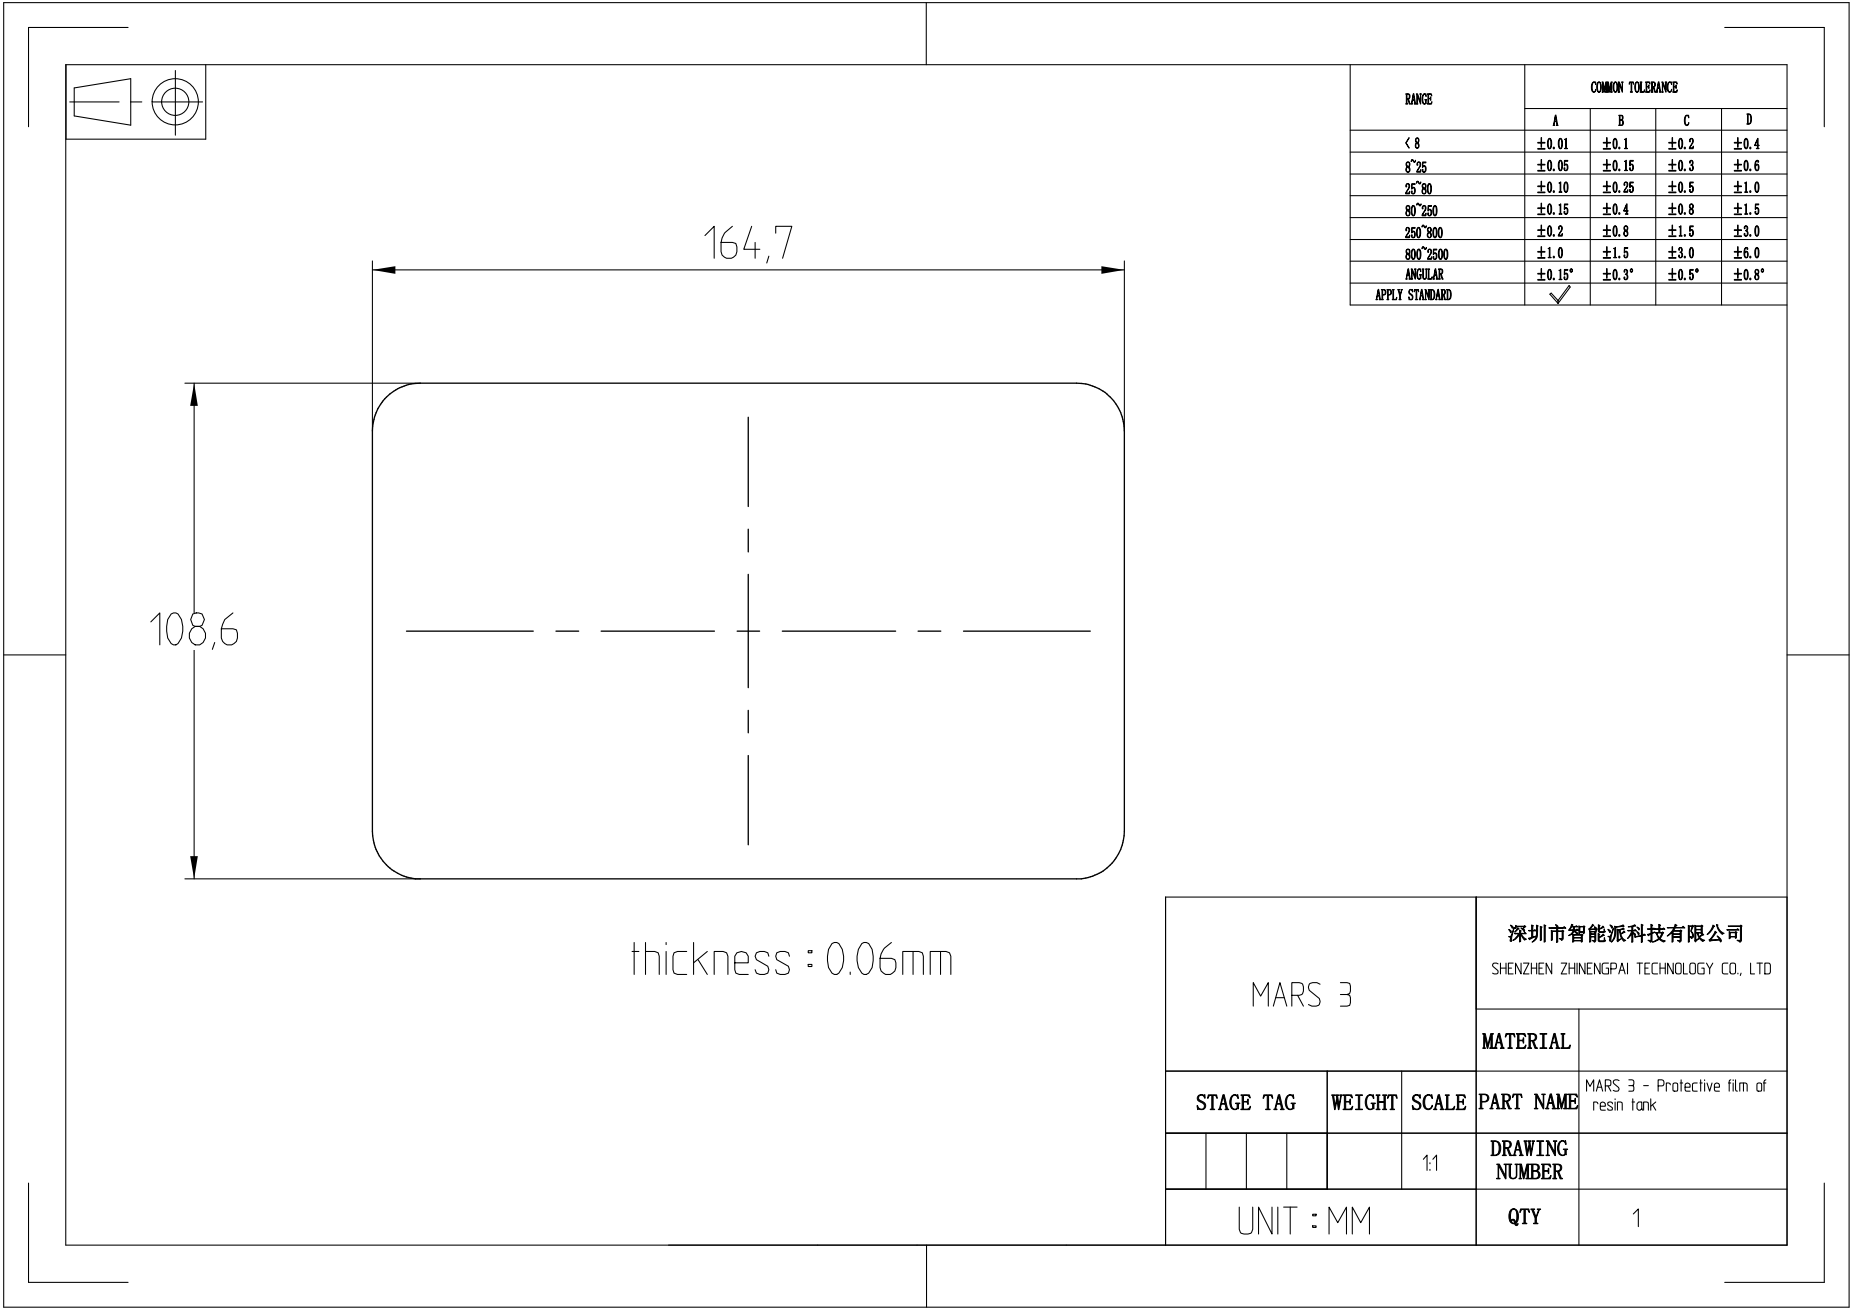
[picture p31: page 1]
