elegooofficial/Mars3/MARS 3  Mechanical/PDF/MARS 3 - PVC surface sticker-Model.pdf

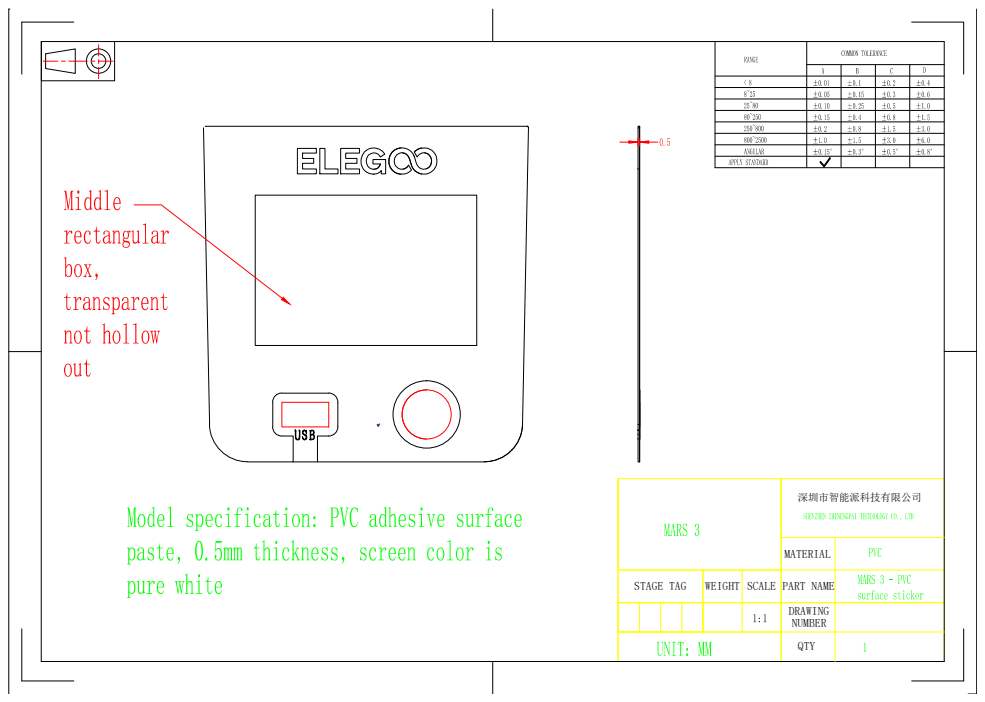
[picture p32: page 1]
