elegooofficial/Mars3/MARS 3  Mechanical/PDF/MARS 3 - Resin tank.pdf

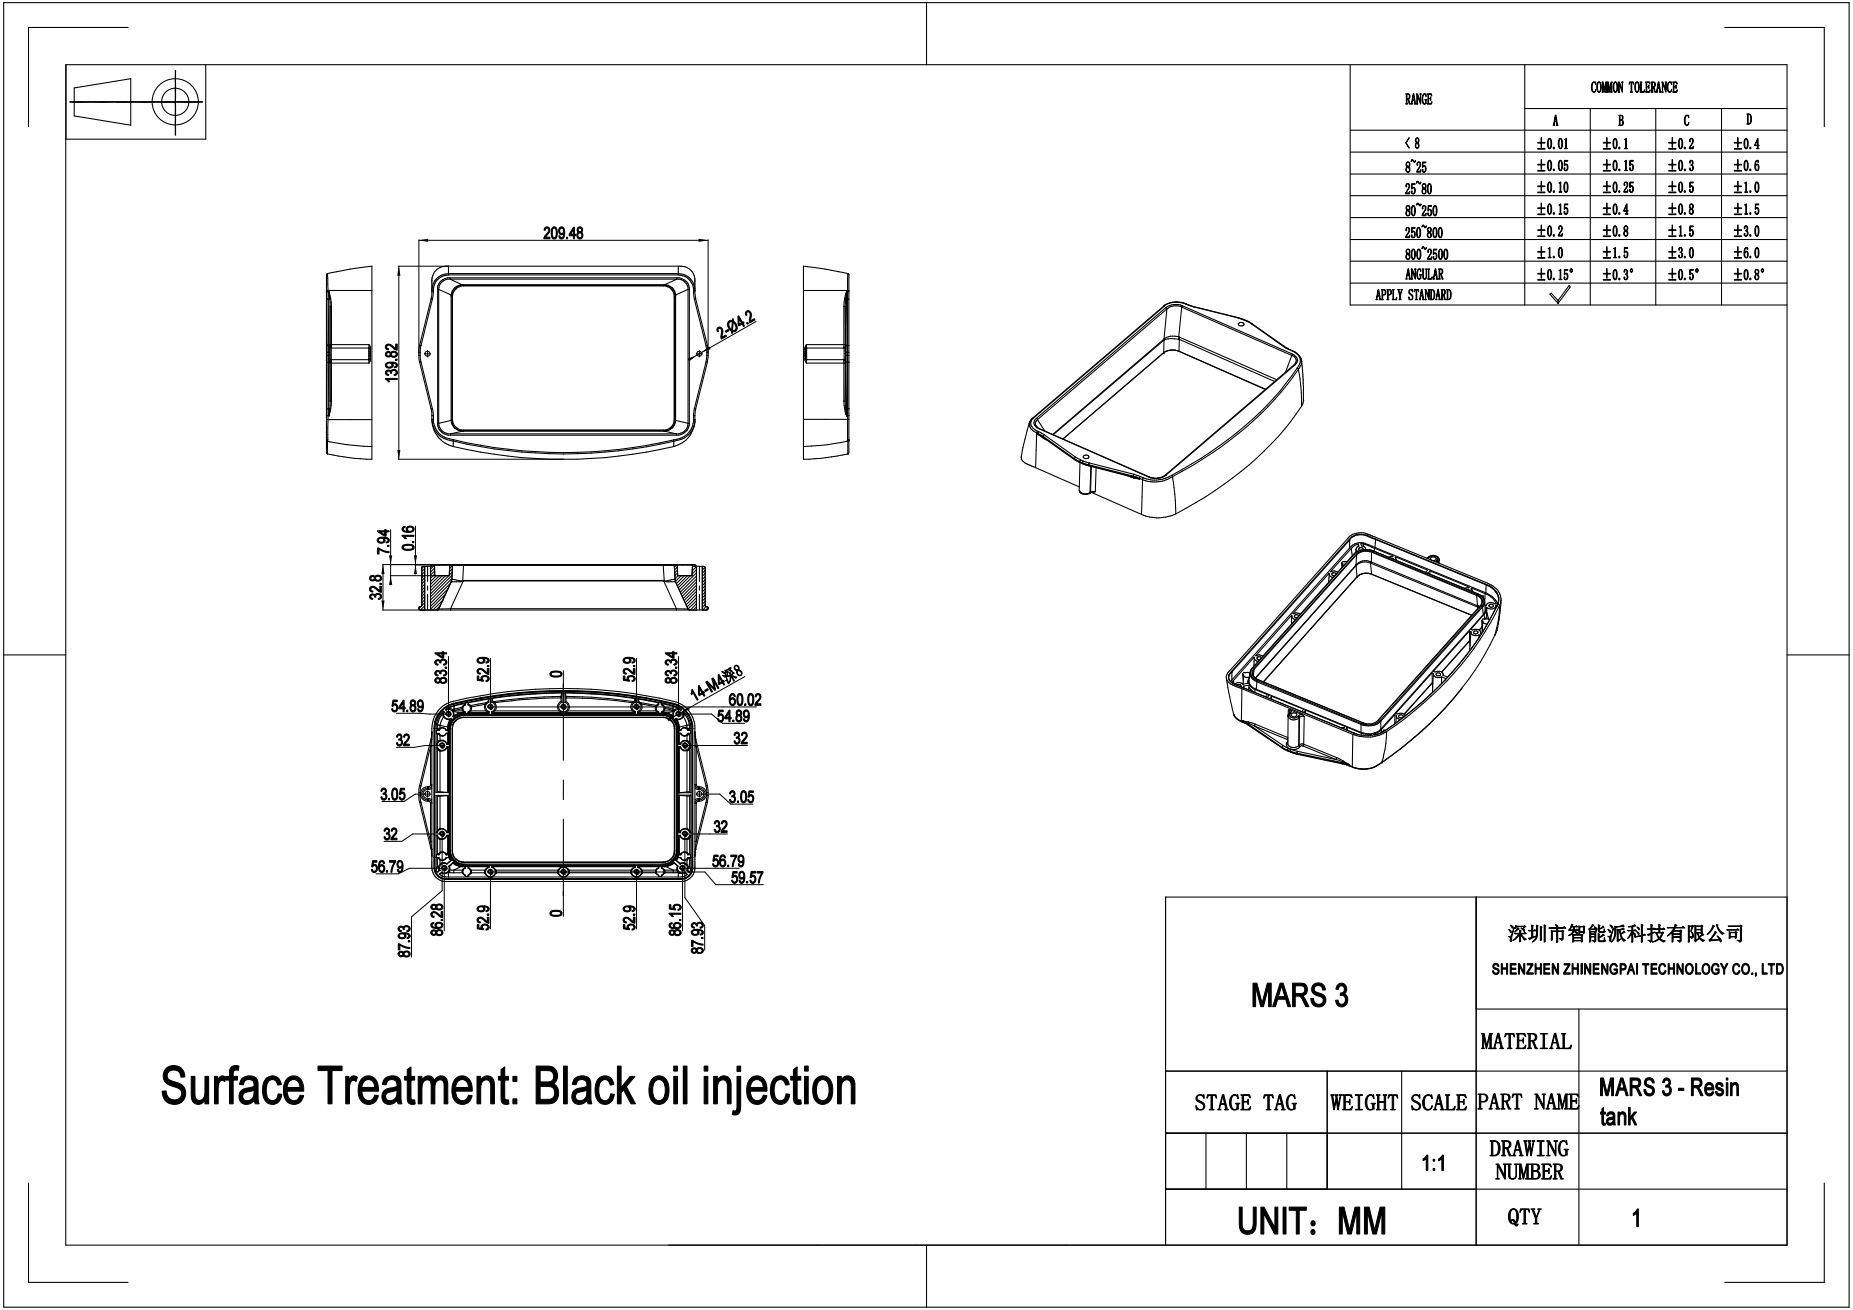
[picture p33: page 1]
