elegooofficial/Mars3/MARS 3  Mechanical/PDF/MARS 3 - Screen fixing tape.pdf

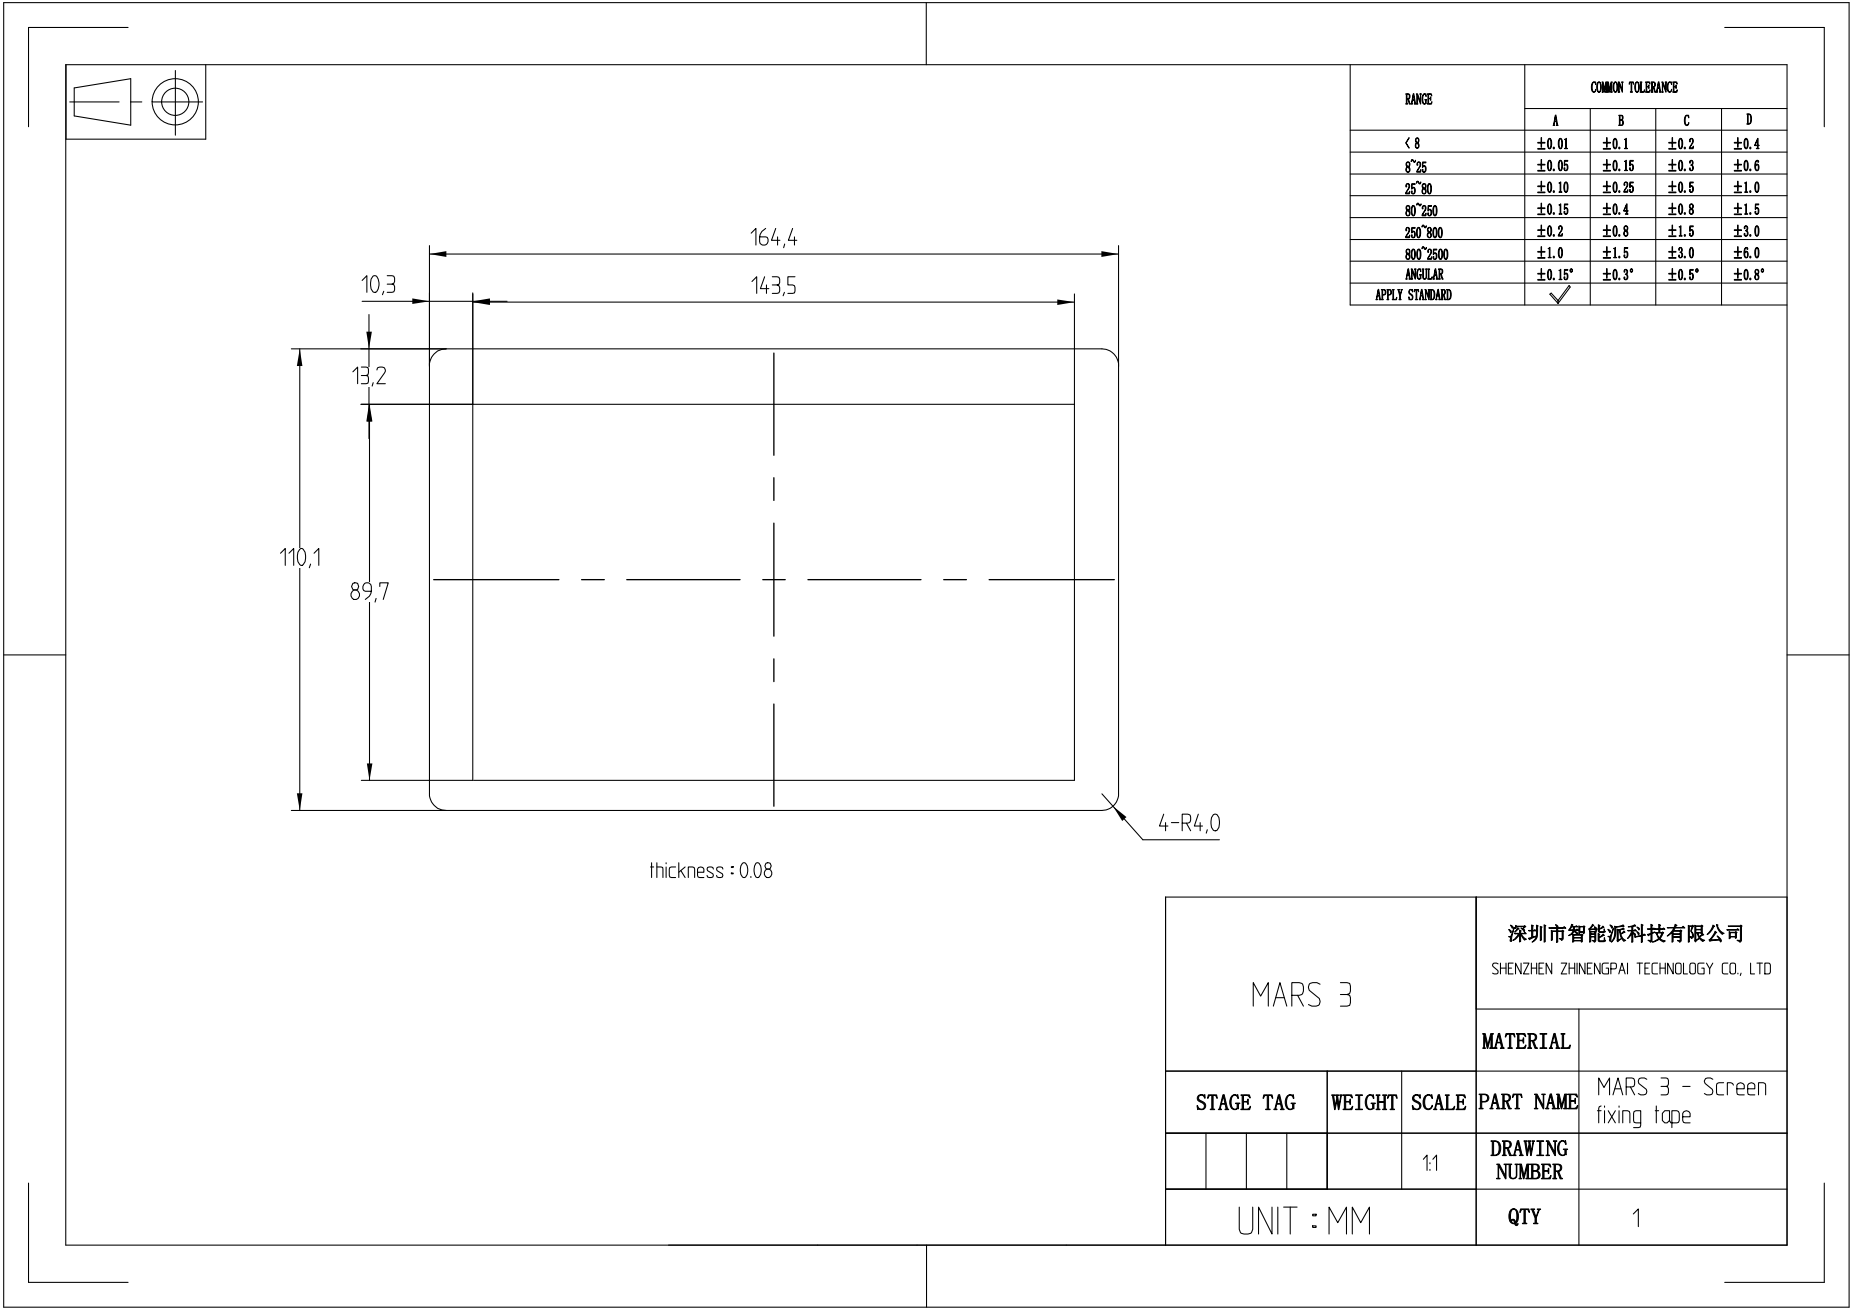
[picture p34: page 1]
