elegooofficial/Mars3/MARS 3  Mechanical/PDF/MARS 3 - Shell.pdf

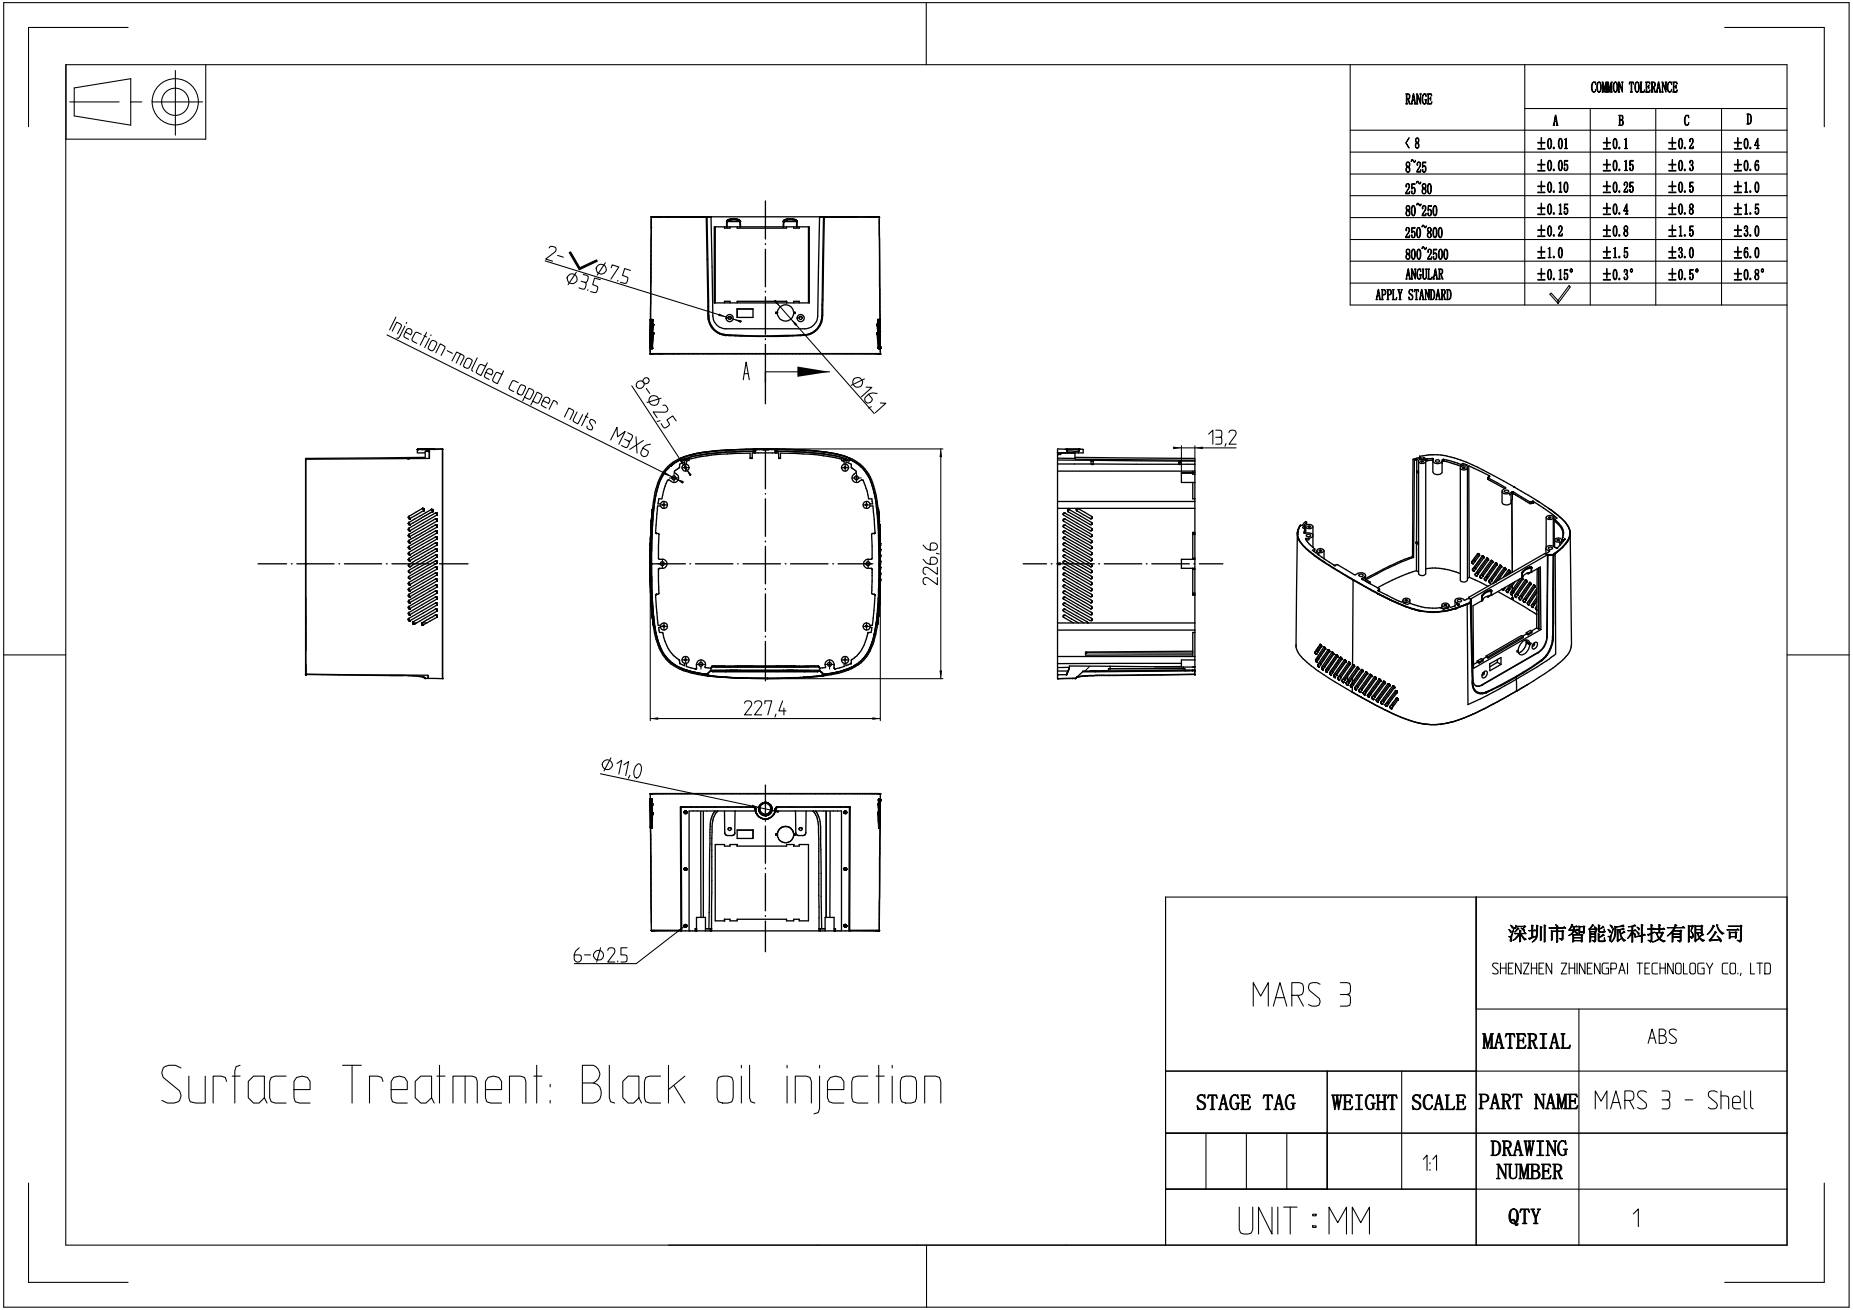
[picture p35: page 1]
