elegooofficial/Mars3/MARS 3  Mechanical/PDF/MARS 3 - Silicone Gasket.pdf

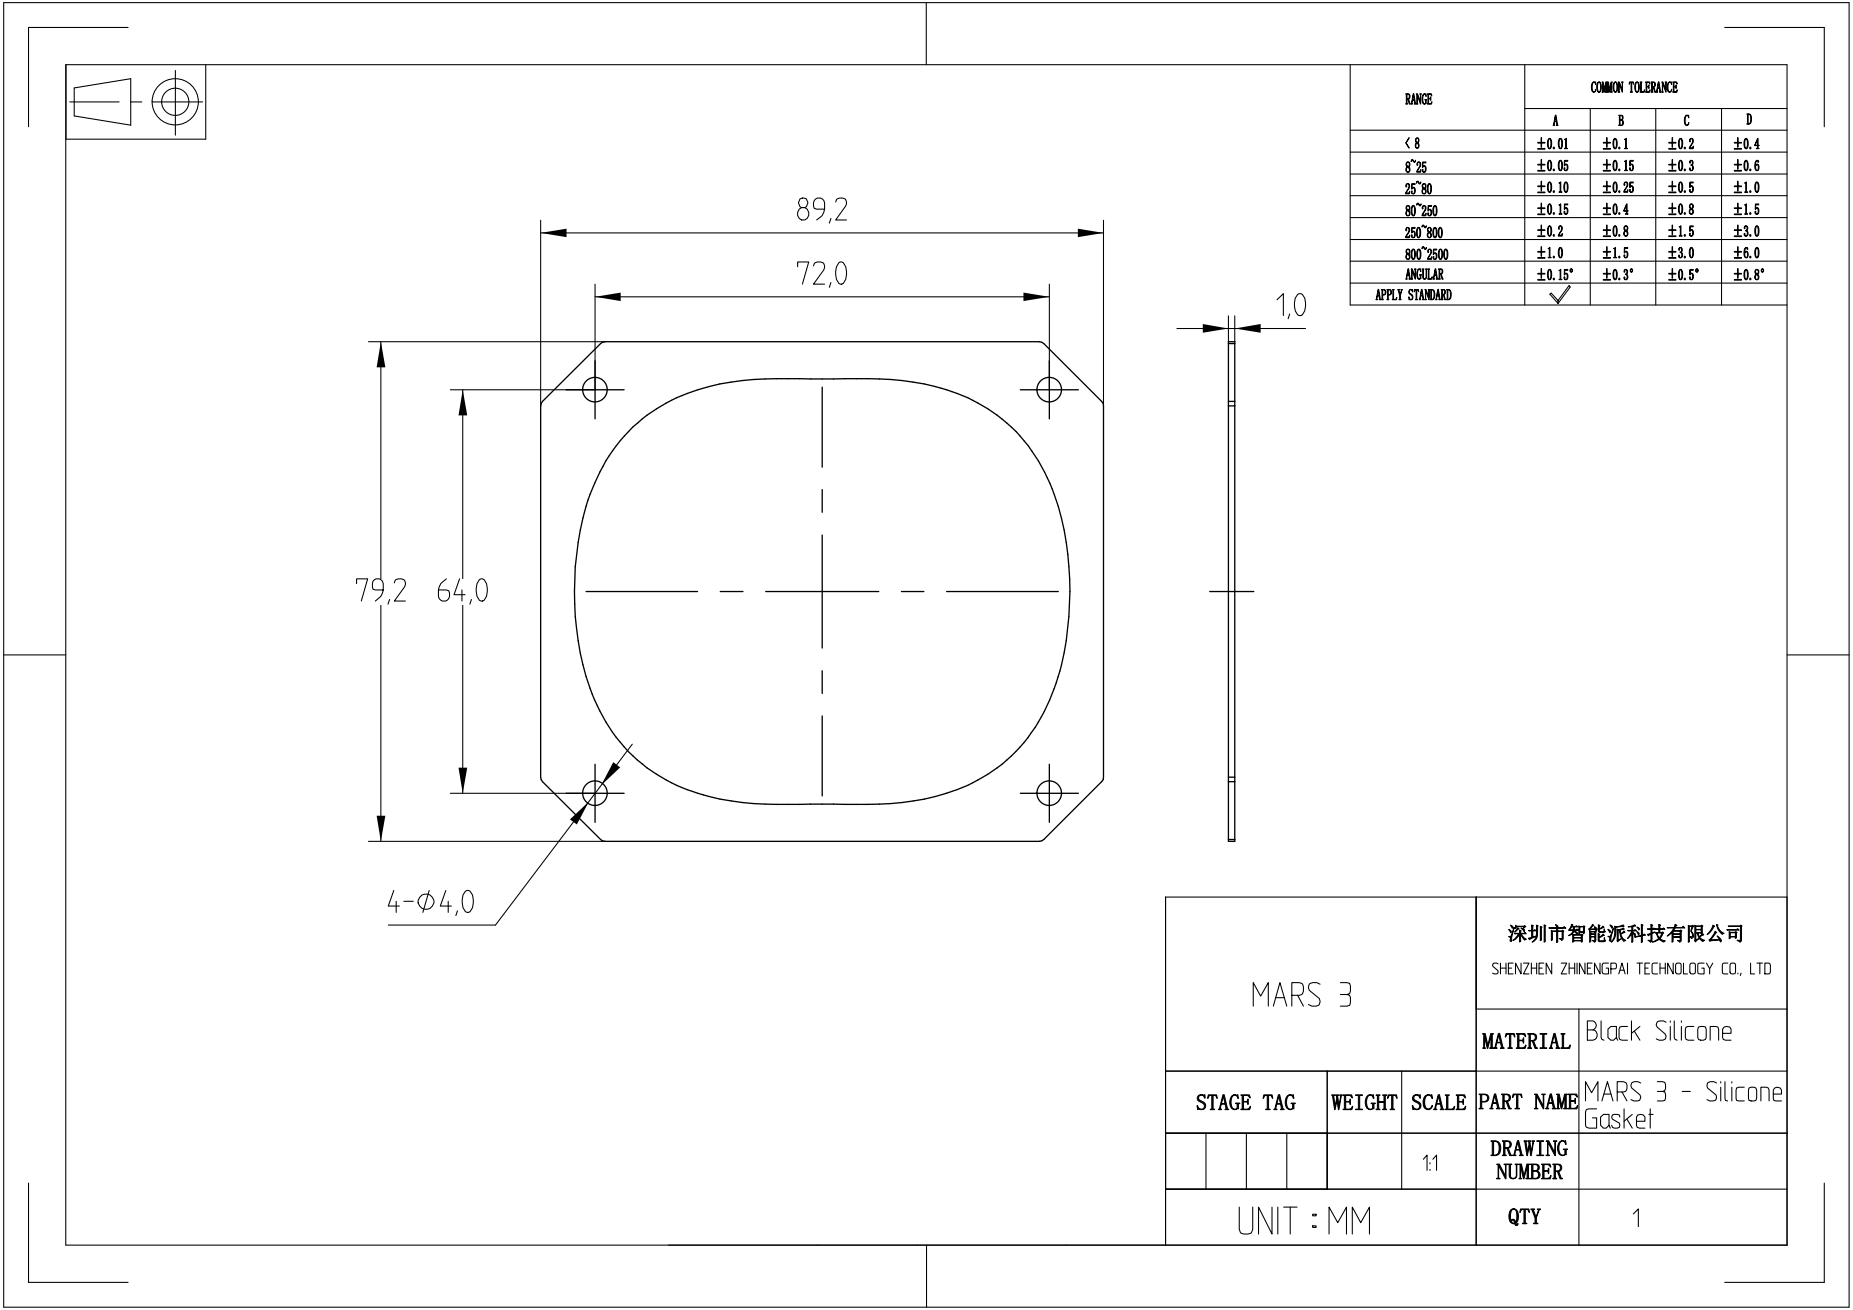
[picture p36: page 1]
