elegooofficial/Mars3/MARS 3  Mechanical/PDF/MARS 3 - Upper pressure plate of resin tank.pdf

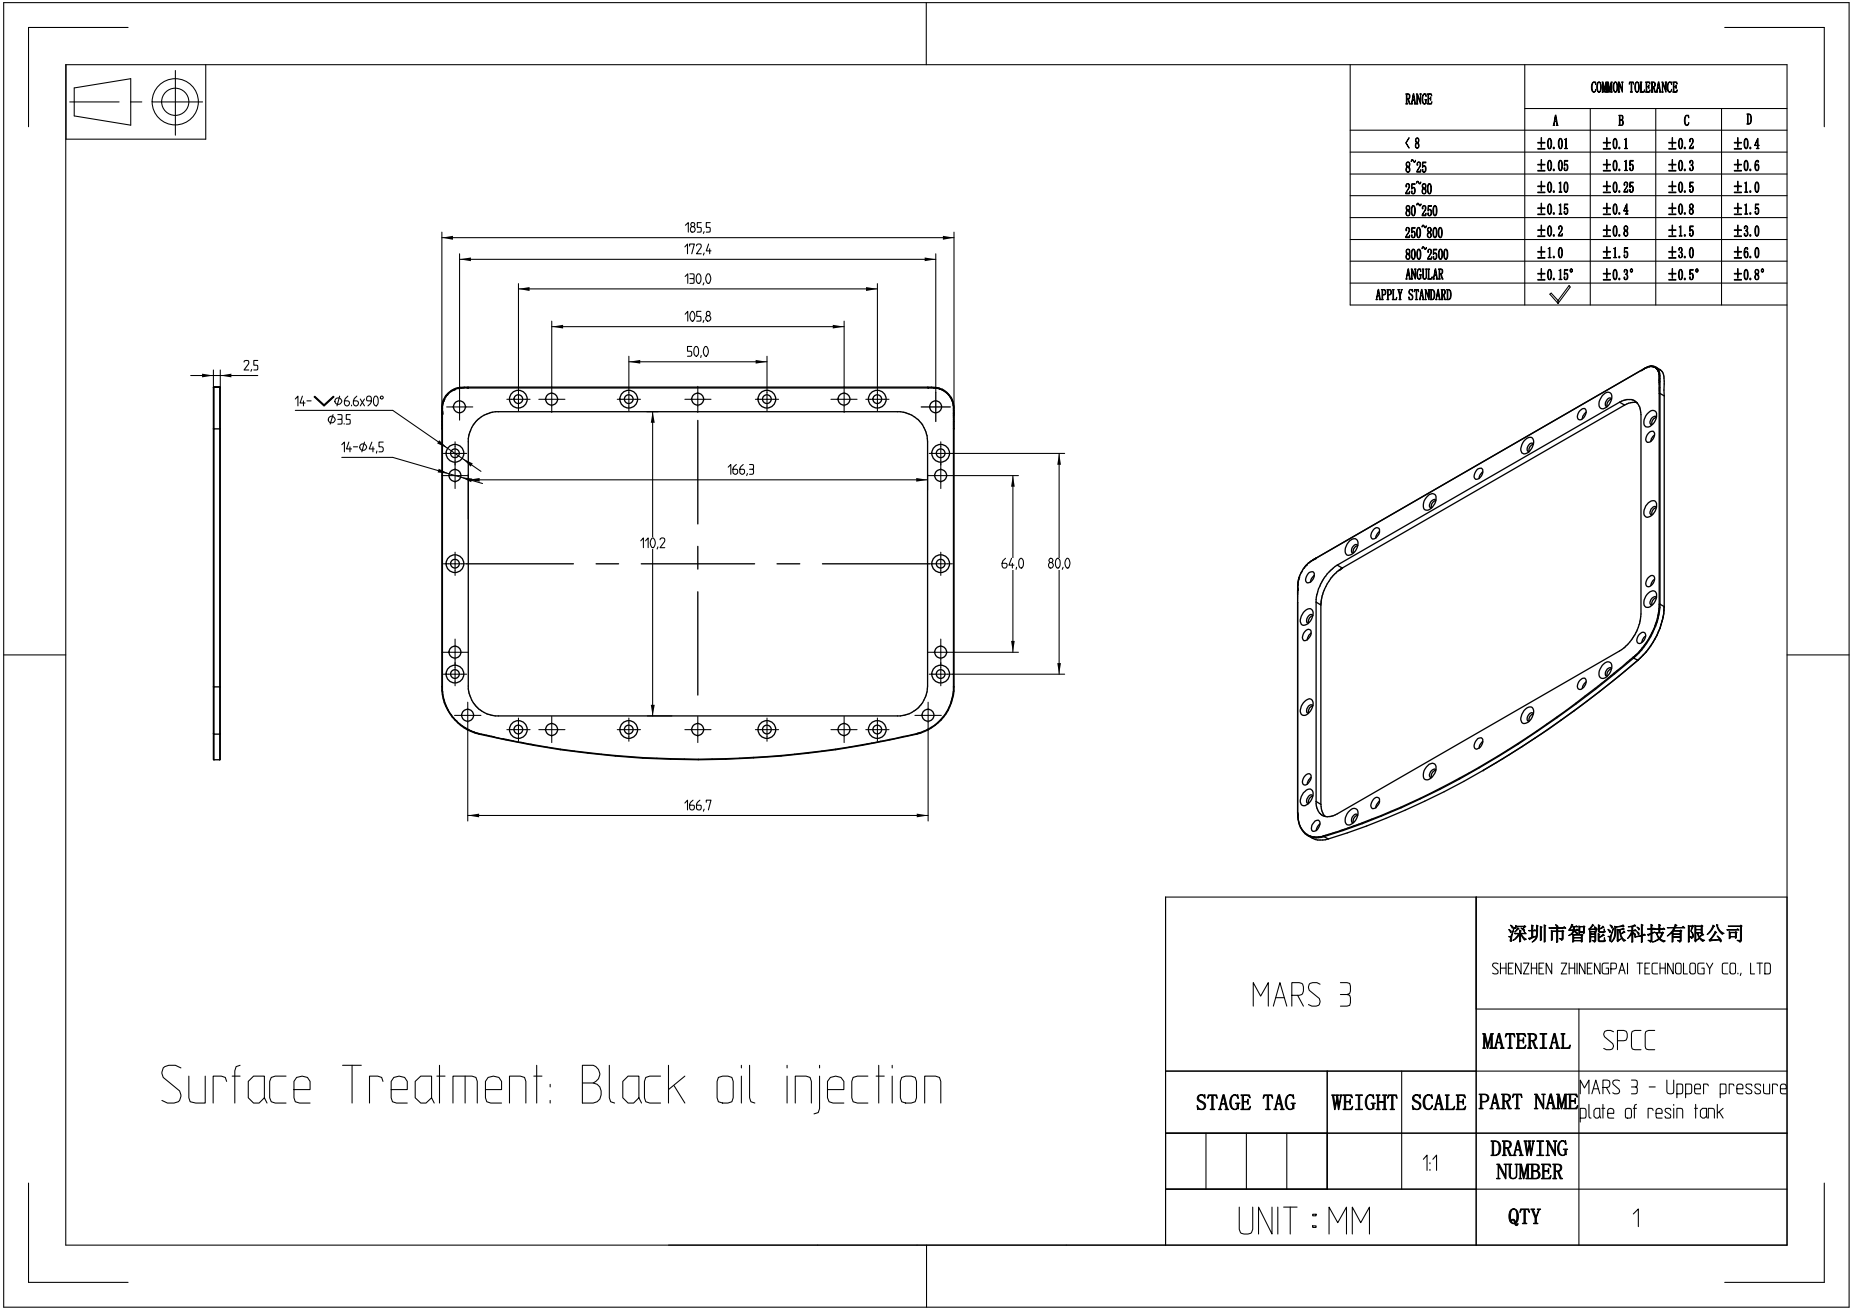
[picture p37: page 1]
