elegooofficial/Mars3/MARS 3  Mechanical/PDF/MARS 3 -Button cap.pdf

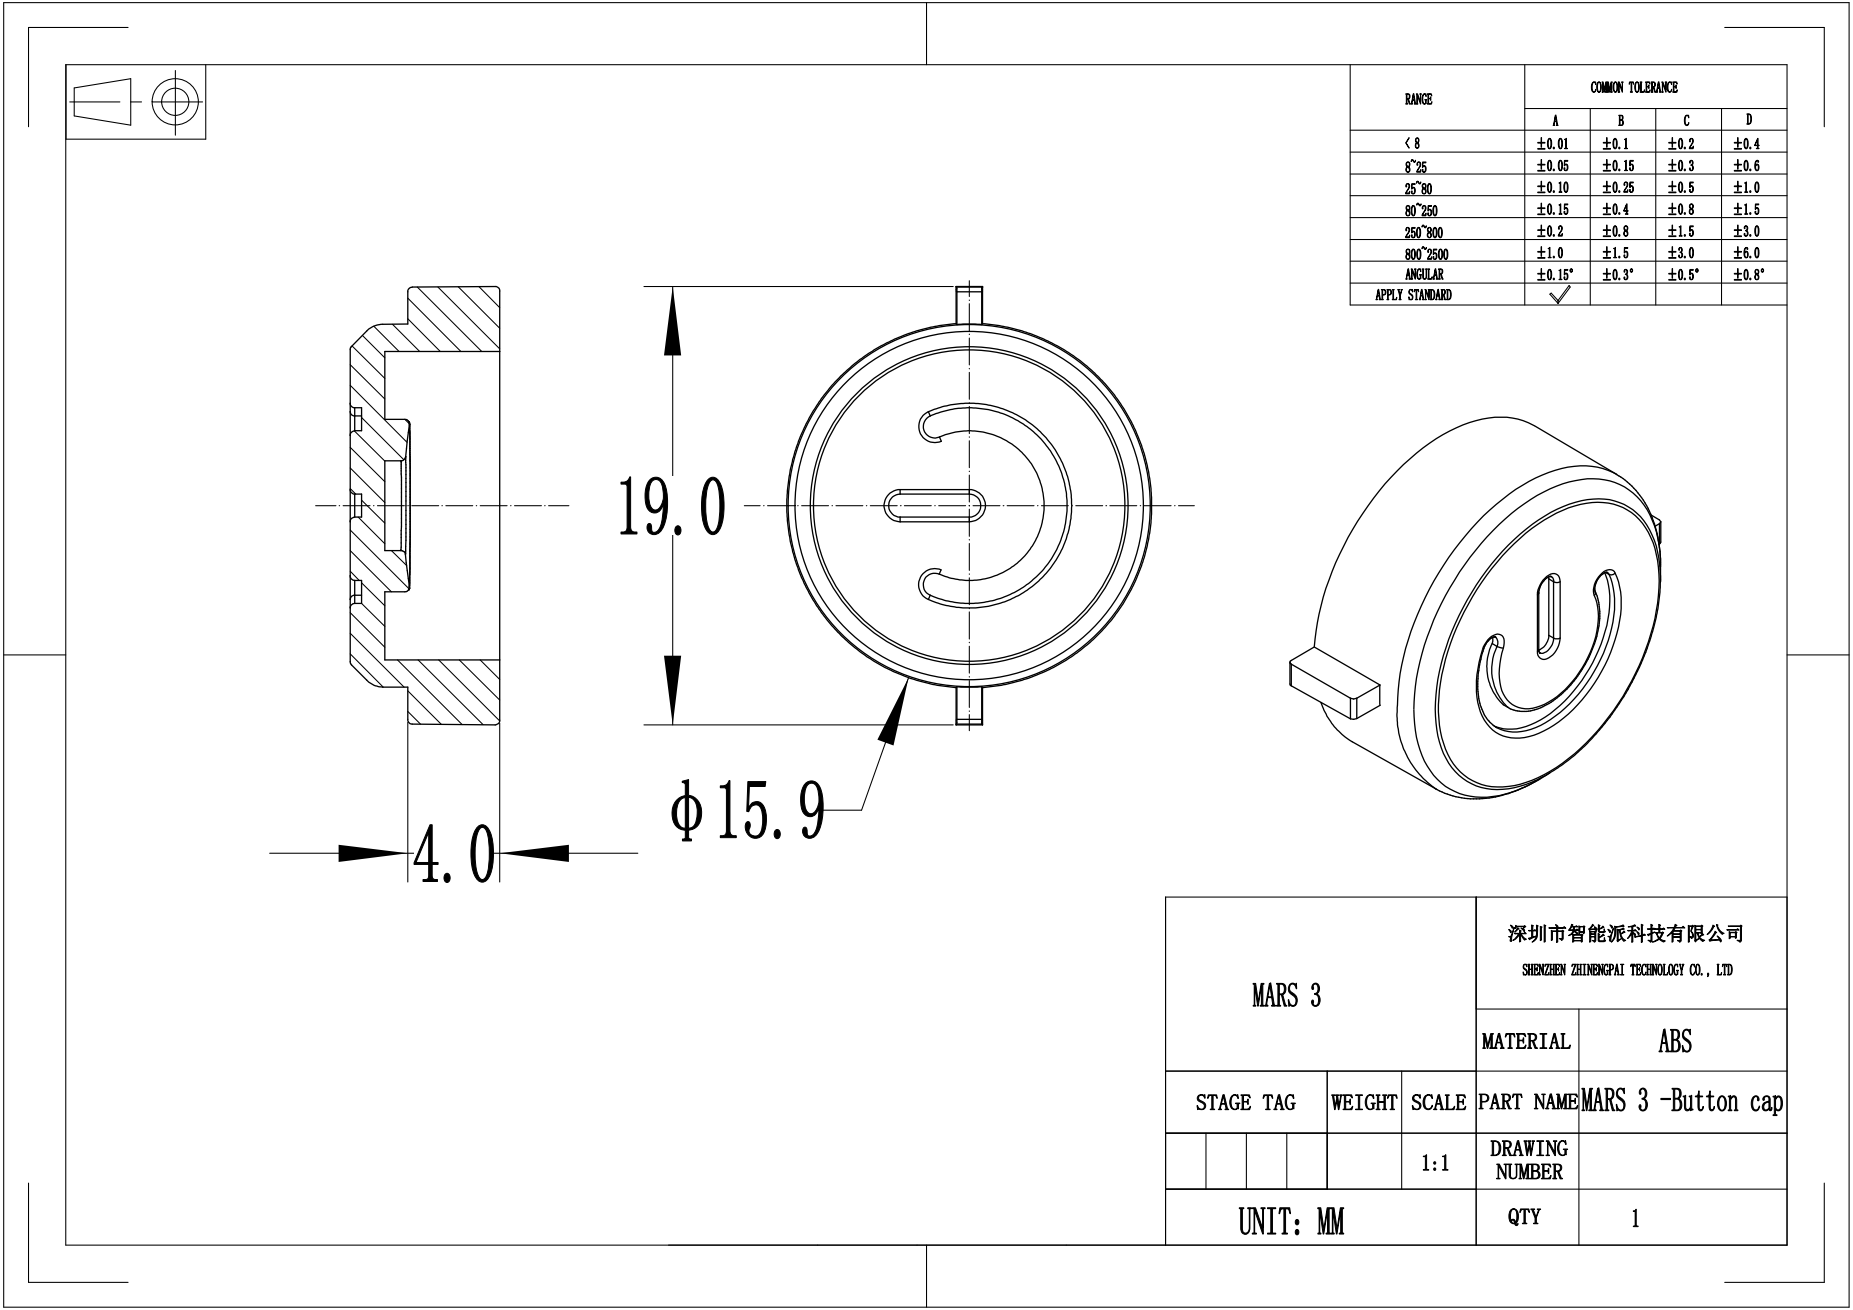
[picture p38: page 1]
