elegooofficial/Mars3/MARS 3  Mechanical/PDF/MARS 3 -Plate-Model.pdf

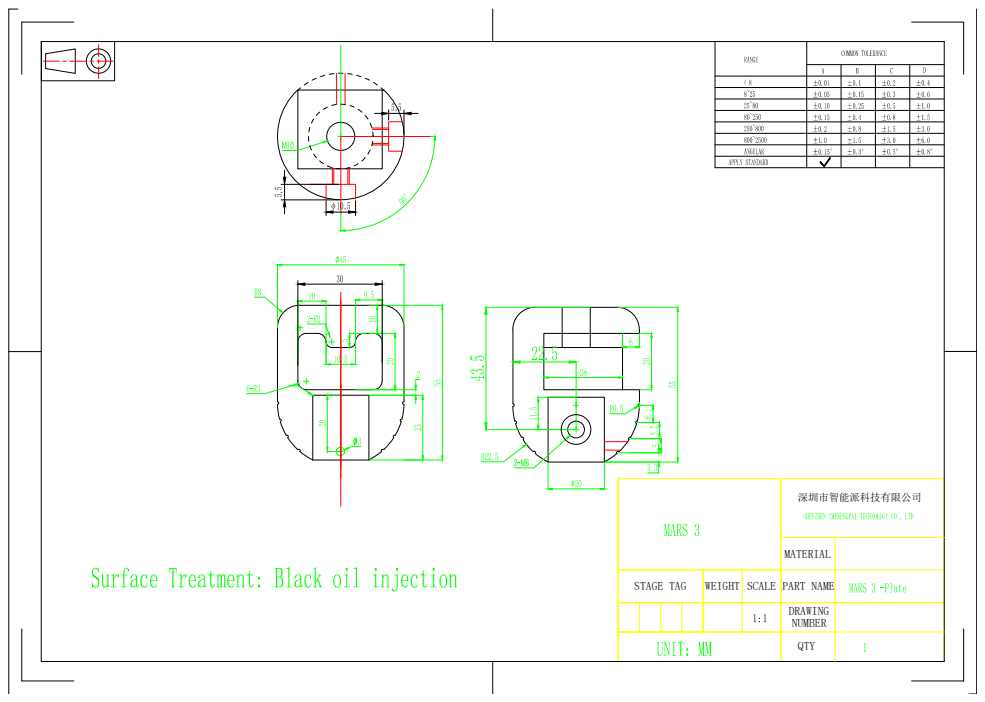
[picture p39: page 1]
