elegooofficial/Mars3/MARS 3  Mechanical/PDF/MARS 3 medium plate .pdf

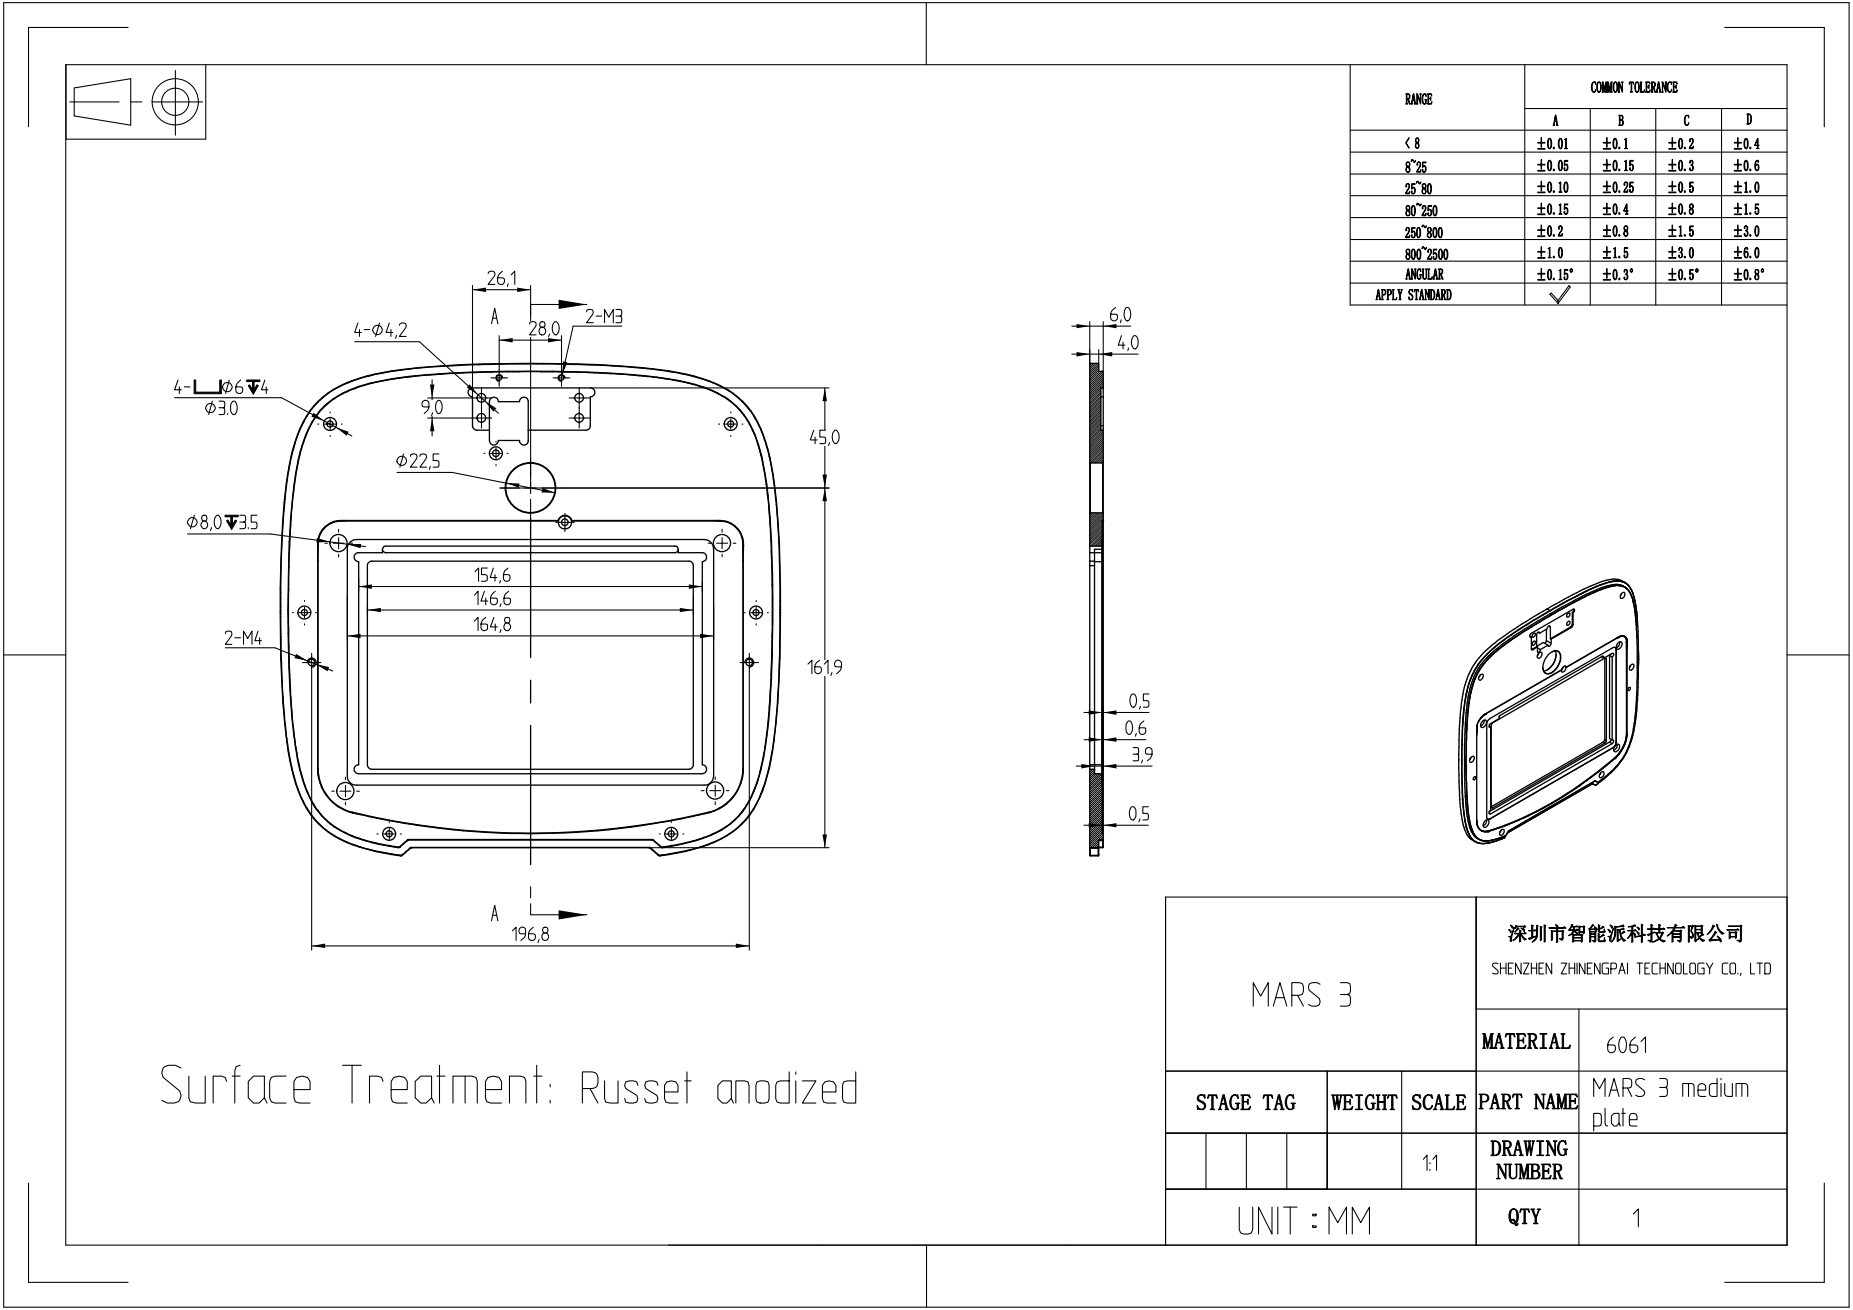
[picture p40: page 1]
