elegooofficial/Mars3/MARS 3  Mechanical/PDF/MARS 3 Z-axis connection block.pdf

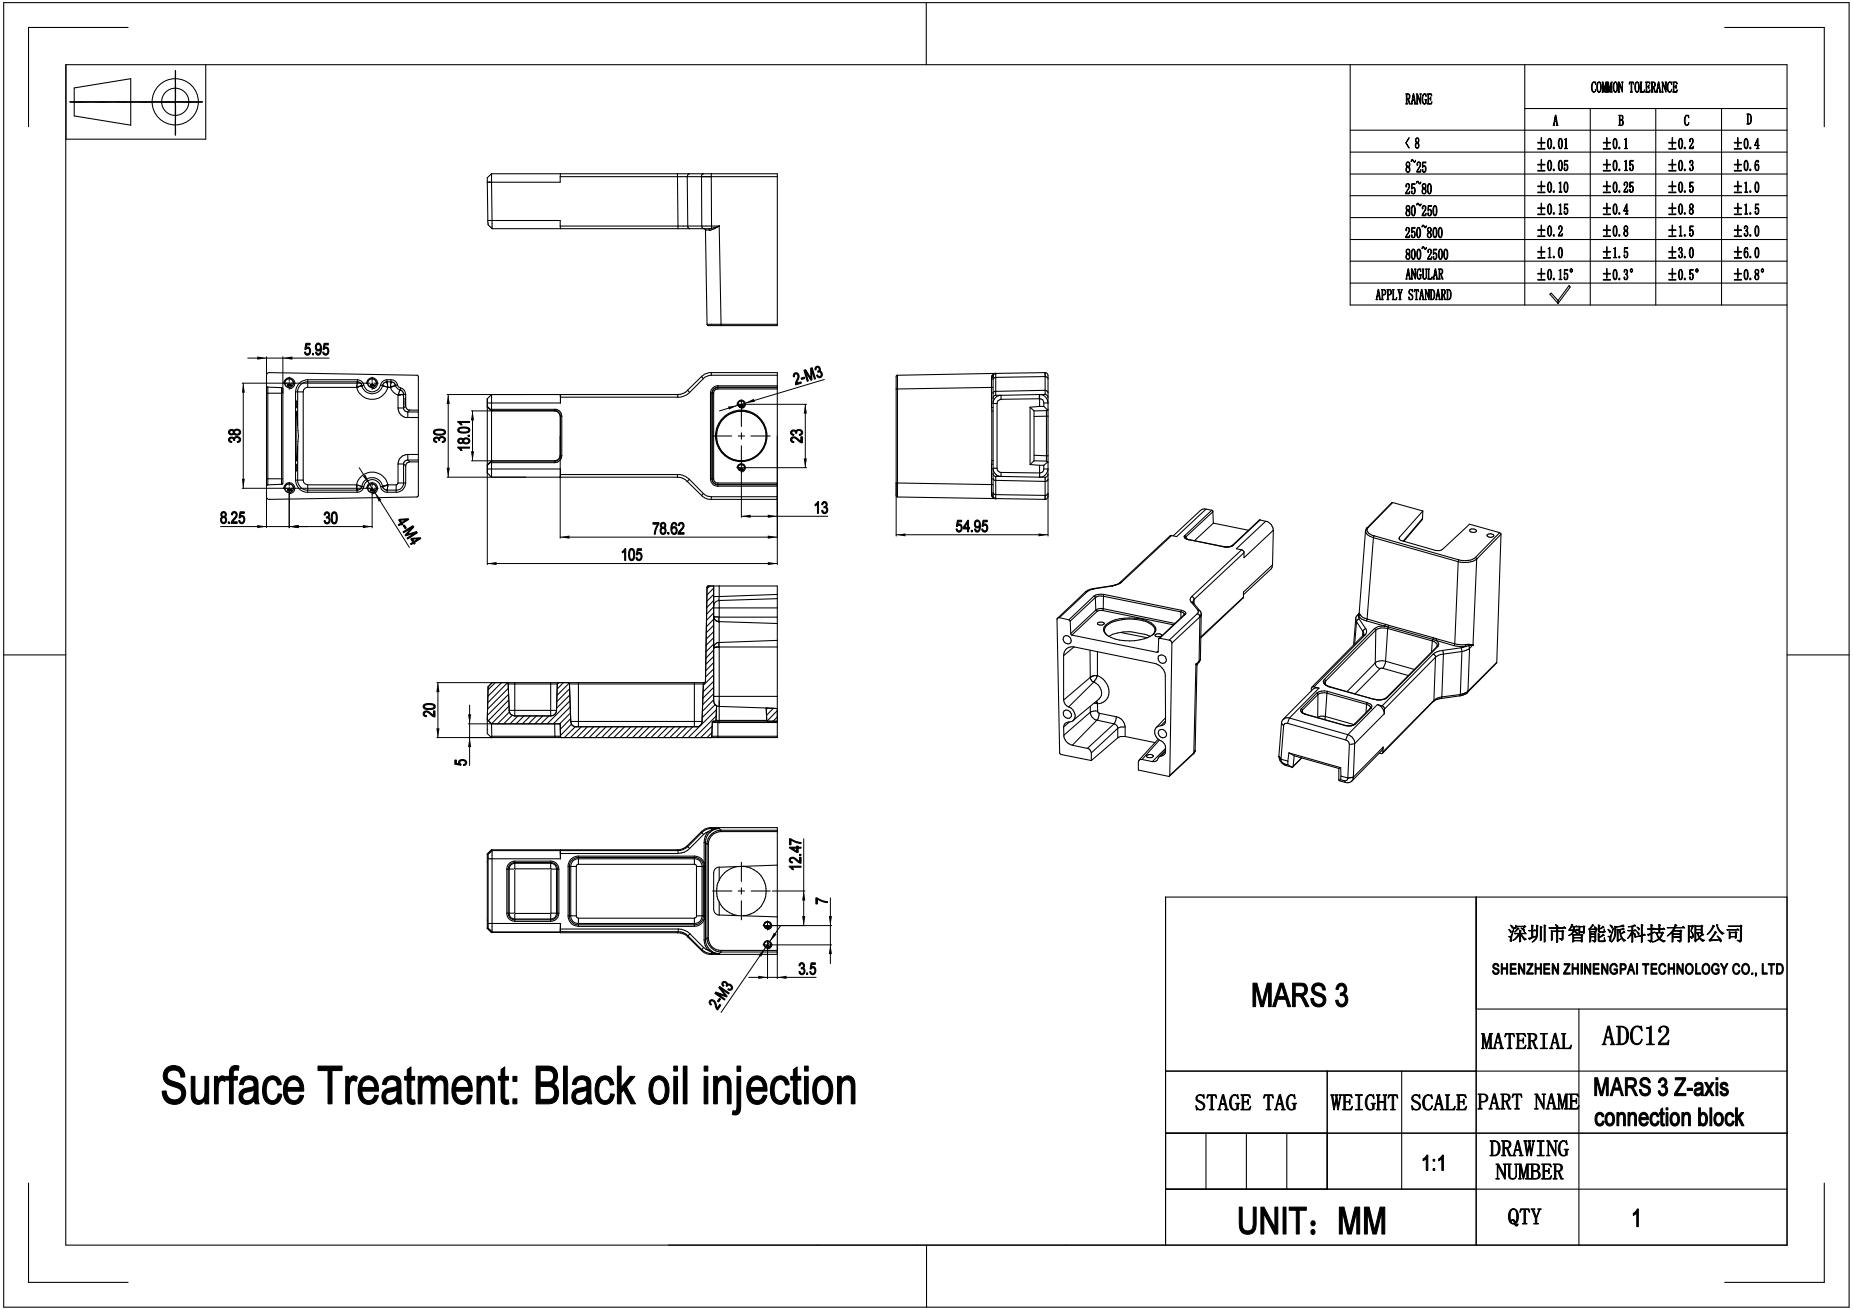
[picture p41: page 1]
