elegooofficial/Mars3/MARS 3  Mechanical/PDF/MARS pro - Plastic clearance nut-Model.pdf

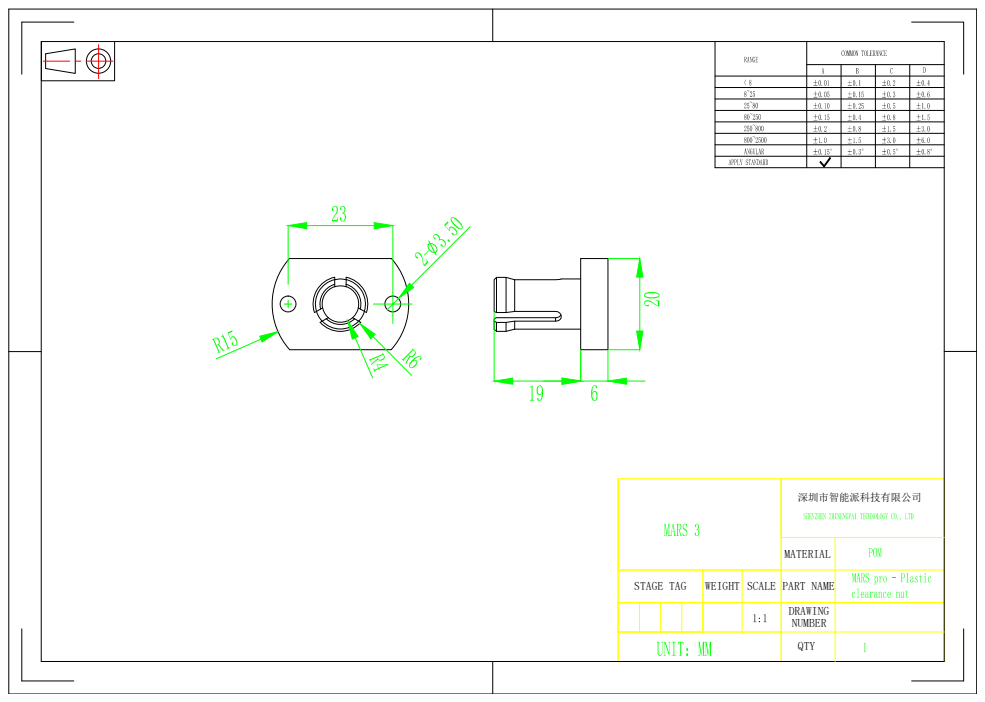
[picture p42: page 1]
