elegooofficial/Mars3/MARS 3  Mechanical/PDF/PTZ ball-Model.pdf

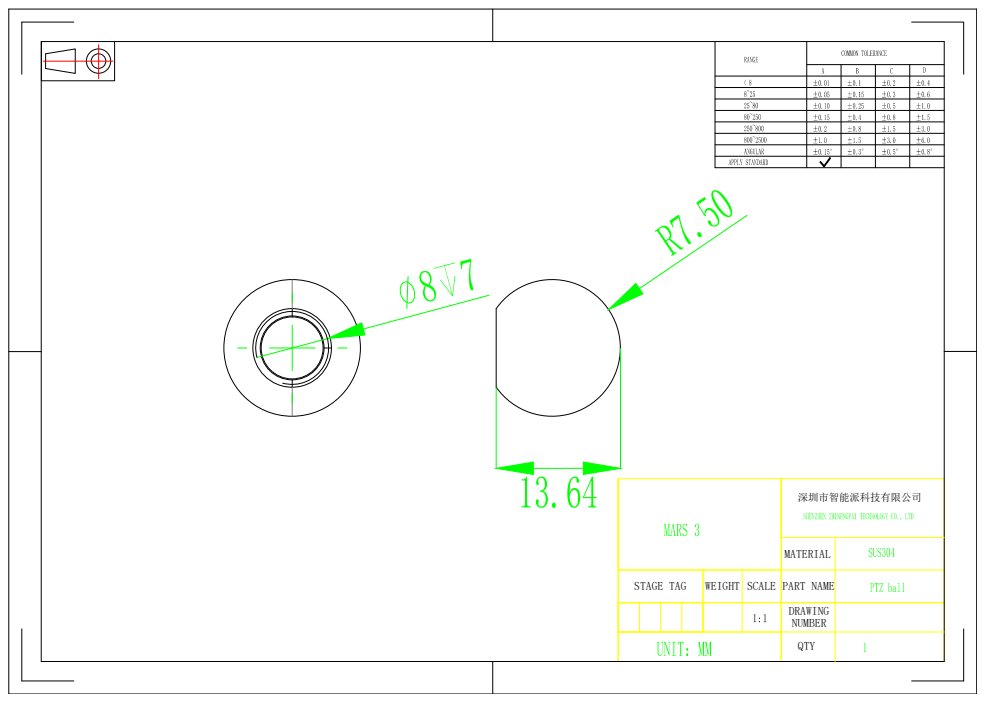
[picture p43: page 1]
