elegooofficial/Mars3/MARS 3  Mechanical/PDF/Spring 0.8x12x35-Model.pdf

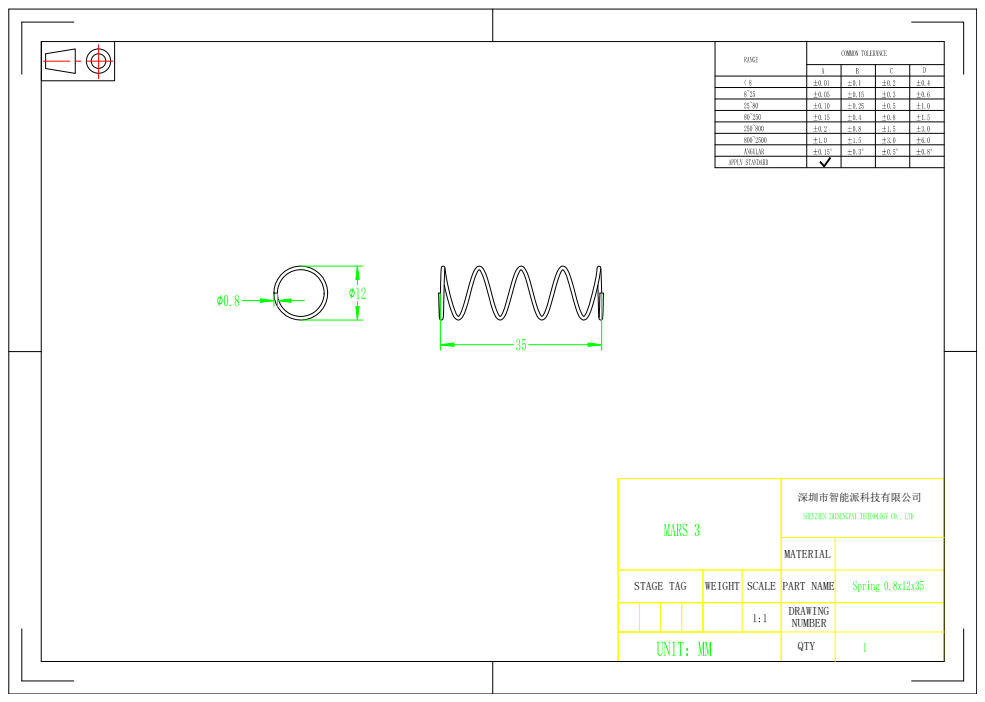
[picture p44: page 1]
