elegooofficial/Mars3/MARS 3  PCB/MARS 3 -Constant-current module/贴片坐标文件/XL4016_buck.pdf

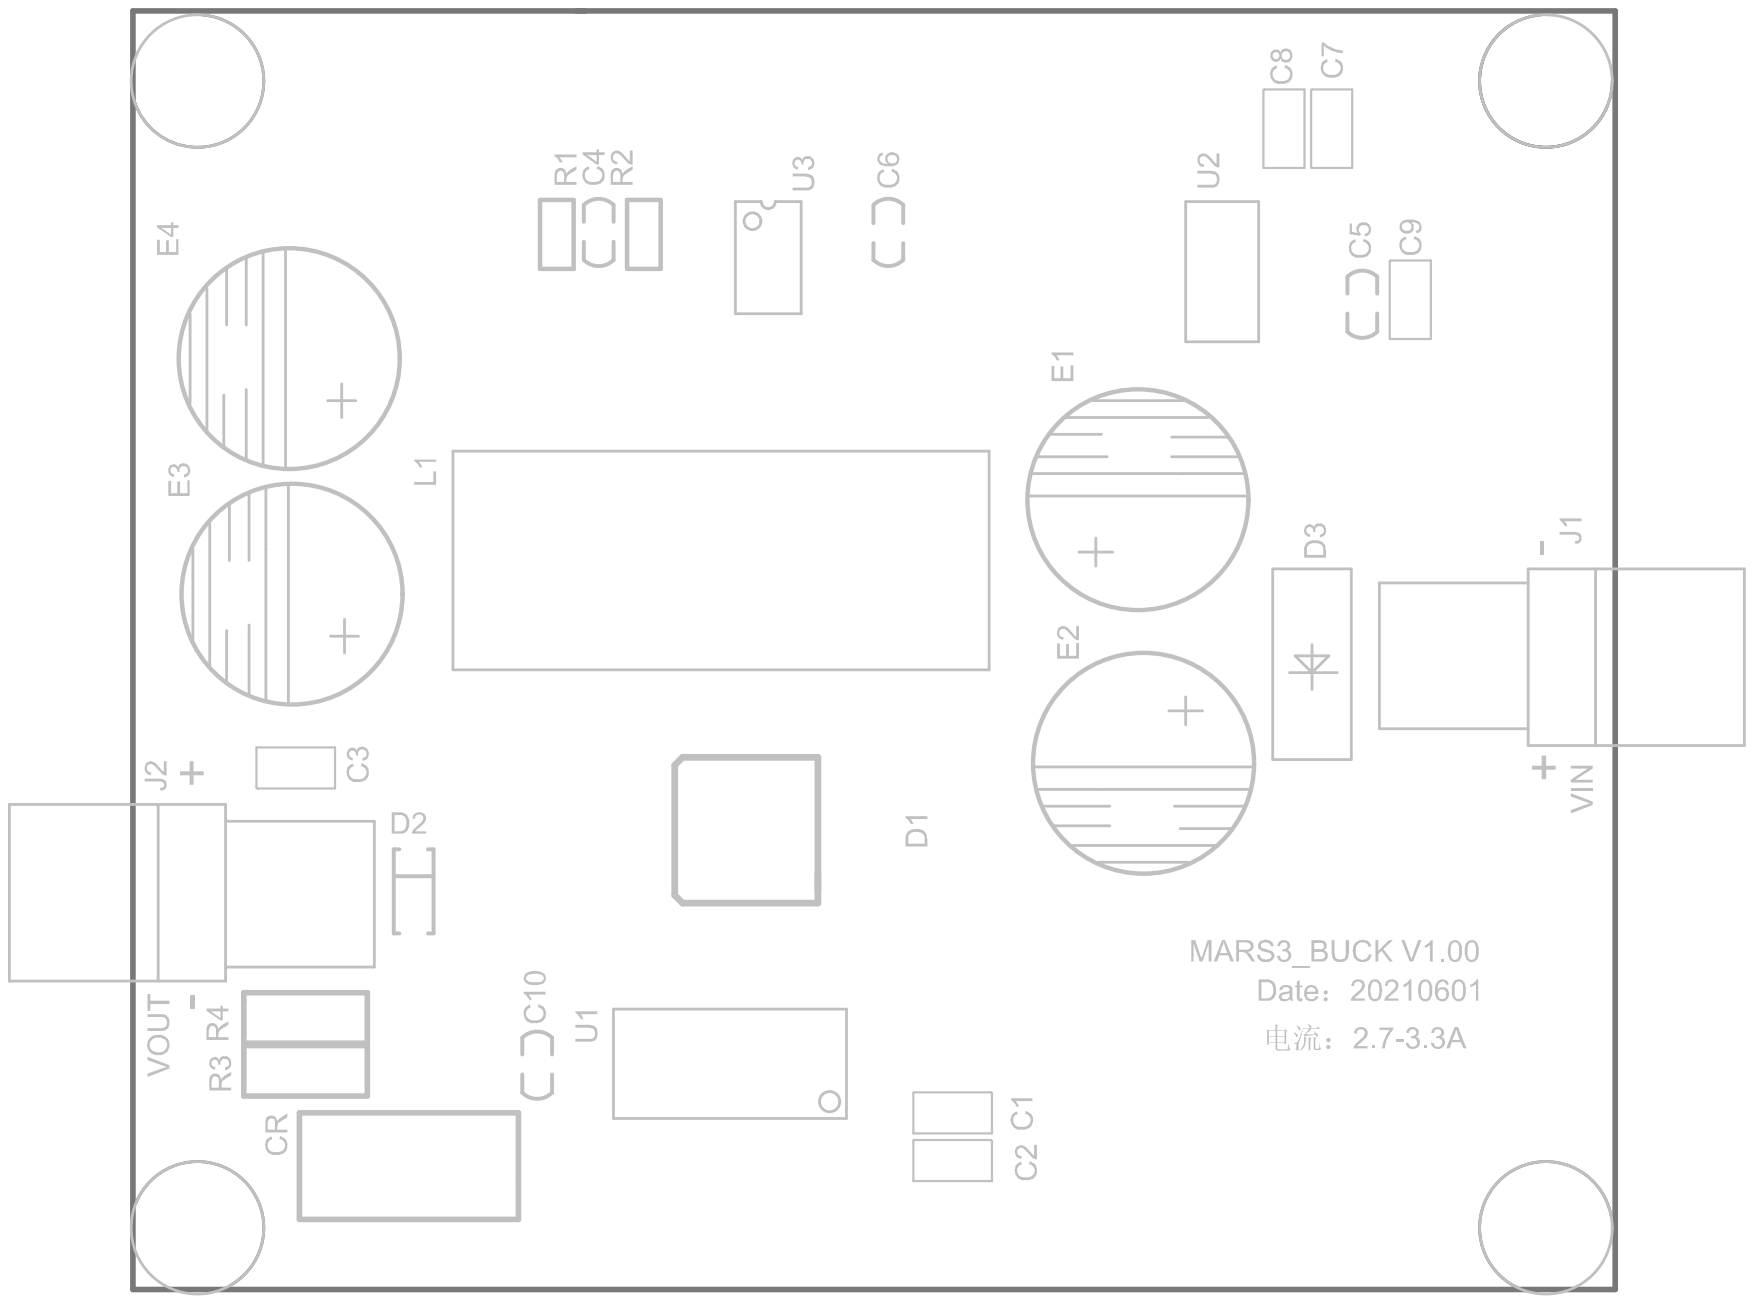
[picture p45: page 1]
