elegooofficial/Mars3/(list of files, drawings)

Other design files:
MARS 3 PCB/MARS 3 - PCB-power/pcb&sch/MARS3.SchDoc
MARS 3 PCB/MARS 3 - PCB-power/pcb&sch/mars3_CON.PcbDoc
MARS 3 PCB/MARS 3 -Constant-current module/SCH&PCB/XL4016.SchDoc
MARS 3 PCB/MARS 3 -Constant-current module/SCH&PCB/XL4016_buck.PcbDoc
MARS 3 PCB/MARS 3 series- Limit switch cable/SCH&PCB/Sheet1.SchDoc
MARS 3 PCB/MARS 3 series- Limit switch cable/SCH&PCB/光耦转接板.PcbDoc
